sangseu/kicad/project/charger v2/pics/48V1A.png

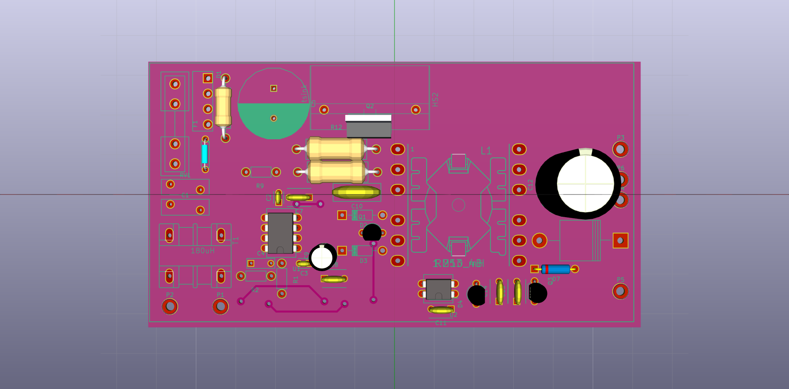
project/charger v2/pics/48V1A.png
