sangseu/kicad/project/charger v2/v1.jpg

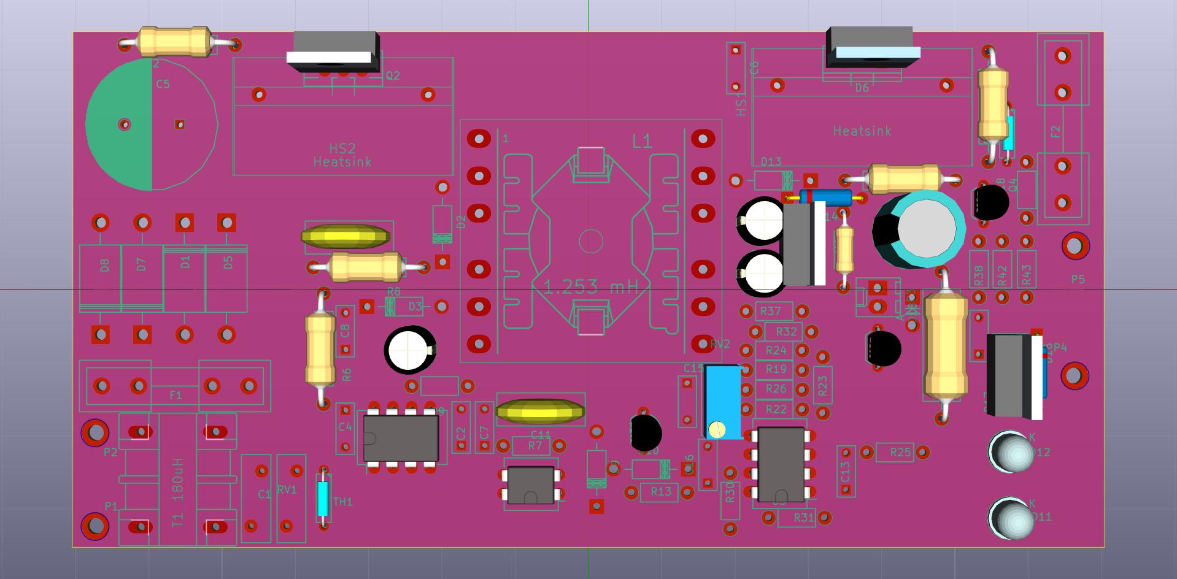
project/charger v2/v1.jpg
