sangseu/kicad/project/README.txt

log
===
1. chager v1: so cap, phan hoi dien ap dung thong so. Mach dieu khien dong sac, dieu khien ngat sac SAI
2. 48V-1A: chay OK nhow su giup so cua anh Toan
3. 48V-2A. 48V-3A SAI
