sangseu/kicad/project/charger v2/linh_kien.pdf

››Giỏ hàng của bạn có: 144(SP),Tổng số tiền: 179100 VNĐ (flow.php) | Mua Hàng Online: 1900.03.44
(https://www.youtube.com/channel/UCSeca92q0ZaRIcLOcsNsQyg/) | (article-506-tra-cuu-ma-van-don.html)
(article_cat-36-tin-tuc.html) | (https://www.youtube.com/channel/UCSeca92q0ZaRIcLOcsNsQyg/) | (article_cat-40-download.html)
(article-450-gio-lam-viec-va-thong-tin-lien-he.html) | (http://banlinhkien.vn/article-471-phuong-thuc-thanh-toan-mua-hang-online.html)
(http://mcu.banlinhkien.vn) | (article-625-trung-tam-bao-hanh.html)

(user.php)

## Đăng

nhập (user.php) | Đăng ký (user.php?act=register)
Tất cả danh mục | Tìm kiếm... | Tìm kiếm

(http://banlinhkien.vn)

Vị trí » Trang chủ (.) > Sản phẩm trong giỏ hàng của bạn:

Từ khóa HOT ： Vi Điều Khiển (search.php?keywords=Vi+%C4%90i%E1%BB%81u+Khi%E1%BB%83n) Mạch Nạp (search.php?keywords=+M%E1%BA%A1ch+N

%E1%BA%A1p) LED (search.php?keywords=+LED) KIT (search.php?keywords=+KIT) Cảm Biến (search.php?keywords=+C%E1%BA%A3m+Bi%E1%BA%BFn)

Module (search.php?keywords=+Module) Thiết Bị Kỹ Thuật (search.php?keywords=+Thi%E1%BA%BFt+B%E1%BB%8B+K%E1%BB%B9+Thu%E1%BA%ADt)

## Danh sách SP

Tên SP | Thuộc tính | Giá | SL | Tổng | Thao Tác
(goods.php?id=936) Tụ Gốm 103 10nF 50V ( 10C) (goods.php?id=936) | | 1000 VNĐ | | | | 1000 VNĐ | [X]Xóa
(goods.php?id=1369) TIP122 TO220 TRANS DarLingTon NPN 5A 100V (goods.php?id=1369) | | 3000 VNĐ | | | | 6000 VNĐ | [X]Xóa
(goods.php?id=1372) BT151-500R TO220 THYRISTOR 12A 500V (goods.php?id=1372) | | 4500 VNĐ | | | | 9000 VNĐ | × [X]Xóa

1

2

2

(https://www.youtube.com

/channel

/UCSeca92q0ZaRIcLOcsNsQ (https://www.facebook.com

/banlinhkienMH

(https://plus.google.com

/+LinhKi

%E1%BB

%87n%C4

%90i%E1

%BB%87nT

%E1%BB

%ADMinhH

%C3%A0

## Hỗ Trợ Khách Hàng Và Kỹ Thuật

Sản phẩm trong giỏ hàng của bạn:_Linh Kiện Điệ... | http://banlinhkien.vn/flow.php
1 of 10 | 03/16/2017 05:53 PM

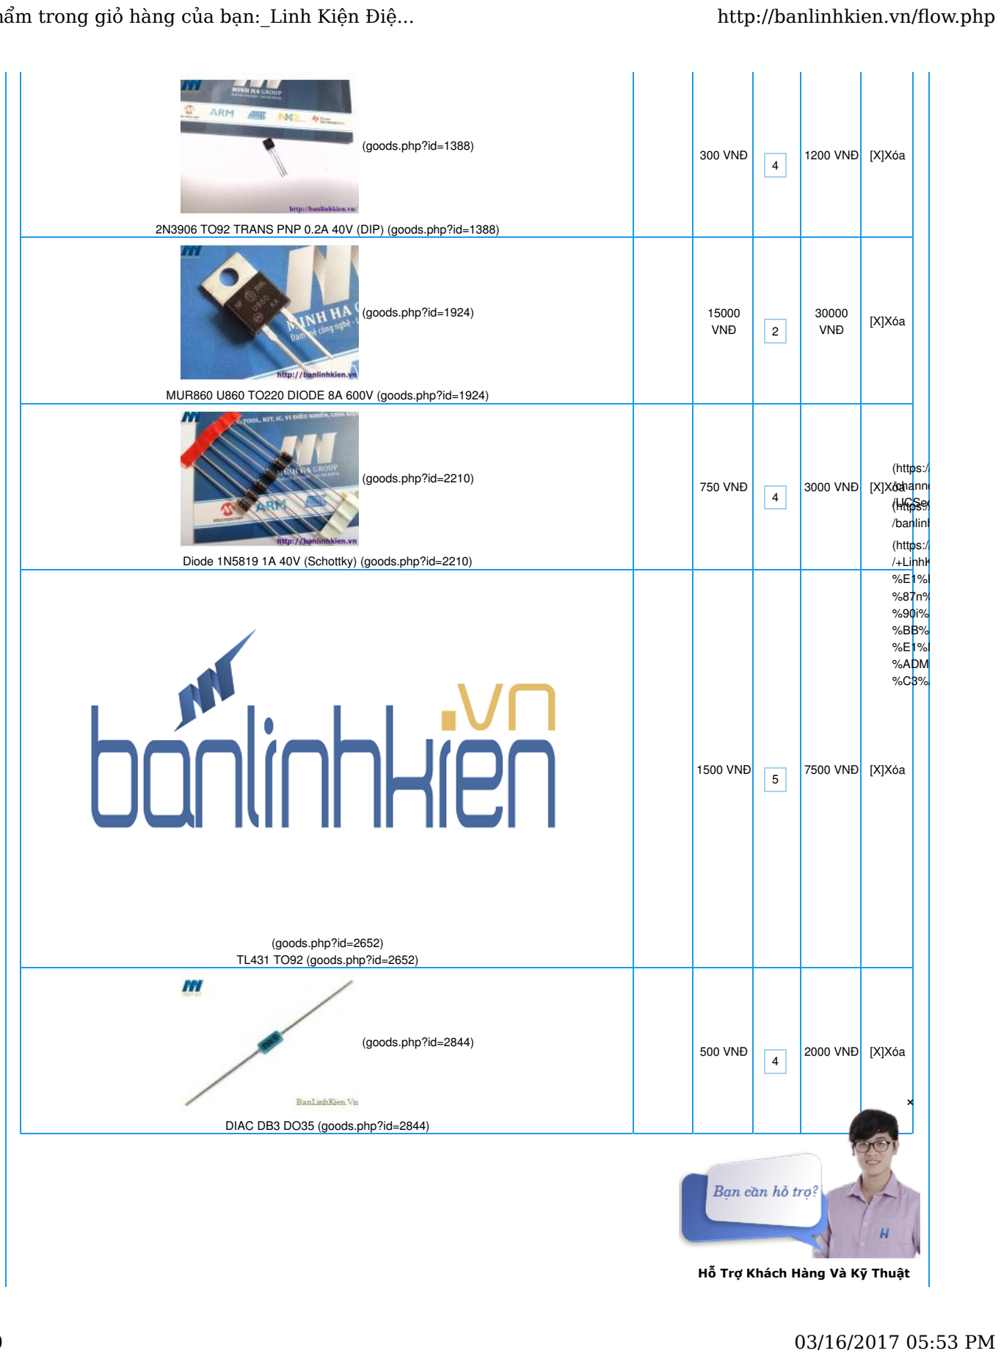
[picture p172: figure]
(goods.php?id=1388); 300 VNĐ; 1200 VNĐ; [X]Xóa; (goods.php?id=1924); VNĐ; (goods.php?id=2652) TL431 TO92 (goods.php?id=2652); 1500 VNĐ; 7500 VNĐ; (goods.php?id=2844) DIAC DB3 DO35 (goods.php?id=2844); 500 VNĐ; 2000 VNĐ; [X]Xóa ×; (https://www.youtube.com; /channel; /UCSeca92q0ZaRIcLOcsNsQ (https://www.facebook.com; /banlinhkienMH; (https://plus.google.com; /+LinhKi; %ADMinhH; Hỗ Trợ Khách Hàng Và Kỹ Thuật

2N3906 TO92 TRANS PNP 0.2A 40V (DIP) (goods.php?id=1388)

MUR860 U860 TO220 DIODE 8A 600V (goods.php?id=1924)

(goods.php?id=2210) Diode 1N5819 1A 40V (Schottky) (goods.php?id=2210) | 750 VNĐ | 3000 VNĐ | [X]Xóa

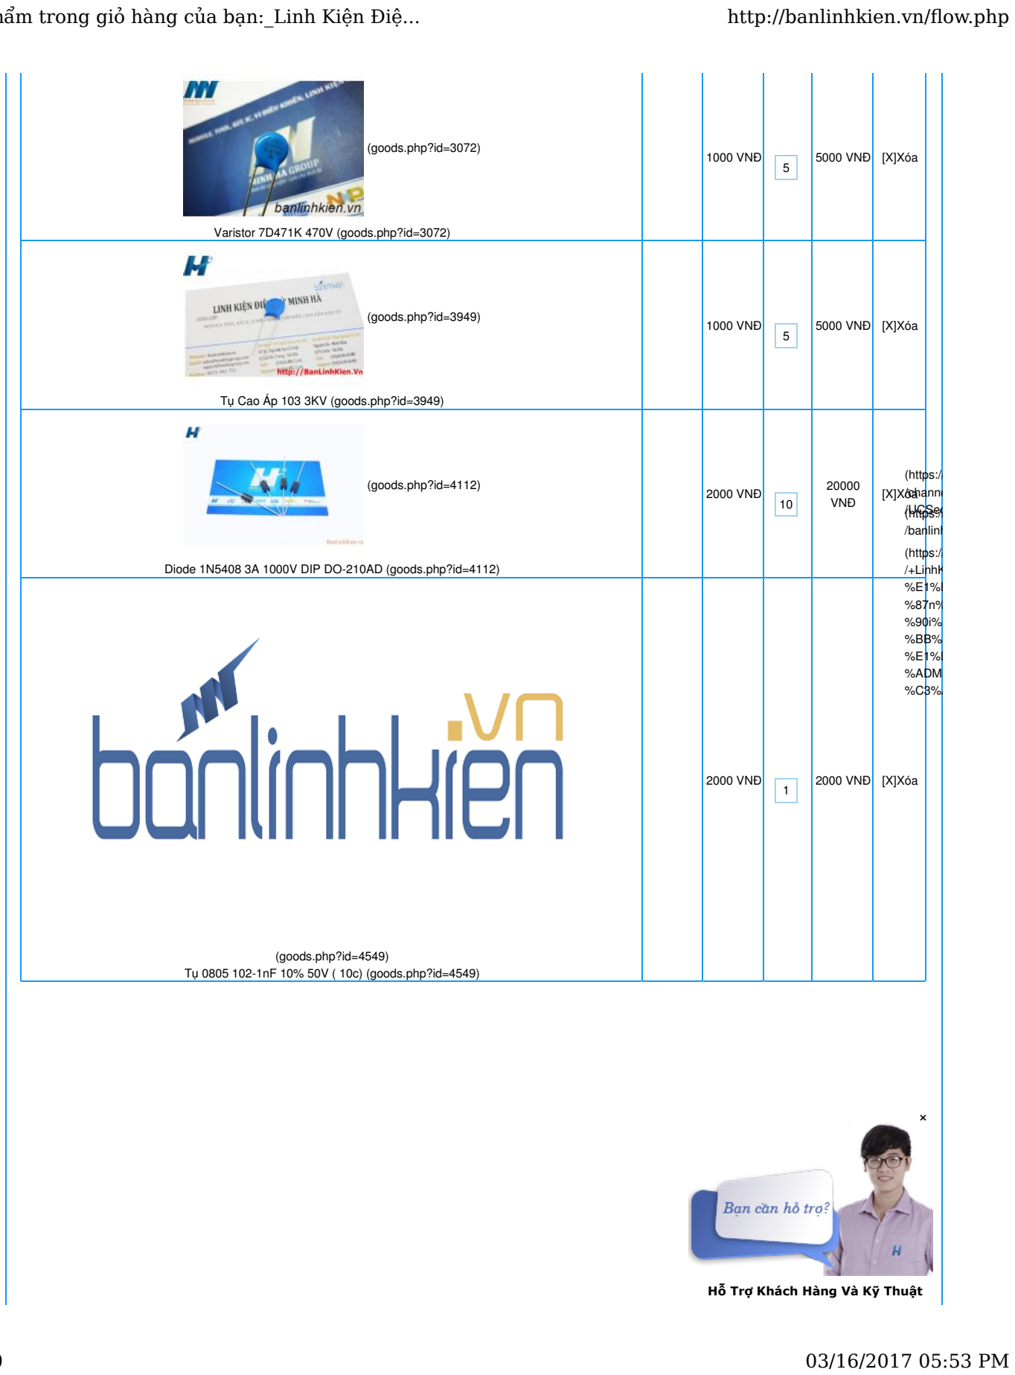
[picture p173: figure]
(goods.php?id=3072); 1000 VNĐ; 5000 VNĐ; [X]Xóa; /channel; /banlinhkienMH; (https://plus.google.com; /+LinhKi; %ADMinhH; Hỗ Trợ Khách Hàng Và Kỹ Thuật

Varistor 7D471K 470V (goods.php?id=3072)

(goods.php?id=3949) Tụ Cao Áp 103 3KV (goods.php?id=3949) | 1000 VNĐ | 5000 VNĐ | [X]Xóa
(goods.php?id=4112) Diode 1N5408 3A 1000V DIP DO-210AD (goods.php?id=4112) | 2000 VNĐ | | 20000 VNĐ | [X]Xóa
(goods.php?id=4549) Tụ 0805 102-1nF 10% 50V ( 10c) (goods.php?id=4549) | 2000 VNĐ | | 2000 VNĐ | [X]Xóa

(https://www.youtube.com

/UCSeca92q0ZaRIcLOcsNsQ (https://www.facebook.com

(goods.php?id=4551)
Tụ 0805 104-100nF 10% 50V (10c) (goods.php?id=4551)

2000 VNĐ
1
2000 VNĐ | [X]Xóa
(goods.php?id=4708) S8050 SOT23 Trans NPN 0.5A 40V (SMD-J3Y) (goods.php?id=4708) | 300 VNĐ | 1500 VNĐ | [X]Xóa
(goods.php?id=4761) Tụ Gốm 104 100nF 50V ( 10c) (goods.php?id=4761) | 1000 VNĐ | 1000 VNĐ | [X]Xóa
(goods.php?id=4776) Tụ gốm 470p 471 50V( 10C) (goods.php?id=4776) | 1000 VNĐ | 1000 VNĐ | [X]Xóa
(goods.php?id=4777) Tụ gốm 472-4.7nF 50V (10c) (goods.php?id=4777) | 1000 VNĐ | 1000 VNĐ | [X]Xóa ×

5

1

1

1

(https://www.youtube.com

/channel

/UCSeca92q0ZaRIcLOcsNsQ (https://www.facebook.com

/banlinhkienMH

(https://plus.google.com

/+LinhKi

%E1%BB

%87n%C4

%90i%E1

%BB%87nT

%E1%BB

%ADMinhH

%C3%A0

## Hỗ Trợ Khách Hàng Và Kỹ Thuật

(goods.php?id=4948)

Trở Vạch 1/4W 5% 15K (50c) (goods.php?id=4948)

2000 VNĐ
1
2000 VNĐ | [X]Xóa
(goods.php?id=4957) Trở Vạch 1/4W 5% 20K (50c) (goods.php?id=4957) | 2000 VNĐ | 2000 VNĐ | [X]Xóa
(goods.php?id=4964) Trở Vạch 1/4W 5% 27K (50c) (goods.php?id=4964) | 2000 VNĐ | | 2000 VNĐ | [X]Xóa
(goods.php?id=4967) Trở Vạch 1/4W 5% 3.9K (50c) (goods.php?id=4967) | 2000 VNĐ | | 2000 VNĐ | [X]Xóa
(goods.php?id=4991) Trở Vạch 1/4W 5% 56K (50c) (goods.php?id=4991) | 2000 VNĐ | | 2000 VNĐ | [X]Xóa
(goods.php?id=4996) Trở Vạch 1/4W 5% 7.5K (50c) (goods.php?id=4996) | 2000 VNĐ | | 2000 VNĐ | [X]Xóa
(goods.php?id=5164) Gen Co Nhiệt Phi 10 Đen (1 Mét) (goods.php?id=5164) | 9000 VNĐ | | 9000 VNĐ | × [X]Xóa

1

1

1

1

1

1

(https://www.youtube.com

/channel

/UCSeca92q0ZaRIcLOcsNsQ (https://www.facebook.com

/banlinhkienMH

(https://plus.google.com

/+LinhKi

%E1%BB

%87n%C4

%90i%E1

%BB%87nT

%E1%BB

%ADMinhH

%C3%A0

## Hỗ Trợ Khách Hàng Và Kỹ Thuật

(goods.php?id=5251)

Trở 0805 5% 100R (50c) (goods.php?id=5251)

2000 VNĐ
1
2000 VNĐ | [X]Xóa
(goods.php?id=5305) Trở 0805 5% 3.3K (50c) (goods.php?id=5305) | 2000 VNĐ | 2000 VNĐ | [X]Xóa
(goods.php?id=5312) Trở 0805 5% 8.2K (50c) (goods.php?id=5312) | 2000 VNĐ | | 2000 VNĐ | [X]Xóa
(goods.php?id=5479) Trở 0805 1% 49.9K (50c) (goods.php?id=5479) | 4000 VNĐ | | 4000 VNĐ | [X]Xóa
(goods.php?id=5704) Diode FR207 2A 1000V ( DIP) (goods.php?id=5704) | 500 VNĐ | | 2500 VNĐ | [X]Xóa

1

1

1

5

(https://www.youtube.com

/channel

/UCSeca92q0ZaRIcLOcsNsQ (https://www.facebook.com

/banlinhkienMH

(https://plus.google.com

/+LinhKi

%E1%BB

%87n%C4

%90i%E1

%BB%87nT

%E1%BB

%ADMinhH

%C3%A0

## Hỗ Trợ Khách Hàng Và Kỹ Thuật

×

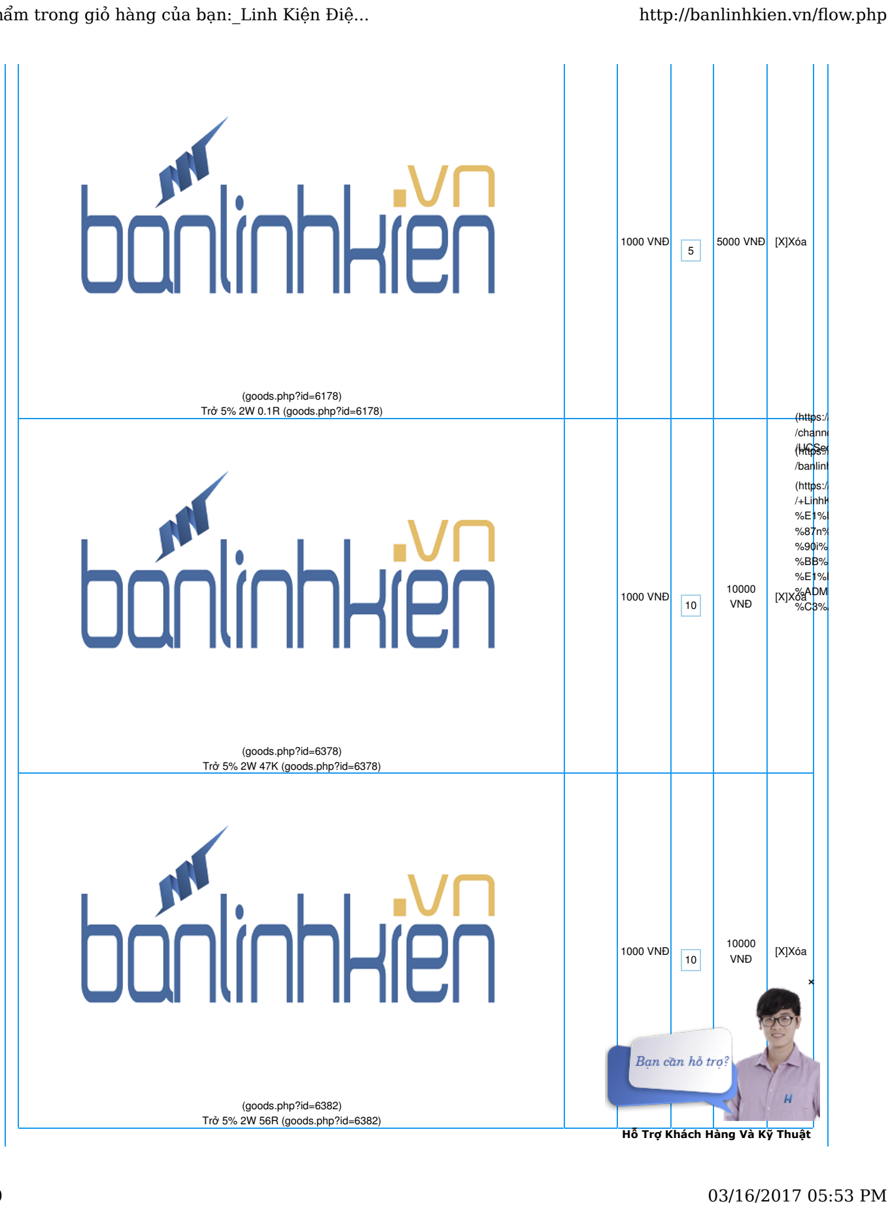
[picture p174: figure]
(goods.php?id=6178); Trở 5% 2W 0.1R (goods.php?id=6178); 1000 VNĐ; 5000 VNĐ; [X]Xóa; /channel; /banlinhkienMH; (https://plus.google.com; /+LinhKi; %ADMinhH; Hỗ Trợ Khách Hàng Và Kỹ Thuật

(goods.php?id=6378) Trở 5% 2W 47K (goods.php?id=6378) | 1000 VNĐ | 10000 VNĐ | [X]Xóa
(goods.php?id=6382) Trở 5% 2W 56R (goods.php?id=6382) | 1000 VNĐ | 10000 VNĐ | [X]Xóa ×

(https://www.youtube.com

/UCSeca92q0ZaRIcLOcsNsQ (https://www.facebook.com

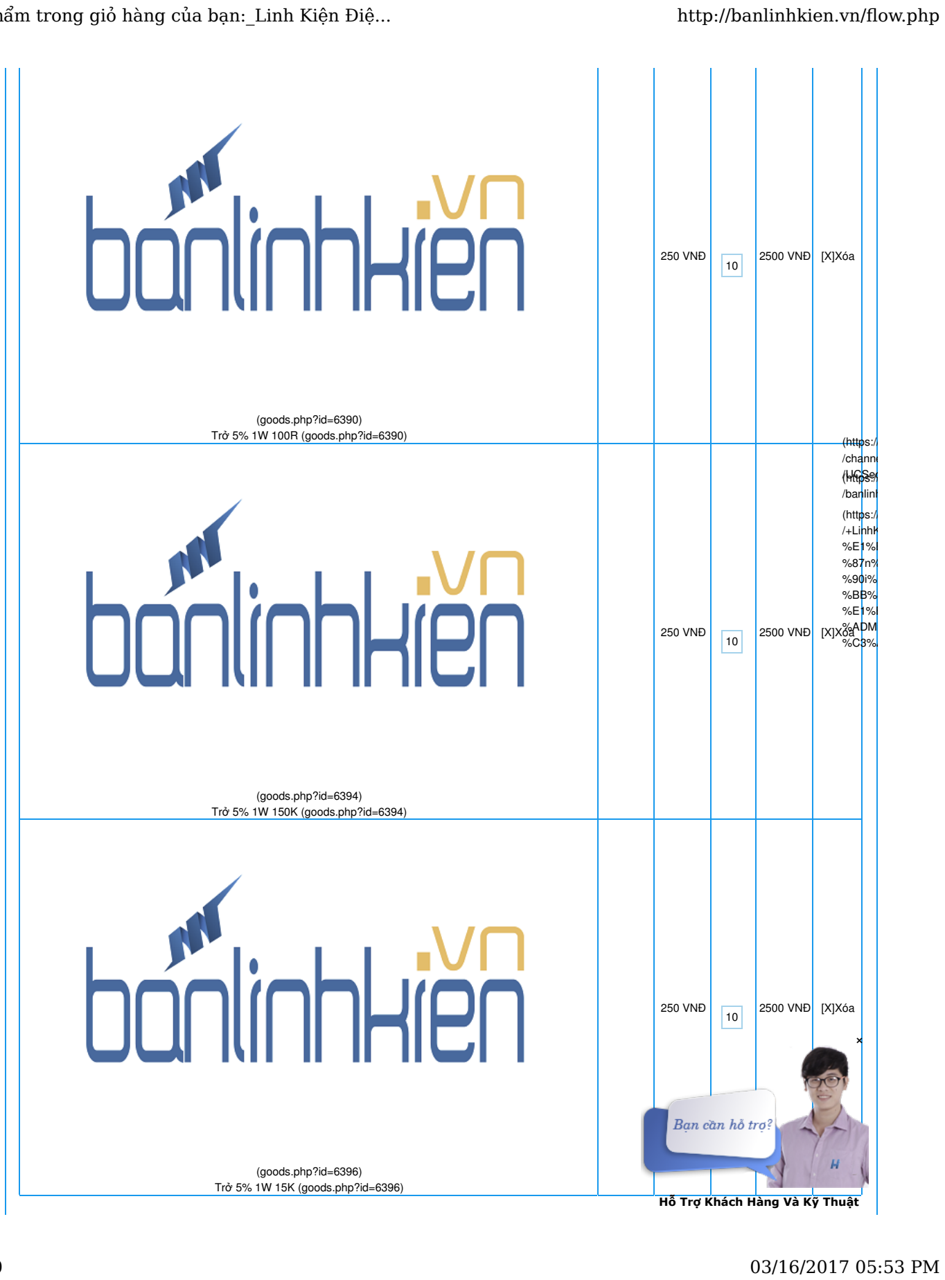
[picture p175: figure]
(goods.php?id=6390); Trở 5% 1W 100R (goods.php?id=6390); 250 VNĐ; 2500 VNĐ; [X]Xóa; /channel; /banlinhkienMH; (https://plus.google.com; /+LinhKi; %ADMinhH; Hỗ Trợ Khách Hàng Và Kỹ Thuật

(goods.php?id=6394) Trở 5% 1W 150K (goods.php?id=6394) | 250 VNĐ | 2500 VNĐ | [X]Xóa
(goods.php?id=6396) Trở 5% 1W 15K (goods.php?id=6396) | 250 VNĐ | 2500 VNĐ | [X]Xóa ×

(https://www.youtube.com

/UCSeca92q0ZaRIcLOcsNsQ (https://www.facebook.com

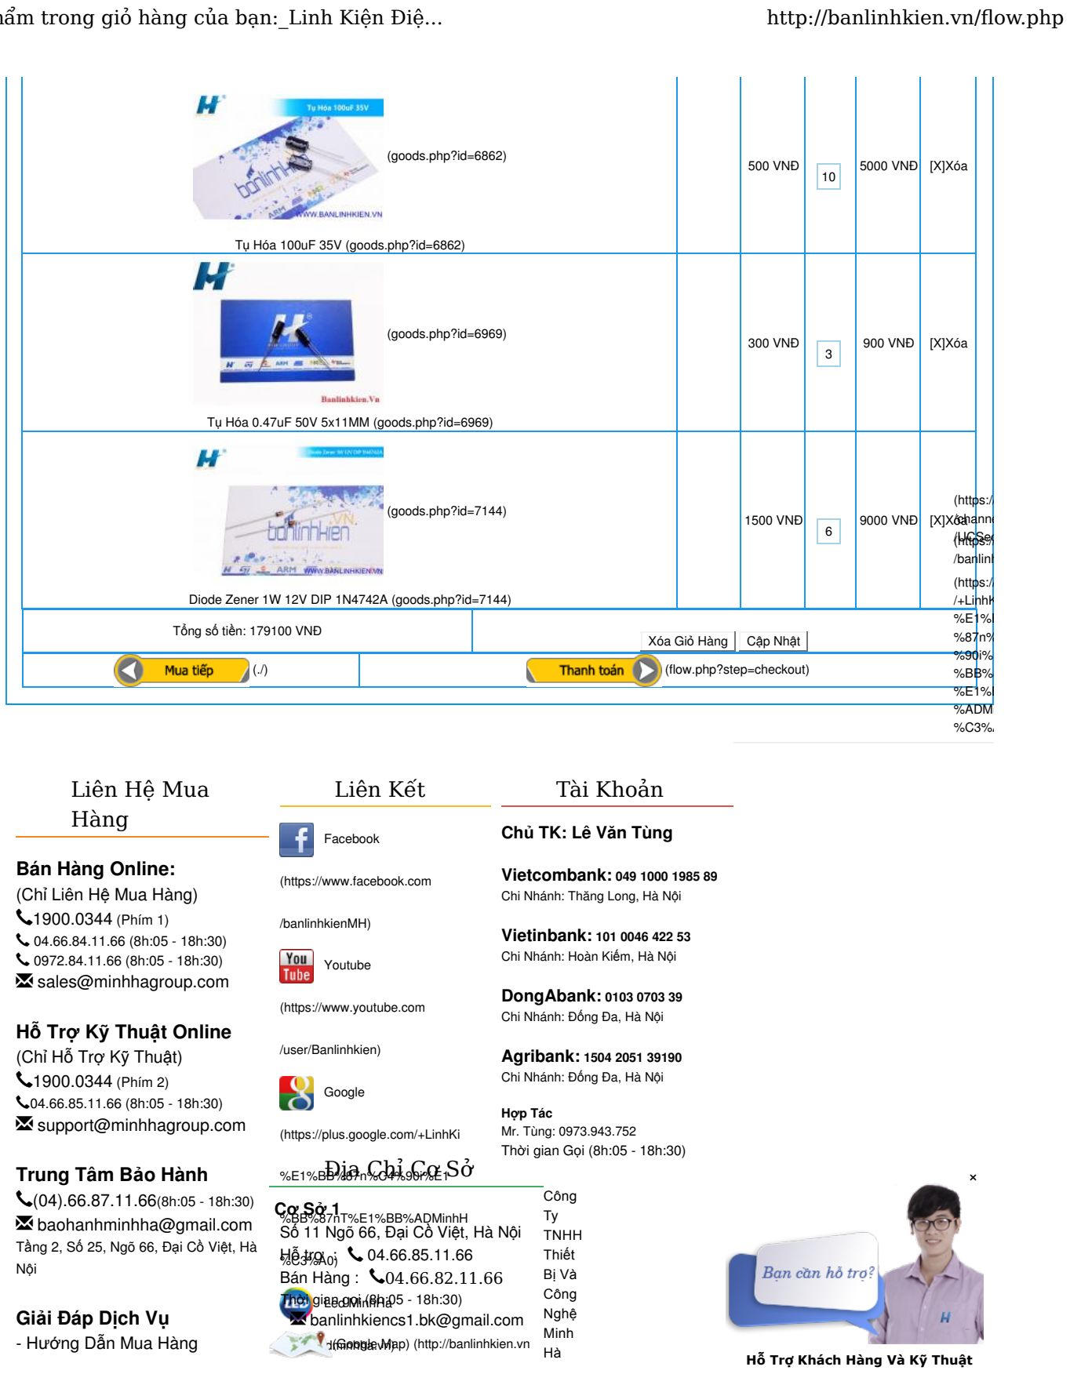
[picture p176: figure]
Liên Hệ Mua Hàng; Bán Hàng Online:; (Chỉ Liên Hệ Mua Hàng); 1900.0344 (Phím 1); sales@minhhagroup.com; Hỗ Trợ Kỹ Thuật Online; (Chỉ Hỗ Trợ Kỹ Thuật); 1900.0344 (Phím 2); support@minhhagroup.com; Trung Tâm Bảo Hành; baohanhminhha@gmail.com; Tầng 2, Số 25, Ngõ 66, Đại Cồ Việt, Hà; Nội; Giải Đáp Dịch Vụ; - Hướng Dẫn Mua Hàng; Liên Kết; Facebook; (https://www.facebook.com; /banlinhkienMH); Youtube; (https://www.youtube.com; /user/Banlinhkien); Google; (https://plus.google.com/+LinhKi; %BB%87nT%E1%BB%ADMinhH; Led MinhHa; (http://ledminhha.vn); Tài Khoản; Chủ TK: Lê Văn Tùng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

(goods.php?id=6969) Tụ Hóa 0.47uF 50V 5x11MM (goods.php?id=6969) | 300 VNĐ | 900 VNĐ | [X]Xóa
(goods.php?id=7144) Diode Zener 1W 12V DIP 1N4742A (goods.php?id=7144) | 1500 VNĐ | | 9000 VNĐ | [X]Xóa

(http://www.online.gov.vn/HomePage/CustomWebsiteDisplay.aspx?DocId=10200)

## - Hành Trình Bưu

## - Giải Đáp Thắc Mắc

## - Than Phiền Dịch Vụ

0965.89.11.66 (8h:05 - 18h:30)

## 1900.0344 (Phím 0)

### Giới Thiệu

### Đặt mua linh kiện

### (http://banlinhkien.vn/article-

### 473-dat-mua-linh-kien.html)

### Mua hàng & Thanh Toán

### (http://banlinhkien.vn/article-

### 471-phuong-thuc-thanh-toan-mua-

### hang-online.html)

### Đổi, trả hàng và hoàn tiền

### (http://banlinhkien.vn/article-

### 513-chinh-sach-doi-tra-hang-

### va-hoan-tien.html)

### Bảo mật thông tin

### (http://banlinhkien.vn/article-

### 515-chinh-sach-bao-mat-thong-

### tin-khach-hang.html)

Diễn Đàn Vi Điều Khiển

(http://mcu.banlinhkien.vn)

/article-516-cua-hang-ban-linh-kien-co-so-

1.html#.VKDB-PaAEI)

## Cơ Sở 2

Số 2 ngách 132/86 Nguyên Xá,

### Đường 32, Từ Liêm

Hỗ trợ: | 04.66.86.66.41
Bán hàng : | 04.66.86.66.40

Thời gian gọi (8h:05 - 18h:30)

### banlinhkien.dhcn@gmail.com

(Google Map) (http://banlinhkien.vn

/article-520-linh-kien-dien-tu-minh-ha-co-

so-2.html)

## Cơ Sở 3

### 25 Đặng Thùy Trâm, Cầu Giấy

Hỗ trợ | : | 04.66.54.25.25
Bán hàng : | 04.66.52.25.25

Thời gian gọi (8h:05 - 18h:30)

### banlinhkiencs3.hvqs@gmail.com

(Google Map) (http://banlinhkien.vn

/article.php?id=606)

## Cơ Sở 4 (COMING SOON)

### 106/5 Nguyễn Kim - P.6 - Q.10 -

### HCM

## Trụ sở: Đại Vĩ - Liên Hà - Đông Anh - Hà Nội GPĐKKD Số: 01.05.165.062 Do Sở KH VÀ ĐT TP.HN cấp ngày: 28.02.2011

(http://www.dmca.com/Protection/Status.aspx?ID=7d46bd30-a53e-43a5-

a925-9baaa62549b7&refurl=http://banlinhkien.vn/)

✉

✉

(https://www.youtube.com

/channel

/UCSeca92q0ZaRIcLOcsNsQ (https://www.facebook.com

/banlinhkienMH

(https://plus.google.com

/+LinhKi

%E1%BB

%87n%C4

%90i%E1

%BB%87nT

%E1%BB

%ADMinhH

%C3%A0

## Hỗ Trợ Khách Hàng Và Kỹ Thuật

×
