sangseu/kicad/project/charger v2/linhkien.pdf

v1

Id Designator | Package | Quantity
70 C13,C16 | C_Rect_L7_W2.5_P5 | 2
42 R35 | Resistor_Horizontal_RM20mm | 1
57 R12 | Resistor_Horizontal_RM15mm | 1
20L1 | trafo-siemens-RM8-12A | 1
2 C1 | RV_Disc_D12_W4_P7.5 | 1
3 C4,C8,C19 | C_Rect_L7_W2.5_P5 | 3
45 R39 | R_0805_HandSoldering | 1
41 R34 | Resistor_Horizontal_RM10mm | 1
66 C17 | C_Radial_D6.3_L11.2_P2.5 | 1
6 C10,C11 | C_Disc_D12_P7.75 | 2
28 R2,R4,R28,R29 | R_0805_HandSoldering | 4
32 R10,R33 | R_0805_HandSoldering | 2
49 RV1 | RV_Disc_D12_W3.9_P7.5 | 1
30 R6 | Resistor_Horizontal_RM15mm | 1
29 R5 | R_0805_HandSoldering | 1
48 R43,R38 | Resistor_Horizontal_RM7mm | 2
35 R15 | Resistor_Horizontal_RM15mm | 1
51 T1 | inductors-MFE | 1
33 R11,R14 | R_0805_HandSoldering | 2
34 R13,R30,R31,R32,R26,R7,R25 Resistor_Horizontal_RM7mm | 7
76 R22 | Resistor_Horizontal_RM7mm | 1
12 D9,D10 | Diode_DO-41_SOD81_Horizontal_RM10 | 2
75 D18 | Diode_DO-41_SOD81_Vertical_AnodeUp | 1
8 D1,D5,D7,D8 | Diode_DO-201AD_Horizontal_RM15 | 4
10 D3 | Diode_DO-41_SOD81_Horizontal_RM10 | 1
61 C3 | C_0805_HandSoldering | 1
71 C15 | C_Rect_L7_W2.5_P5 | 1
43 R36,R41 | R_0805_HandSoldering | 2
47 R42 | Resistor_Horizontal_RM7mm | 1
25 Q2 | TO-220_Neutral123_Vertical_LargePads | 1
67 C18 | C_Radial_D6.3_L11.2_P2.5 | 1
7 C14 | C_0805_HandSoldering | 1
38 R18,R19 | Resistor_Horizontal_RM7mm | 2
27 Q4 | TO-92_Inline_Wide | 1
65 C12 | C_Radial_D10_L21_P5 | 1
37 R17 | R_0805_HandSoldering | 1
31 R9 | Resistor_Horizontal_RM7mm | 1
44 R37 | Resistor_Horizontal_RM7mm | 1
46 R40 | R_0805_HandSoldering | 1
40 R21 | R_0805_HandSoldering | 1
36 R16 | R_0805_HandSoldering | 1
60 C2 | C_Rect_L7_W2.5_P5 | 1
68 C7 | C_Rect_L7_W2.5_P5 | 1
64 C6 | C_Rect_L7_W2.5_P5 | 1
58 R8 | Resistor_Horizontal_RM15mm | 1
5 C9 | C_Radial_D6.3_L11.2_P2.5 | 1
73 R24 | Resistor_Horizontal_RM7mm | 1
72 R23 | Resistor_Horizontal_RM7mm | 1

63 R3 | Resistor_Horizontal_RM15mm | 1
52 TH1 | R3 | 1
53 TH2 | R3 | 1
4 C5 | C_Radial_D18_L36_P7.5 | 1
39 R20 | R_0805_HandSoldering | 1
59 R1 | R_0805_HandSoldering | 1
17 D17 | Diode_TO-220_Dual_CommonCathode_Vertical | 1
13 D11 | LED-5MM | 1
15 D14 | Diode_DO-35_SOD27_Horizontal_RM10 | 1
16 D16 | Diode_DO-35_SOD27_Horizontal_RM10 | 1
23 P3 | Molex_KK-6410-02_02x2.54mm_Straight | 1
9 D2,D13 | Diode_DO-41_SOD81_Horizontal_RM10 | 2
18 F1 | Fuseholder5x20_horiz_open_inline_Type-I | 1
69 F2 | Fuseholder5x20_horiz_open_inline_Type-I | 1
19 HS1,HS2 | heatsink-D03PA | 2
21 P1 | MountingHole_2.2mm_M2_DIN965_Pad | 1
22 P2 | MountingHole_2.2mm_M2_DIN965_Pad | 1
56 U3 | DIP-8_W7.62mm_LongPads | 1
62 D6 | Diode_TO-220_Vertical | 1
1 P4 | MountingHole_2.2mm_M2_DIN965_Pad | 1
24 P5 | MountingHole_2.2mm_M2_DIN965_Pad | 1
55 U2 | DIP-4_W7.62mm | 1
14 D12 | LED-5MM | 1
50 RV2 | Potentiometer_Bourns_3296W_3-8Zoll_Inline_ScrewUp | 1
26 Q3 | TO-220_Neutral123_Vertical | 1
11 D4,D15 | TO-92_Inline_Wide | 2
74 Q1 | SOT-23 | 1
54 U1 | DIP-8_W7.62mm_LongPads | 1

Page

3

Designation
103
0.1R-2W
0.33R-1W
1.253 mH
100 nF
100nF-50V
100R
100R-1W
100uF35V
103 2kv
10k
10R
14D471K
150K1W
15k
15k
15k-1W
180uH
1k
1k
1k-1%
1N4148
1N4148
1N5408
1N5819
1nF
1nF-50V
20k
20k
20N60
220uF16V
22pF25V
27k
2N3906
330uF100V
33k
33R2
3k
3k
3k
4.7k-1%
4.7nF
470pF50V
471 2kv ???
47k-2W
47uF50V
56k-1%
56k-1%

Page

4

56R-2W
5D-11
5D-13
68uF400V
10k
8.2k
BT151
charging
D_Z 12V
DIAC-DB3
FAN
FR207
Fuse-2A
Fuse-5A
Heatsink
IN1
IN2
LM358
MUR860
OUT-OUT+
PC817
power
RV-2k
TIP122
TL431LP
tran-S8050
UC3842

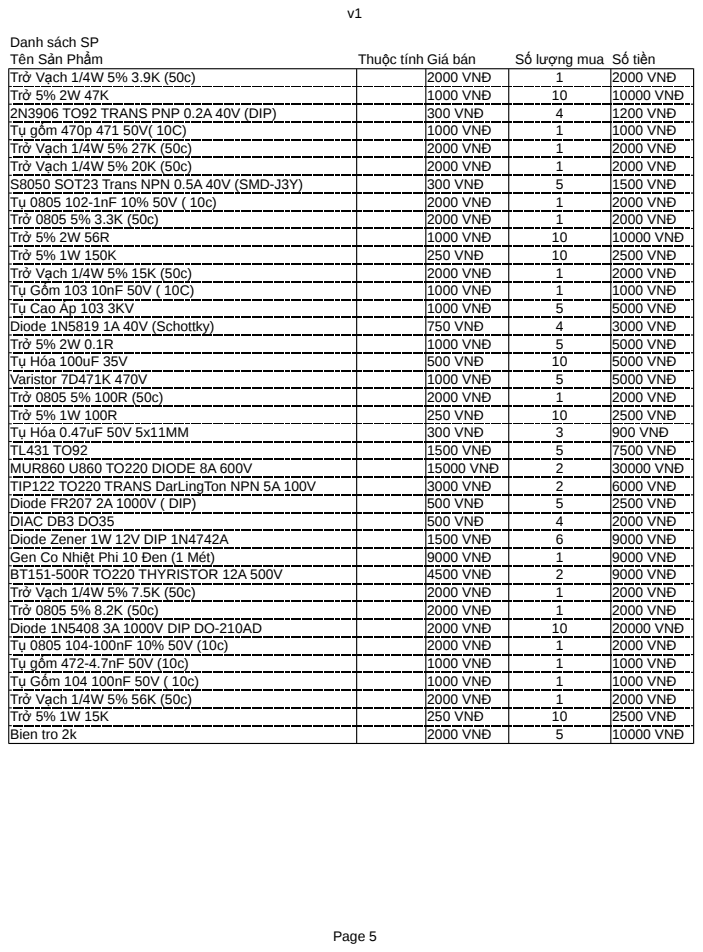
[picture p177: page 5]
Tên S n Ph m ả; Thu c tính ộ; Giá bán; S l ng mua ố ượ; 2000 VNĐ; 1000 VNĐ; 10000 VNĐ; 2N3906 TO92 TRANS PNP 0.2A 40V (DIP); 300 VNĐ; 1200 VNĐ; S8050 SOT23 Trans NPN 0.5A 40V (SMD-J3Y); 1500 VNĐ; 250 VNĐ; 2500 VNĐ; T Cao Áp 103 3KV ụ; 5000 VNĐ; Diode 1N5819 1A 40V (Schottky); 750 VNĐ; 3000 VNĐ; T Hóa 100uF 35V ụ; 500 VNĐ; Varistor 7D471K 470V; T Hóa 0.47uF 50V 5x11MM ụ; 900 VNĐ; 7500 VNĐ; MUR860 U860 TO220 DIODE 8A 600V; 15000 VNĐ; 30000 VNĐ; TIP122 TO220 TRANS DarLingTon NPN 5A 100V; 6000 VNĐ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

Danh sách SP
