sangseu/kicad/project/charger v2/pics/48V1A_2.png

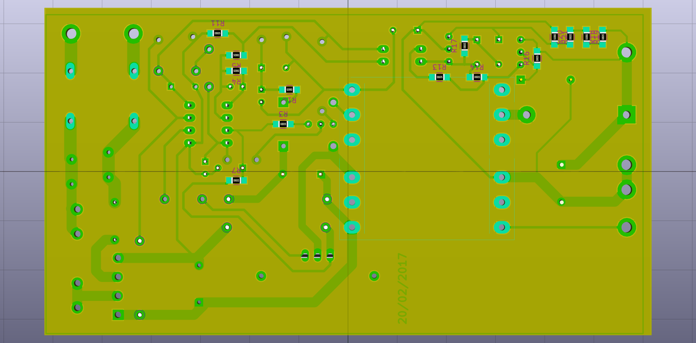
project/charger v2/pics/48V1A_2.png
