sangseu/kicad/project/charger v2/pics/dat.png

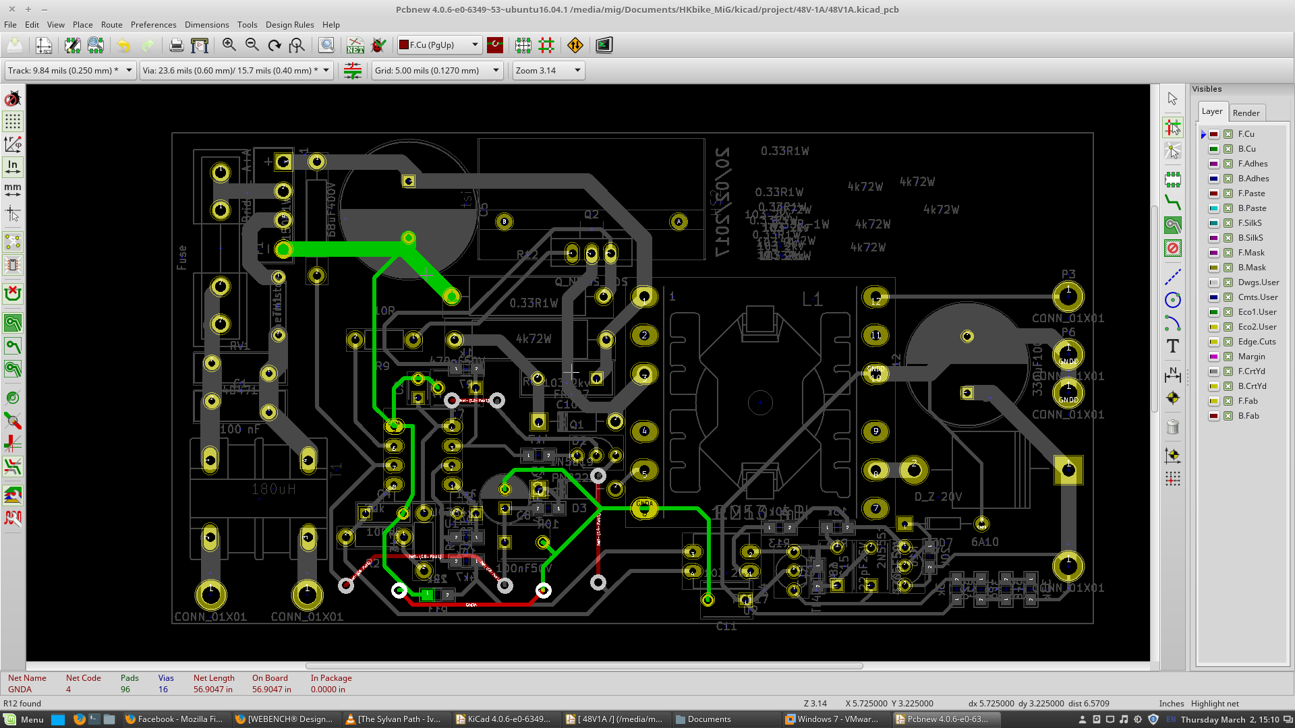
project/charger v2/pics/dat.png
