sangseu/kicad/project/charger v2/pics/do dong.png

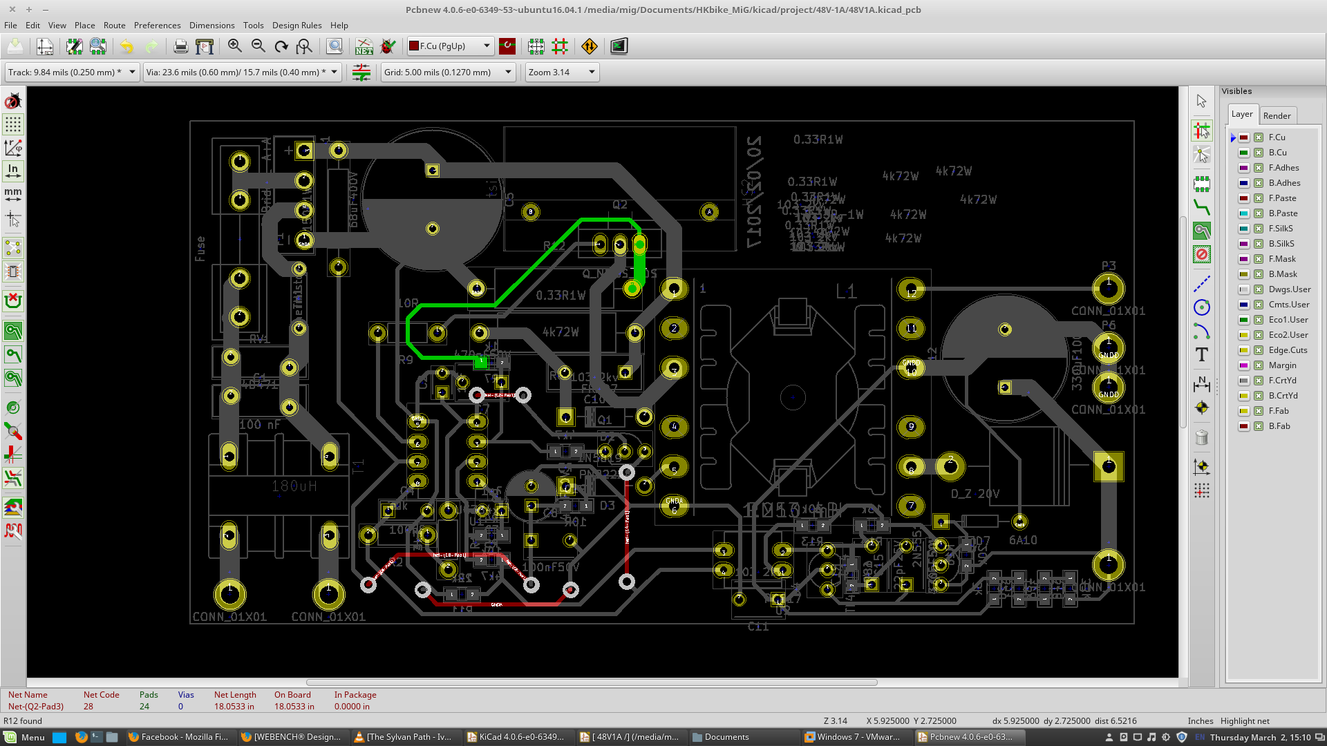
project/charger v2/pics/do dong.png
