sangseu/kicad/project/load_v3/v3.ods

Quantity | Designation | Package | Designator
2 | LM358 | DIP-8_W7.62mm_LongPads | U6,U8
1 | LM7805CT | TO-220 | U2
1 | 470uF-25V | C_Radial_D5_L6_P2.5 | C4
1 | 220uF-50V | C_Radial_D8_L11.5_P3.5 | C1
2 | LM7812CT | TO-220 | U1,U7
7 | Led_Small | LED-3MM | D3,D2,D4,D8,D14,D15,D16
2 | HEATSINK | Heatsink_Stonecold_HS-132_32x14mm_2xFixation1.5mm | HS1,HS2
1 | 1N5402 | Diode_DO-201AD_Horizontal_RM15 | D5
1 | onS | Relay_SANYOU_SRD_Series_Form_C | RL2
1 | SAC | PhoenixContact_MCV-G_02x5.08mm_Vertical | P3
1 | NGUON | PhoenixContact_MCV-G_02x5.08mm_Vertical | P2
2 | overheat | XH2.54-4P | P15,P10
2 | 0.5R | Resistor_Vertical_RM7.5mm | R64,R60
2 | 220F-25V | C_Radial_D5_L6_P2.5 | C2,C15
7 | 100nF | C_Disc_D3_P2.5 | C3,C5,C16,C17,C20,C22,C23
2 | 10uF-25V | C_Radial_D5_L6_P2.5 | C6,C7
2 | 22nF | C_Disc_D3_P2.5 | C8,C14
2 | 100nF | C_0805_HandSoldering | C9,C10
1 | 100nF | C_Rect_L7_W2.5_P5 | C11
2 | 22pF | C_0805_HandSoldering | C12,C13
1 | Diode_Bridge | Diode_Bridge_KBP206 | D1
1 | 1N4001 | Diode_DO-35_SOD27_Horizontal_RM10 | D7
3 | 5.1V | Diode_DO-35_SOD27_Horizontal_RM10 | D9,D10,D11
2 | 4001 | Diode_DO-35_SOD27_Horizontal_RM10 | D12,D13
1 | ATMEGA328-P | DIP-28_W7.62mm_LongPads | IC1
1 | 12VAC | PhoenixContact_MCV-G_02x5.08mm_Vertical | P1
1 | DS | PhoenixContact_MCV-G_02x5.08mm_Vertical | P4
1 | CONN_01X02 | Pin_Header_Straight_1x02 | P5
1 | button | XH2.54-8P | P6
1 | UART | Pin_Header_Straight_1x04 | P7
1 | FAN | XH2.54-2P | P8
1 | 7-seg | XH2.54-4P | P9
1 | G | XH2.54-3P | P11
1 | pwr | PhoenixContact_MCV-G_02x5.08mm_Vertical | P14
1 | g | XH2.54-3P | P16
3 | Q_NPN_BCE | TO-92_Molded_Wide_Oval_Reverse | Q1,Q2,Q3
2 | 2n222 | TO-92_Molded_Wide_Oval_Reverse | Q4,Q5
2 | Q_NMOS_GDS | TO-247_Vertical_Neutral123 | Q6,Q7
8 | 1k | Resistor_Horizontal_RM7mm | R1,R27,R39,R42,R43,R59,R62,R46
3 | 10k | R_0805_HandSoldering | R2,R3,R28
5 | 470R | Resistor_Horizontal_RM7mm | R6,R40,R44,R58,R61
1 | 10uH | Resistor_Horizontal_RM7mm | R7
10 | 10k | Resistor_Horizontal_RM7mm | R8,R20,R21,R26,R29,R30,R32,R34,R35,R38
10 | 0.5R | R_2512_HandSoldering | R9,R10,R11,R12,R13,R14,R15,R16,R17,R18
3 | 330R | Resistor_Horizontal_RM7mm | R24,R31,R36
2 | 8.2k | Resistor_Horizontal_RM7mm | R25,R37
1 | 180k | Resistor_Horizontal_RM7mm | R33
5 | 470R | R_0805_HandSoldering | R41,R45,R19,R47,R5
1 | 10k | Potentiometer_Bourns_3296W_3-8Zoll_Inline_ScrewUp | RV1
1 | reset | SW_PUSH_6mm | SW1
1 | Thermistor | R3 | TH2
1 | ICL7660 | PDIP-8 | U3
1 | TL431 | TO-92_Molded_Wide_Oval_Reverse | U4
1 | LM324N | DIP-14_W7.62mm_LongPads | U5
2 | 14D180V | RV_Disc_D15.5_W3.9_P7.5 | VR1,VR3
1 | 16MHz | Crystal_HC50-U_Vertical | Y1
2 | 20k | Potentiometer_Triwood_RM-065 | RV3,RV2
1 | onN | Relay_SANYOU_SRD_Series_Form_C | RL1
1 | opto | XH2.54-4P | P12
2 | PC817 | DIP-4_W7.62mm_LongPads | U9,U10
1 | tac_auto | XH2.54-2P | P13
1 | 1k | R_0805_HandSoldering | R4
