sangseu/kicad/project/load_v3/v3.xls

Quantity | Designation | Package
5 | LM358 | DIP-8
2 | HEATSINK | Heatsink_Stonecold_HS-132_32x14mm_2xFixation1.5mm
5 | Header trắng | XH2.54-4P
2 | ATMEGA8-P | DIP-28
1 | dđiện trở nhiệt | MF58 100k 3950 5%
2 | 14D180V | RV_Disc_D15.5_W3.9_P7.5
5 | biến trở tam giác | 20k
1 | công tắc gạt | MTS-103
2 | led 7 thanh-4 số | katot chung
