sangseu/kicad/project/charger v2/schematic2.pdf

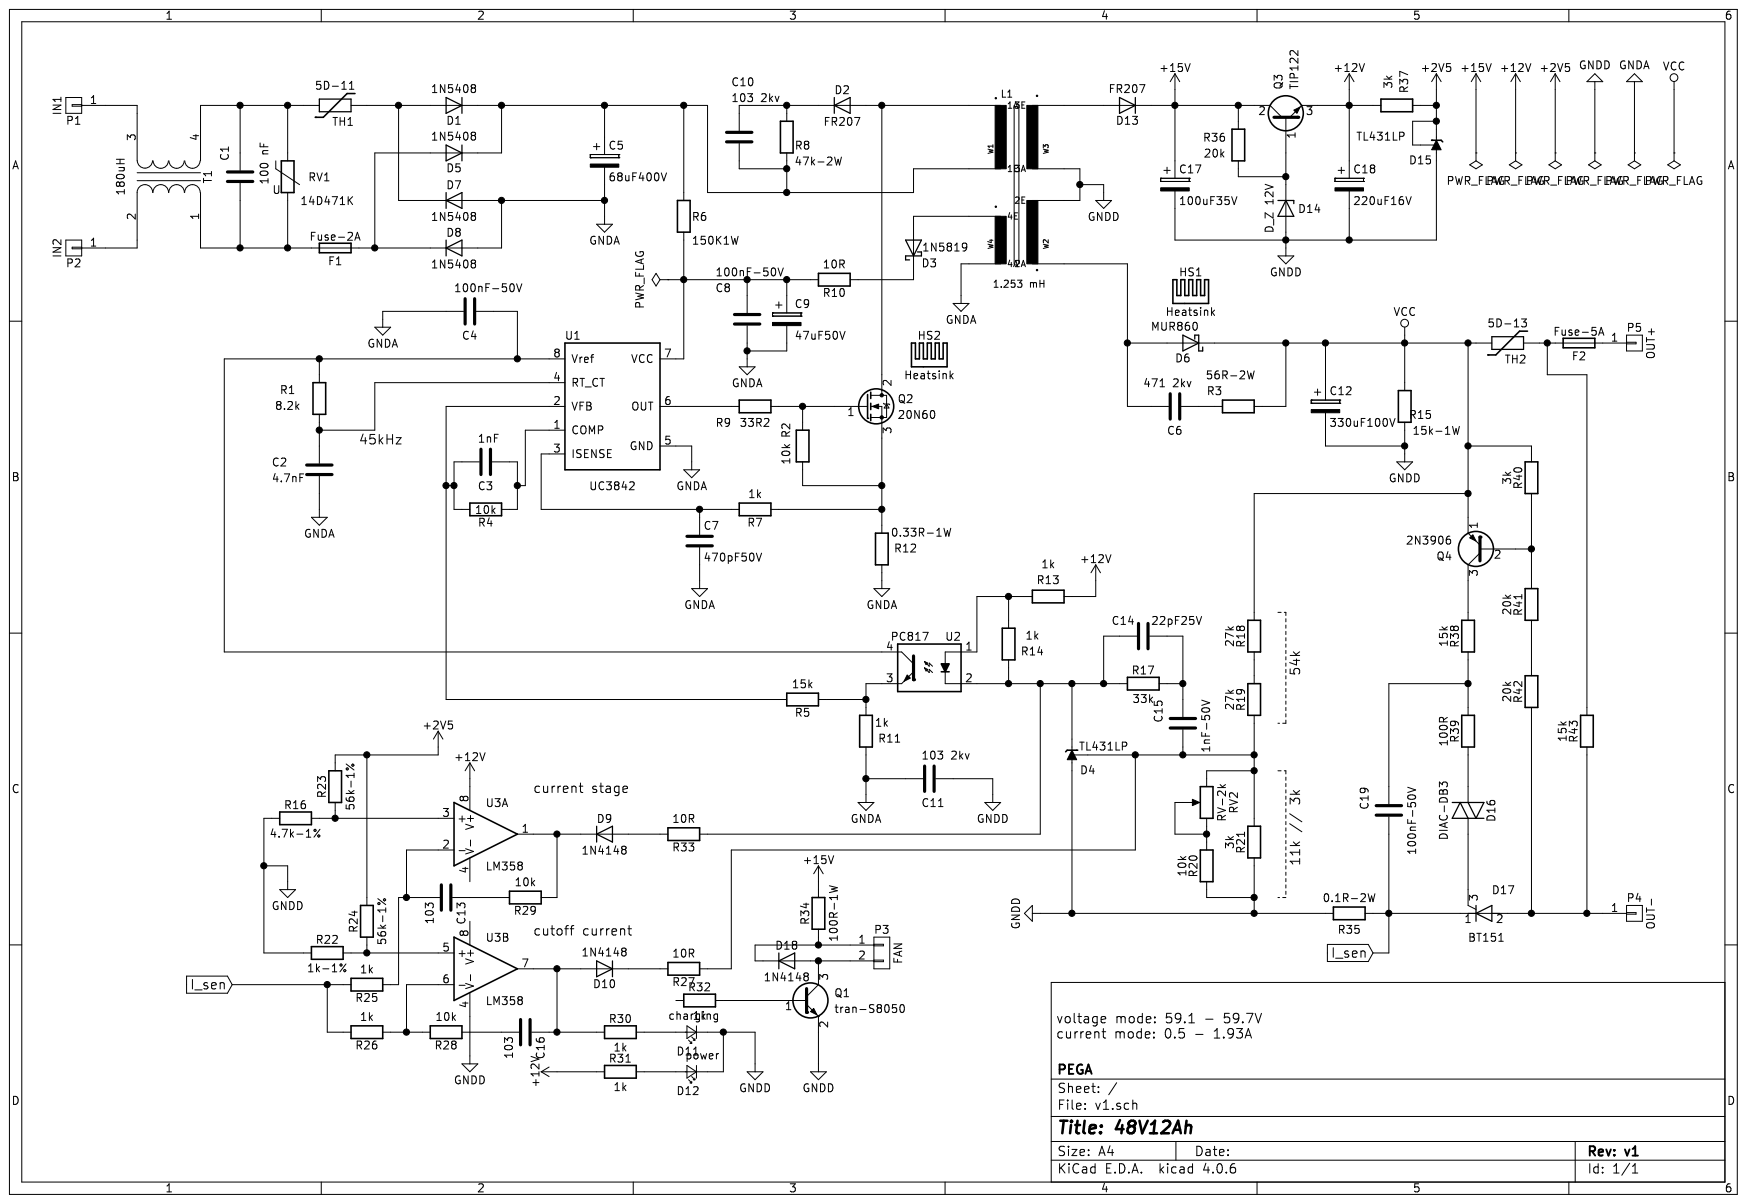
[picture p208: page 1]
