sangseu/kicad/project/charger v2/components.pdf

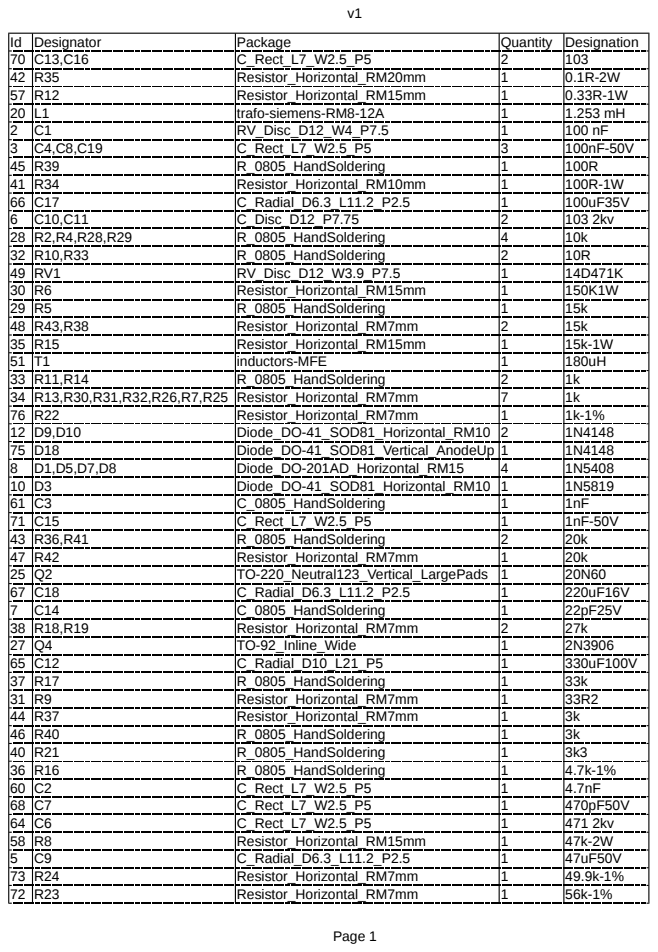
[picture p209: page 1]

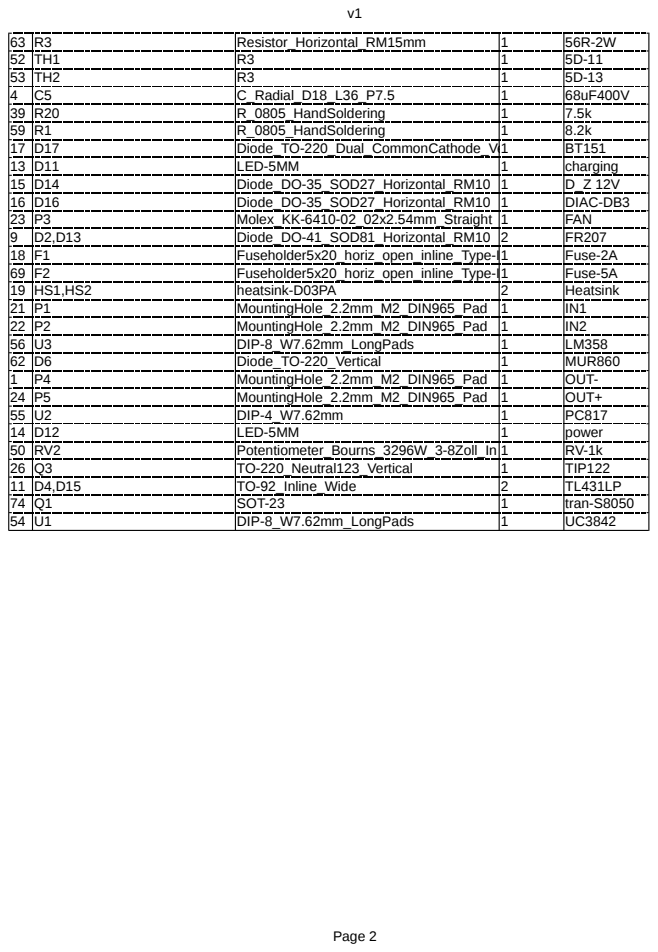
[picture p210: page 2]
