sangseu/kicad/project/charger v2/schematic.pdf

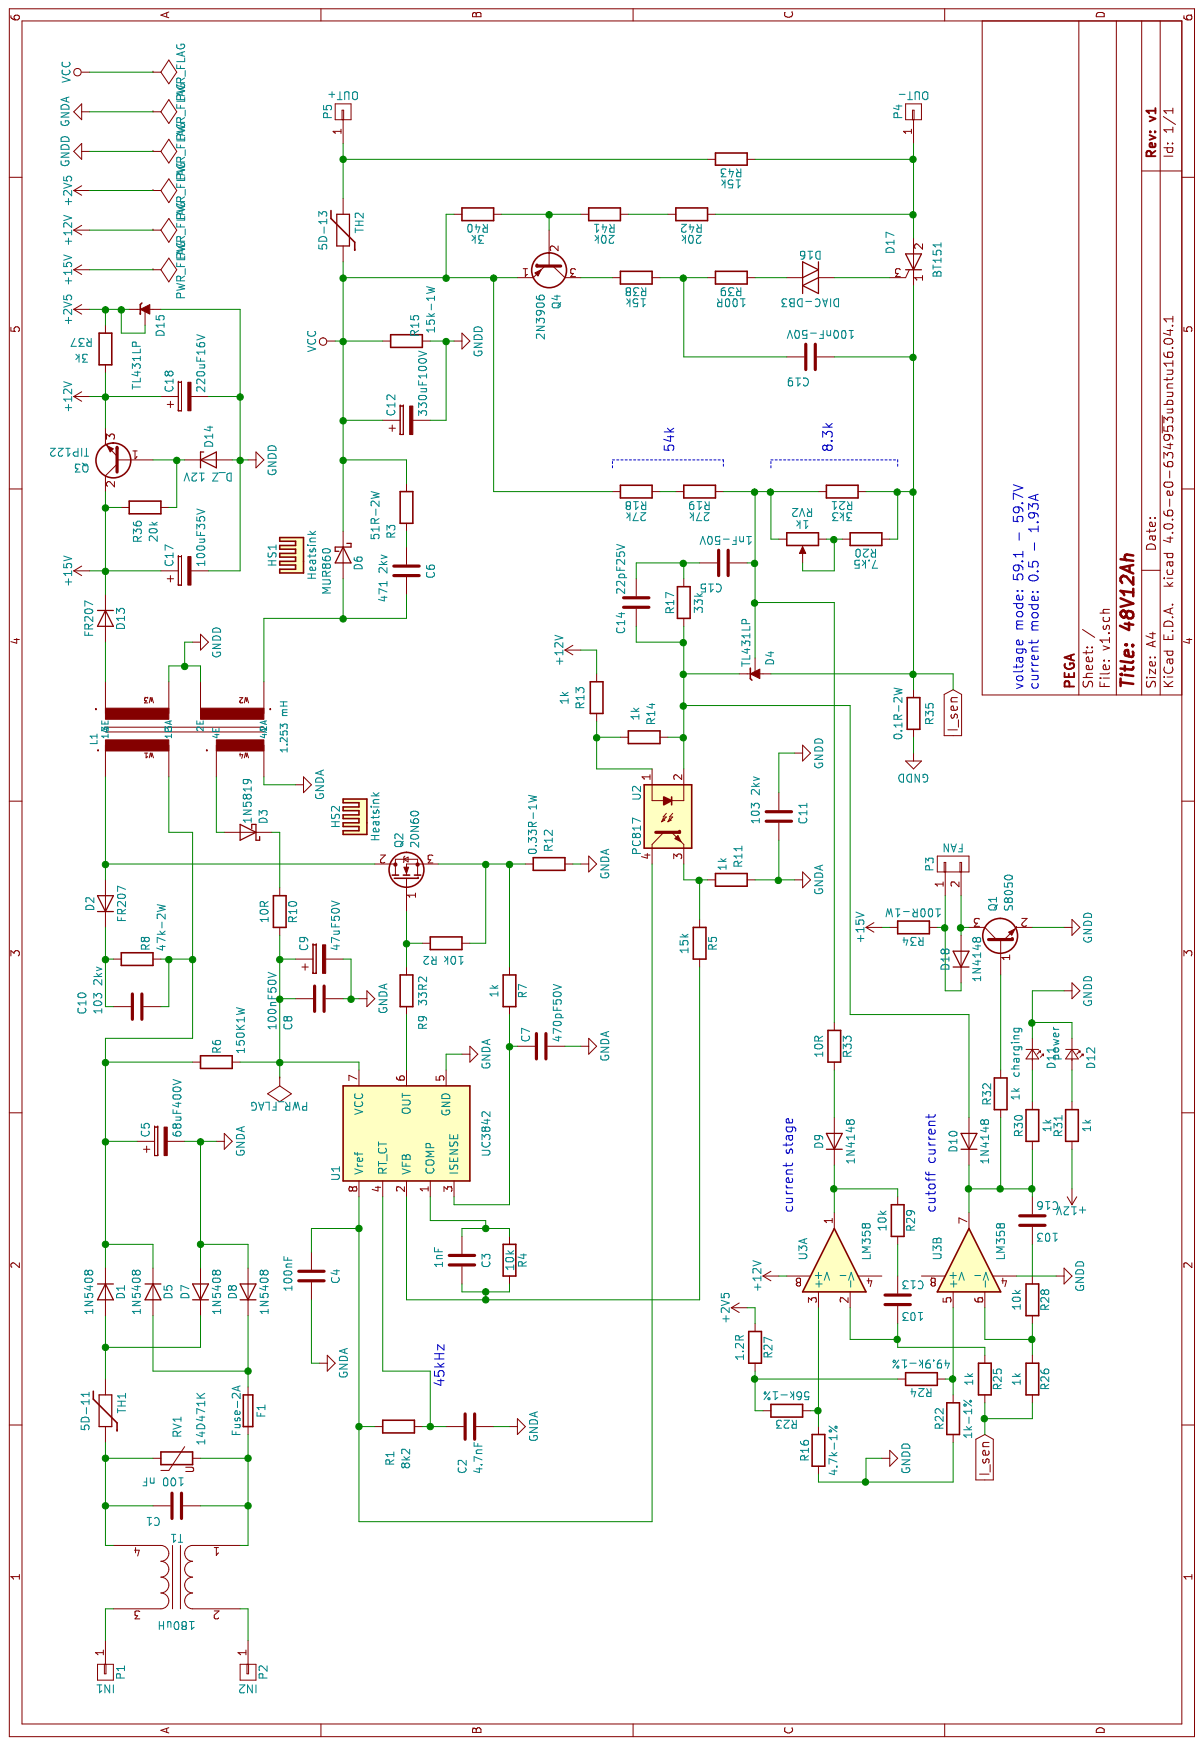
[picture p211: page 1]
