sangseu/kicad/project/load_v3/print.pdf

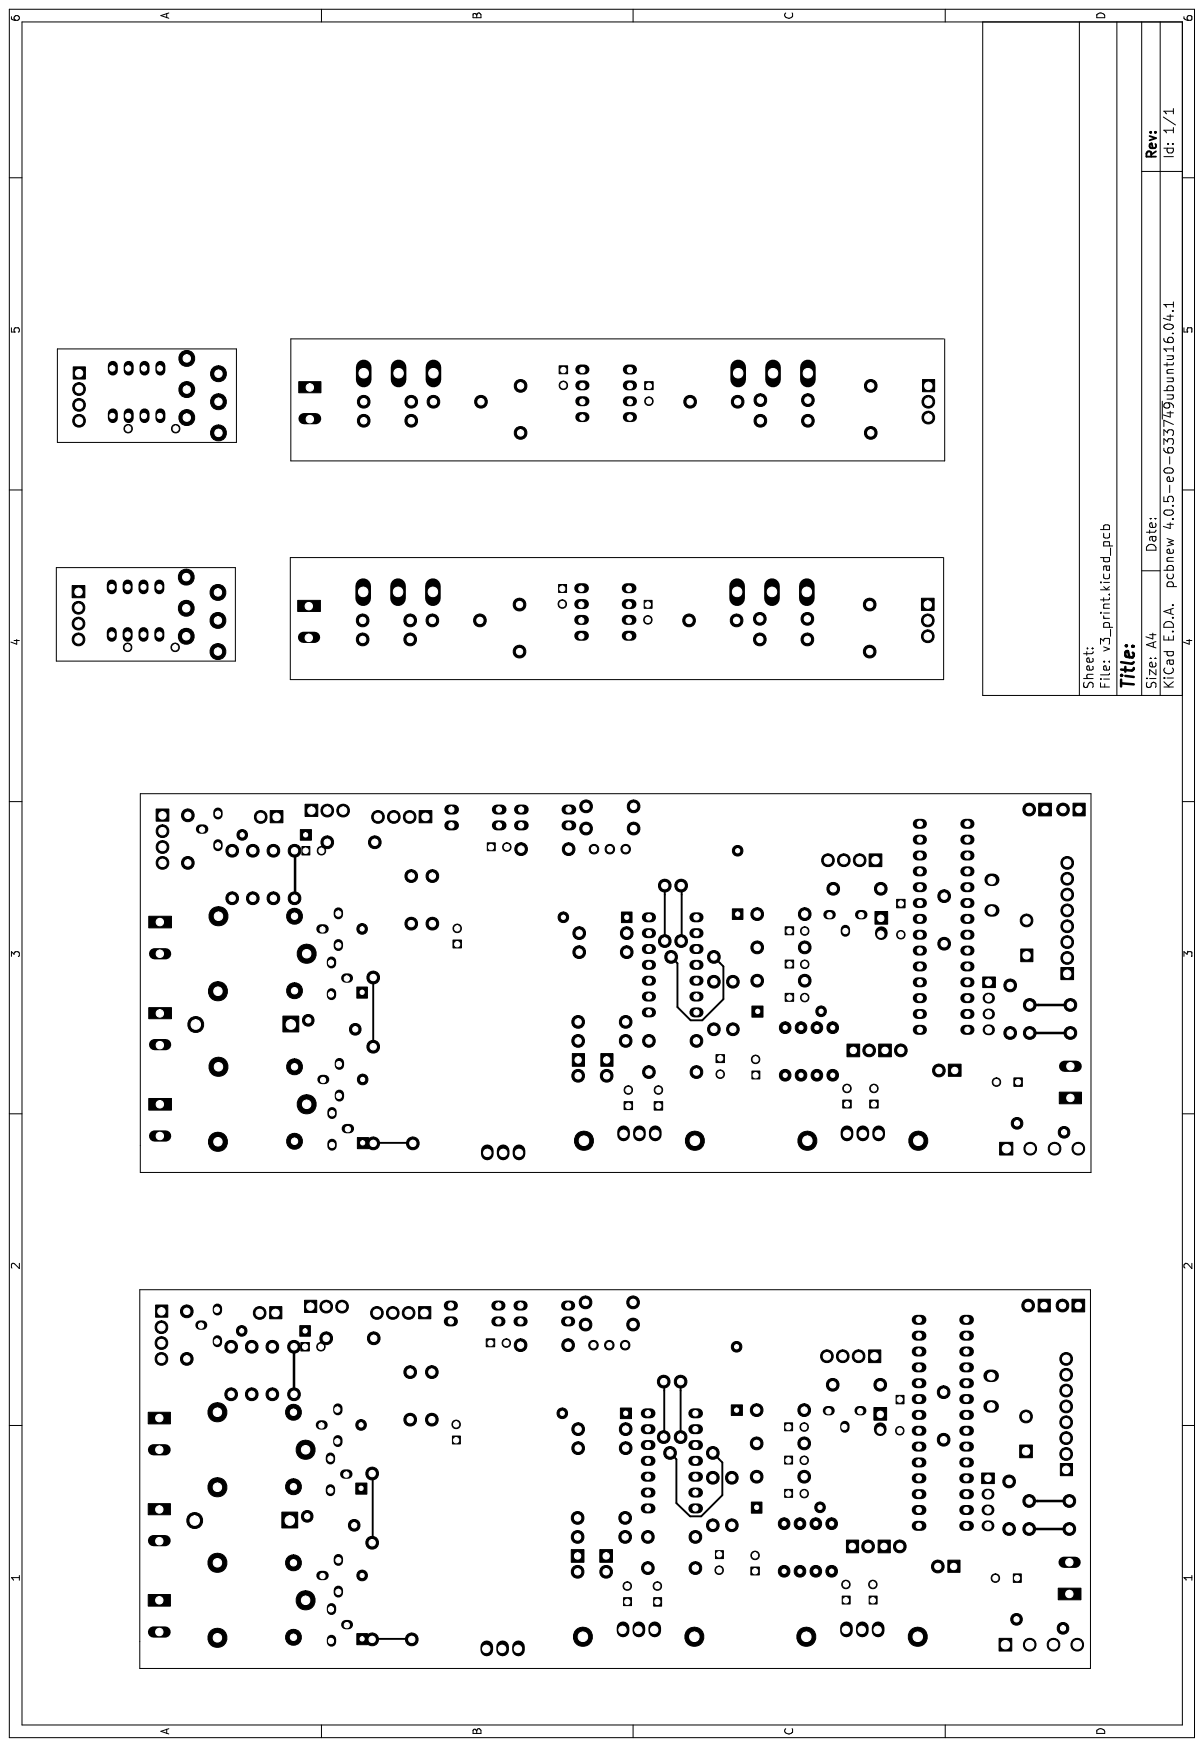
[picture p212: page 1]

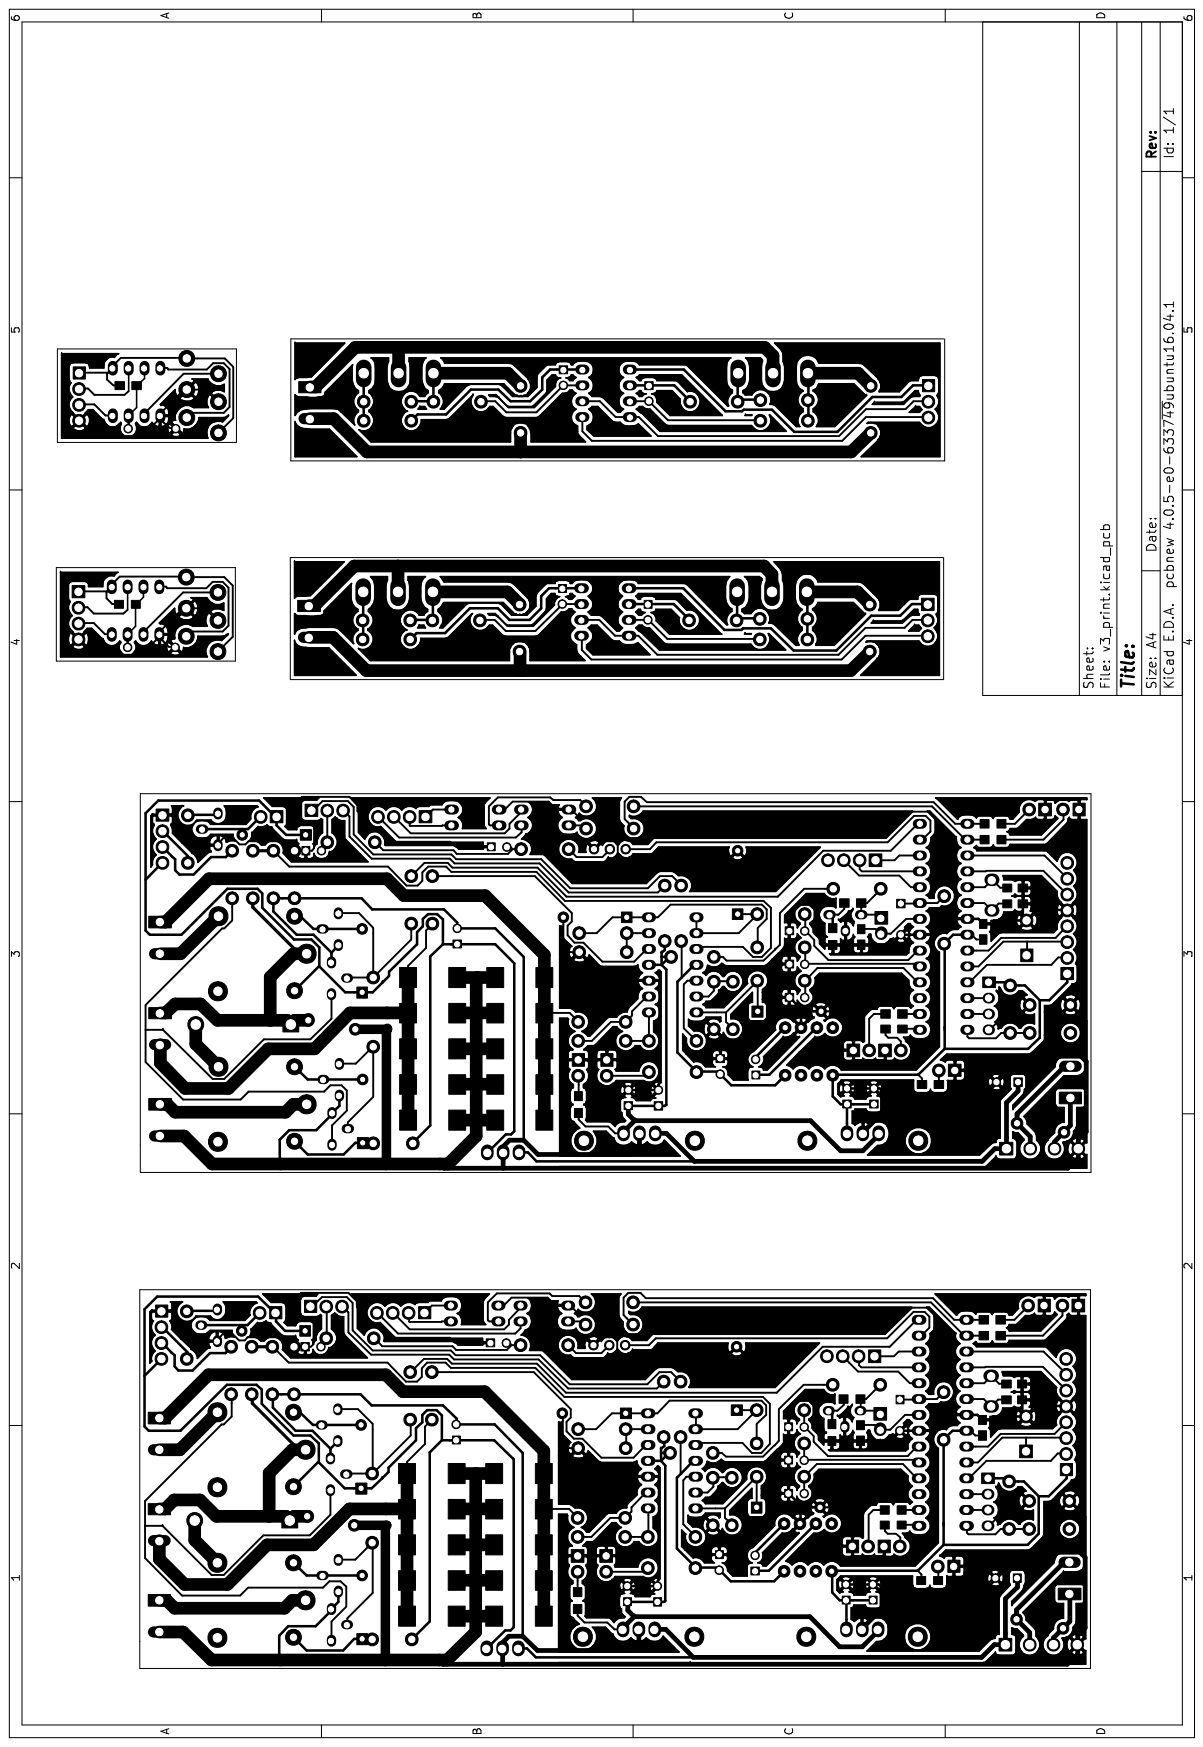
[picture p213: page 2]

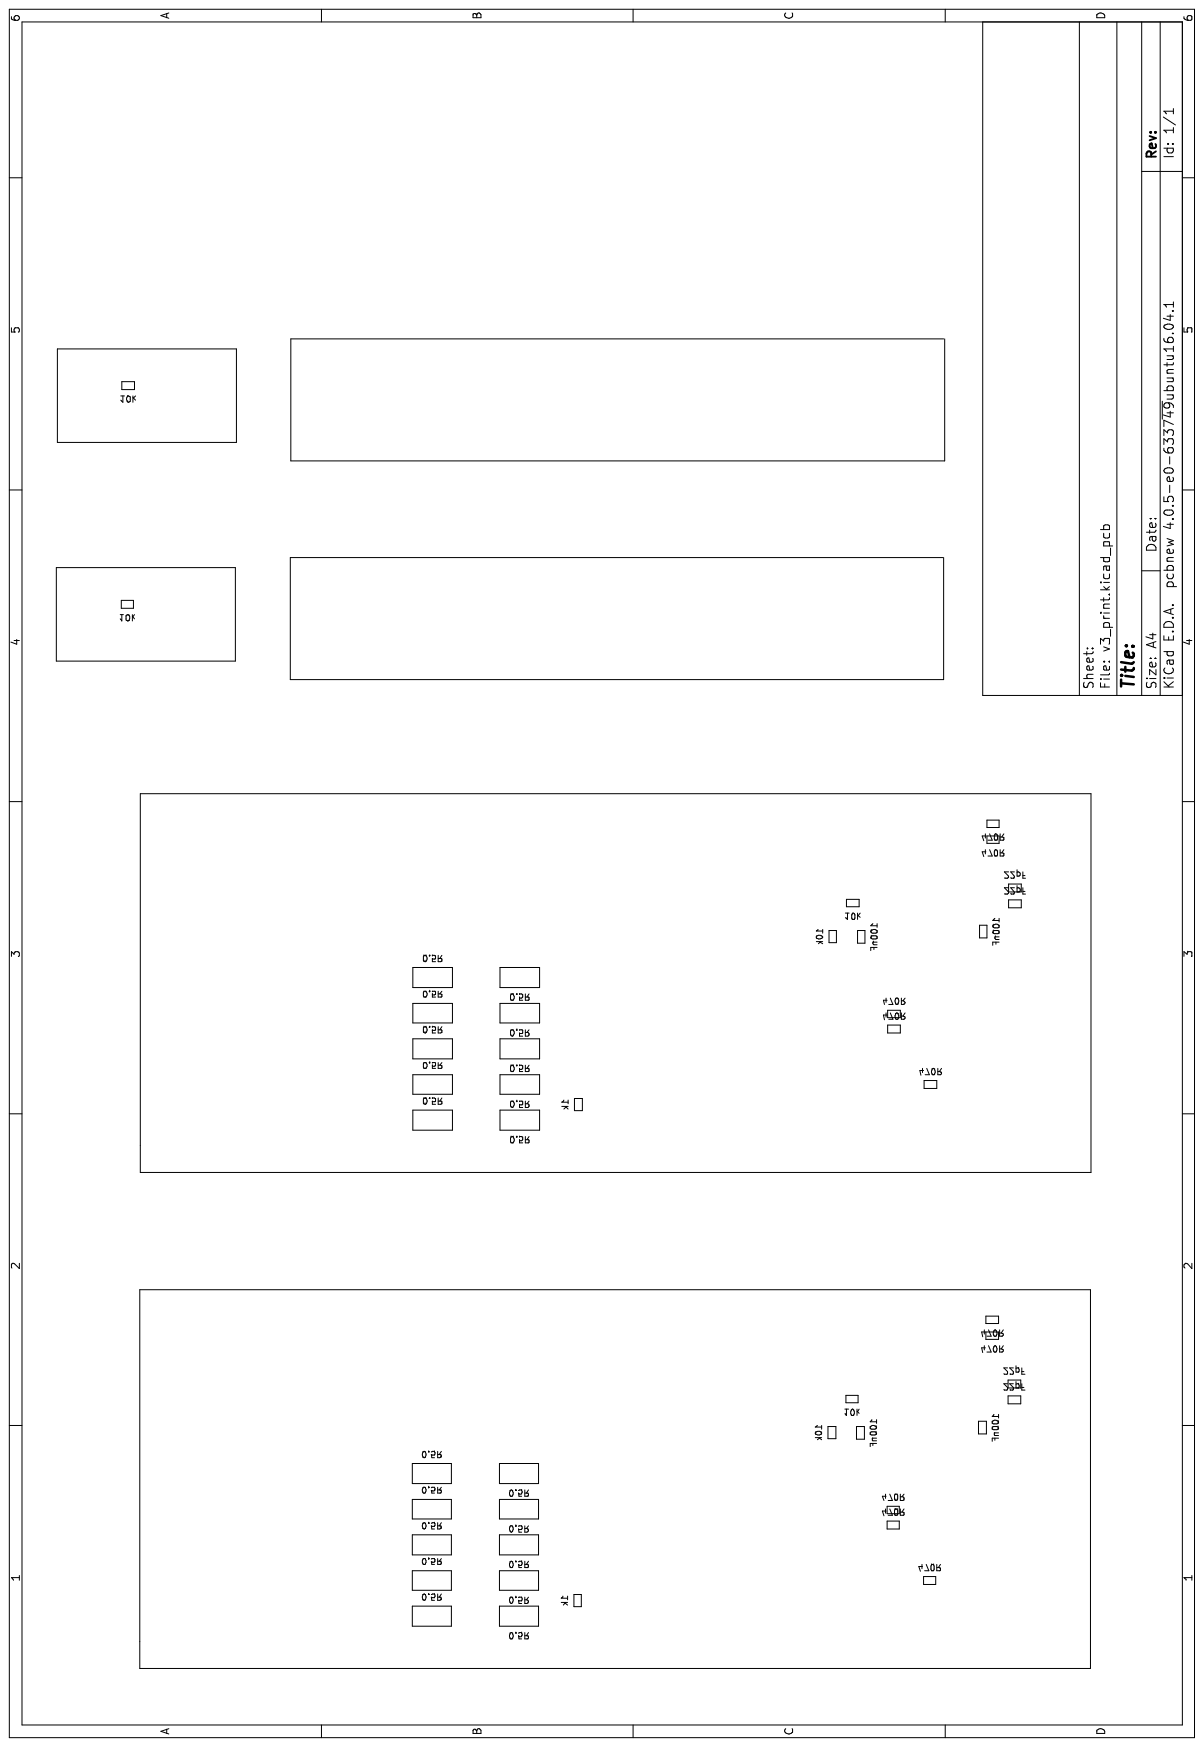
[picture p214: page 3]
