sangseu/kicad/project/chaser_led/print.pdf

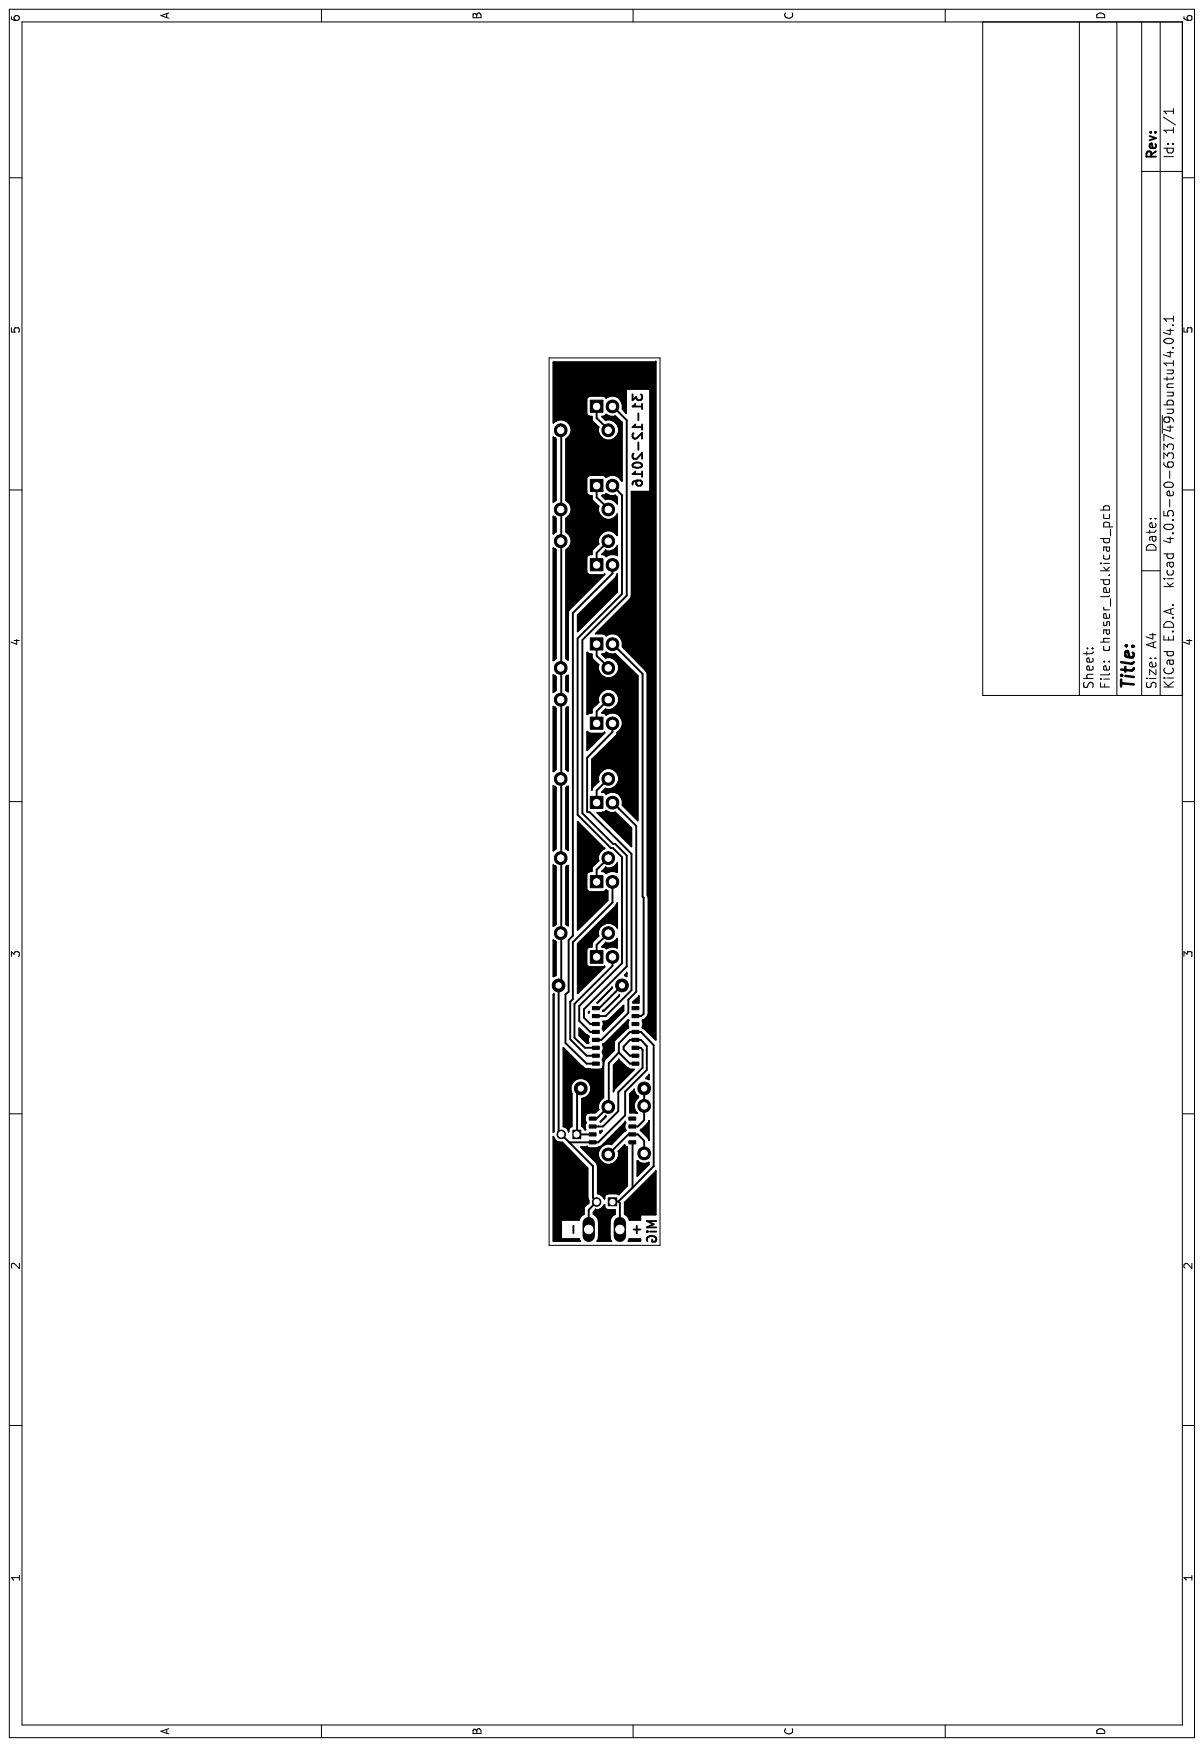
[picture p215: page 1]
