sangseu/kicad/project/48V-1A/48V1A.pdf

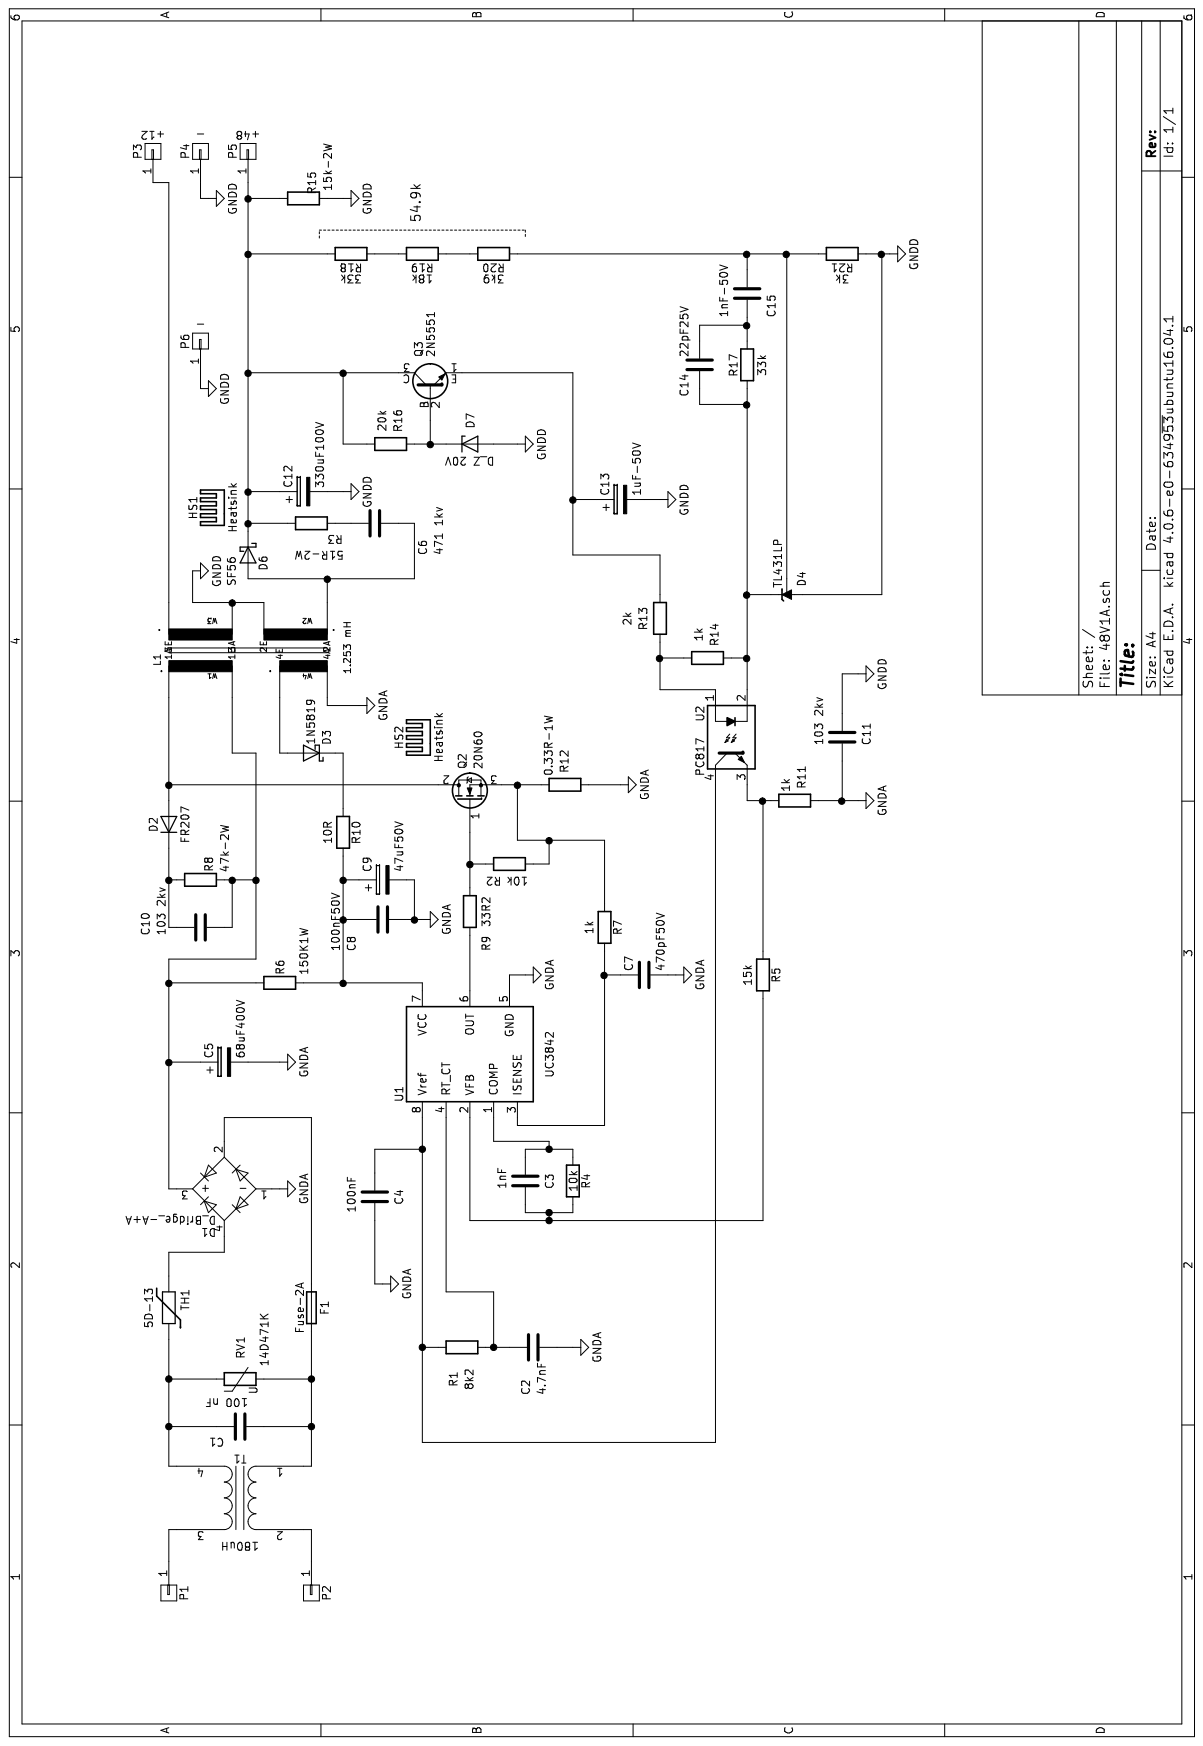
[picture p216: page 1]
