sangseu/kicad/project/48V-1A/output.pdf

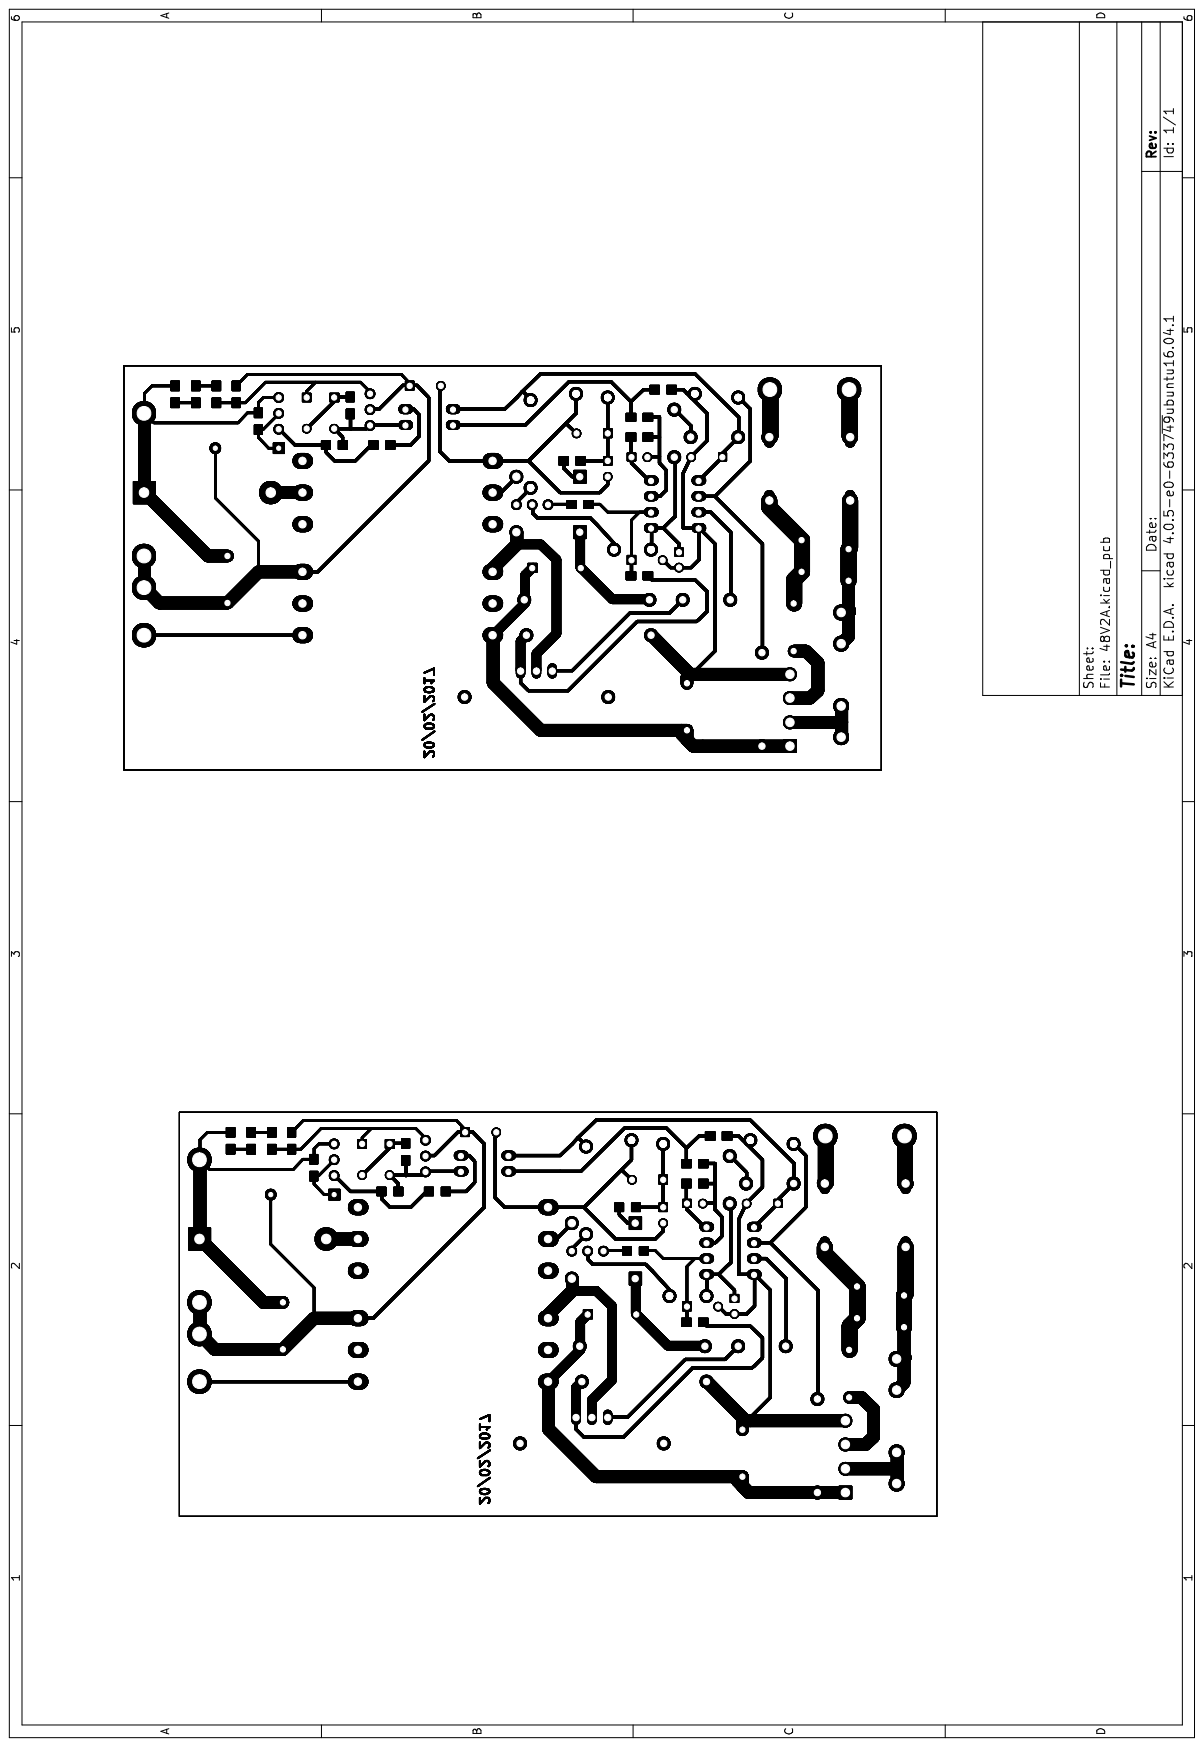
[picture p217: page 1]

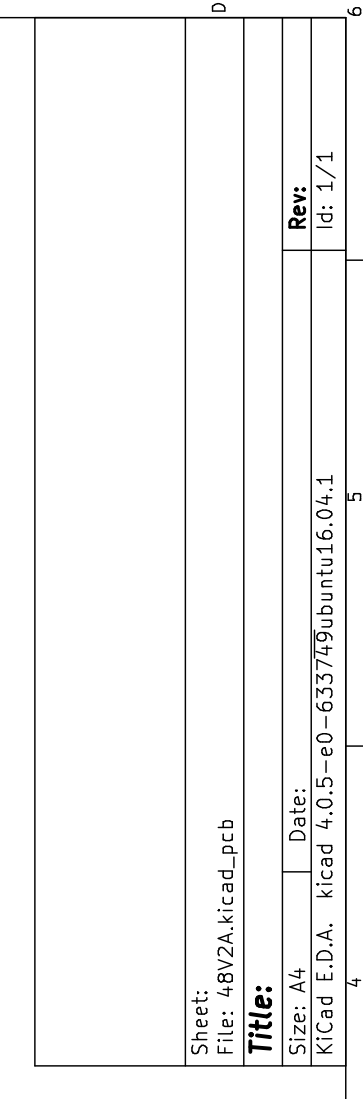
[picture p218: page 2]

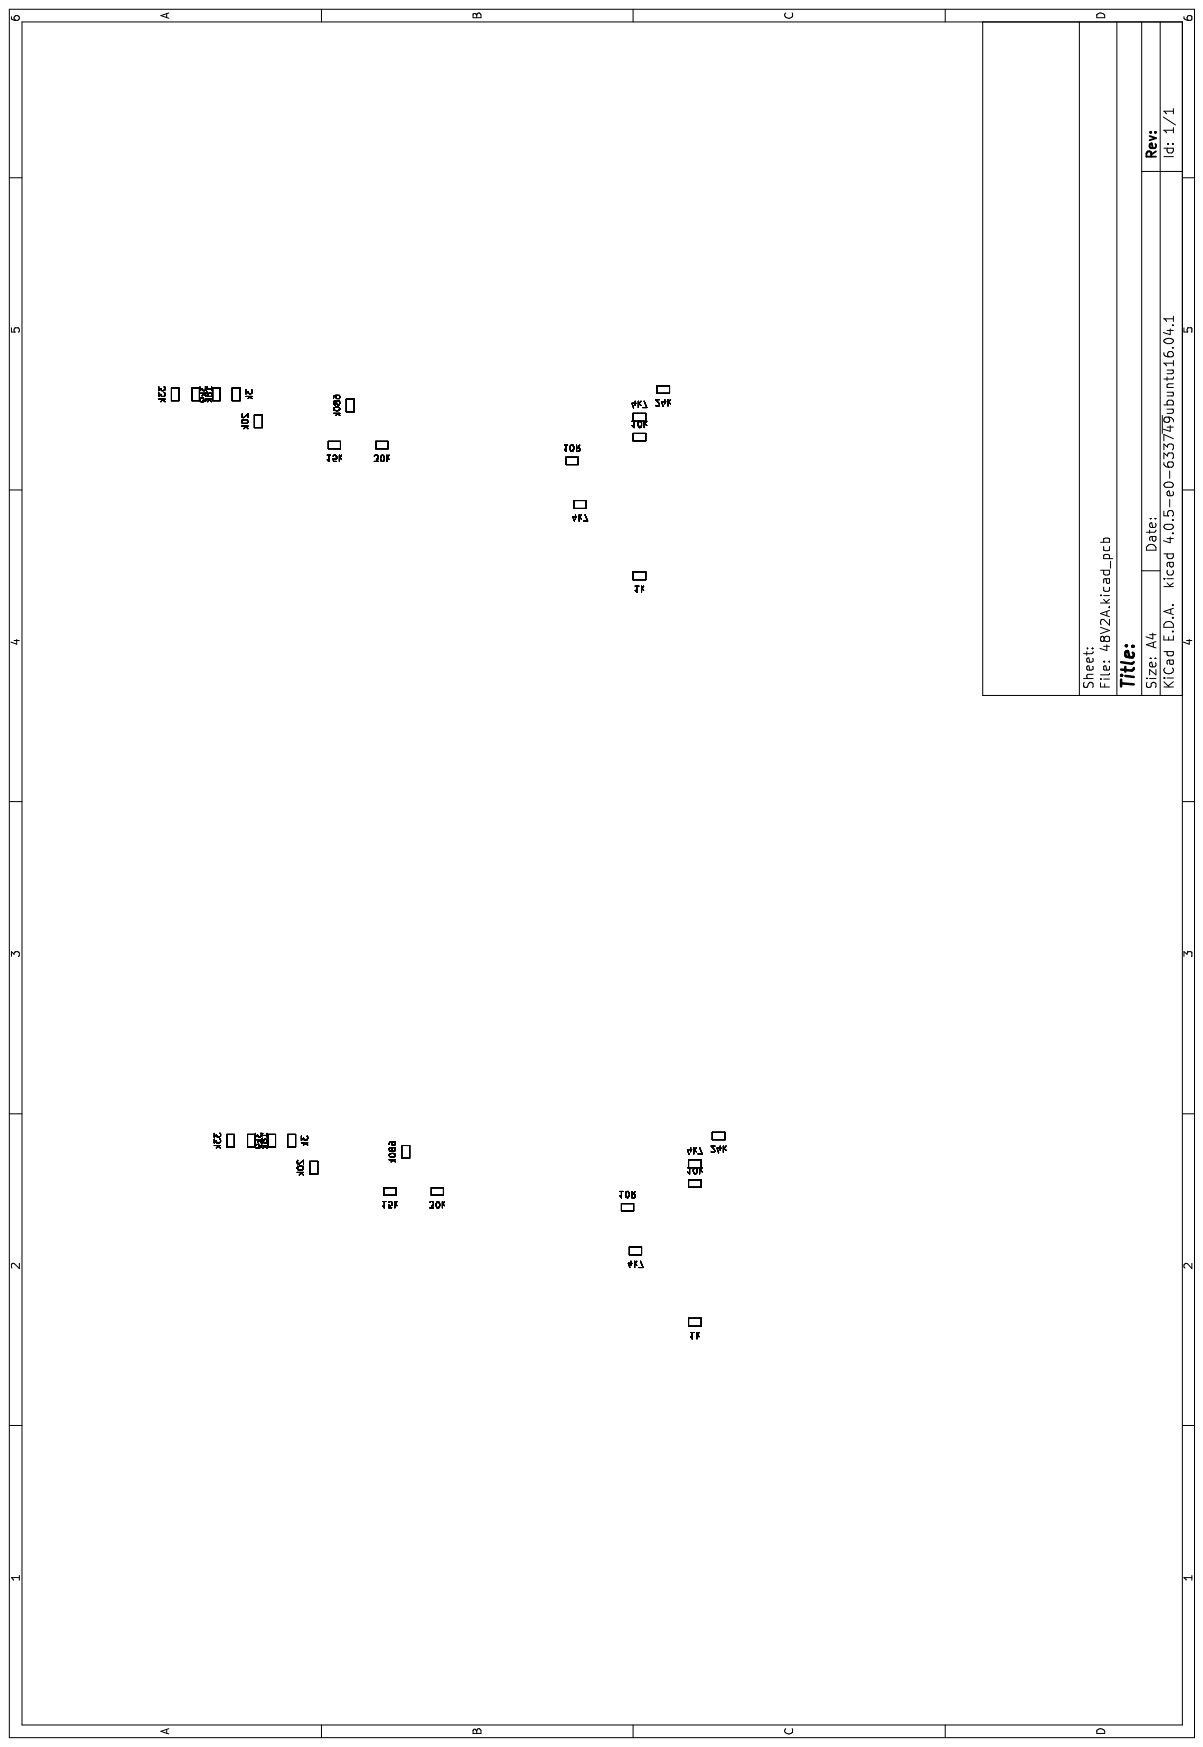
[picture p219: page 3]
