sangseu/kicad/project/charger v2/pcb.pdf

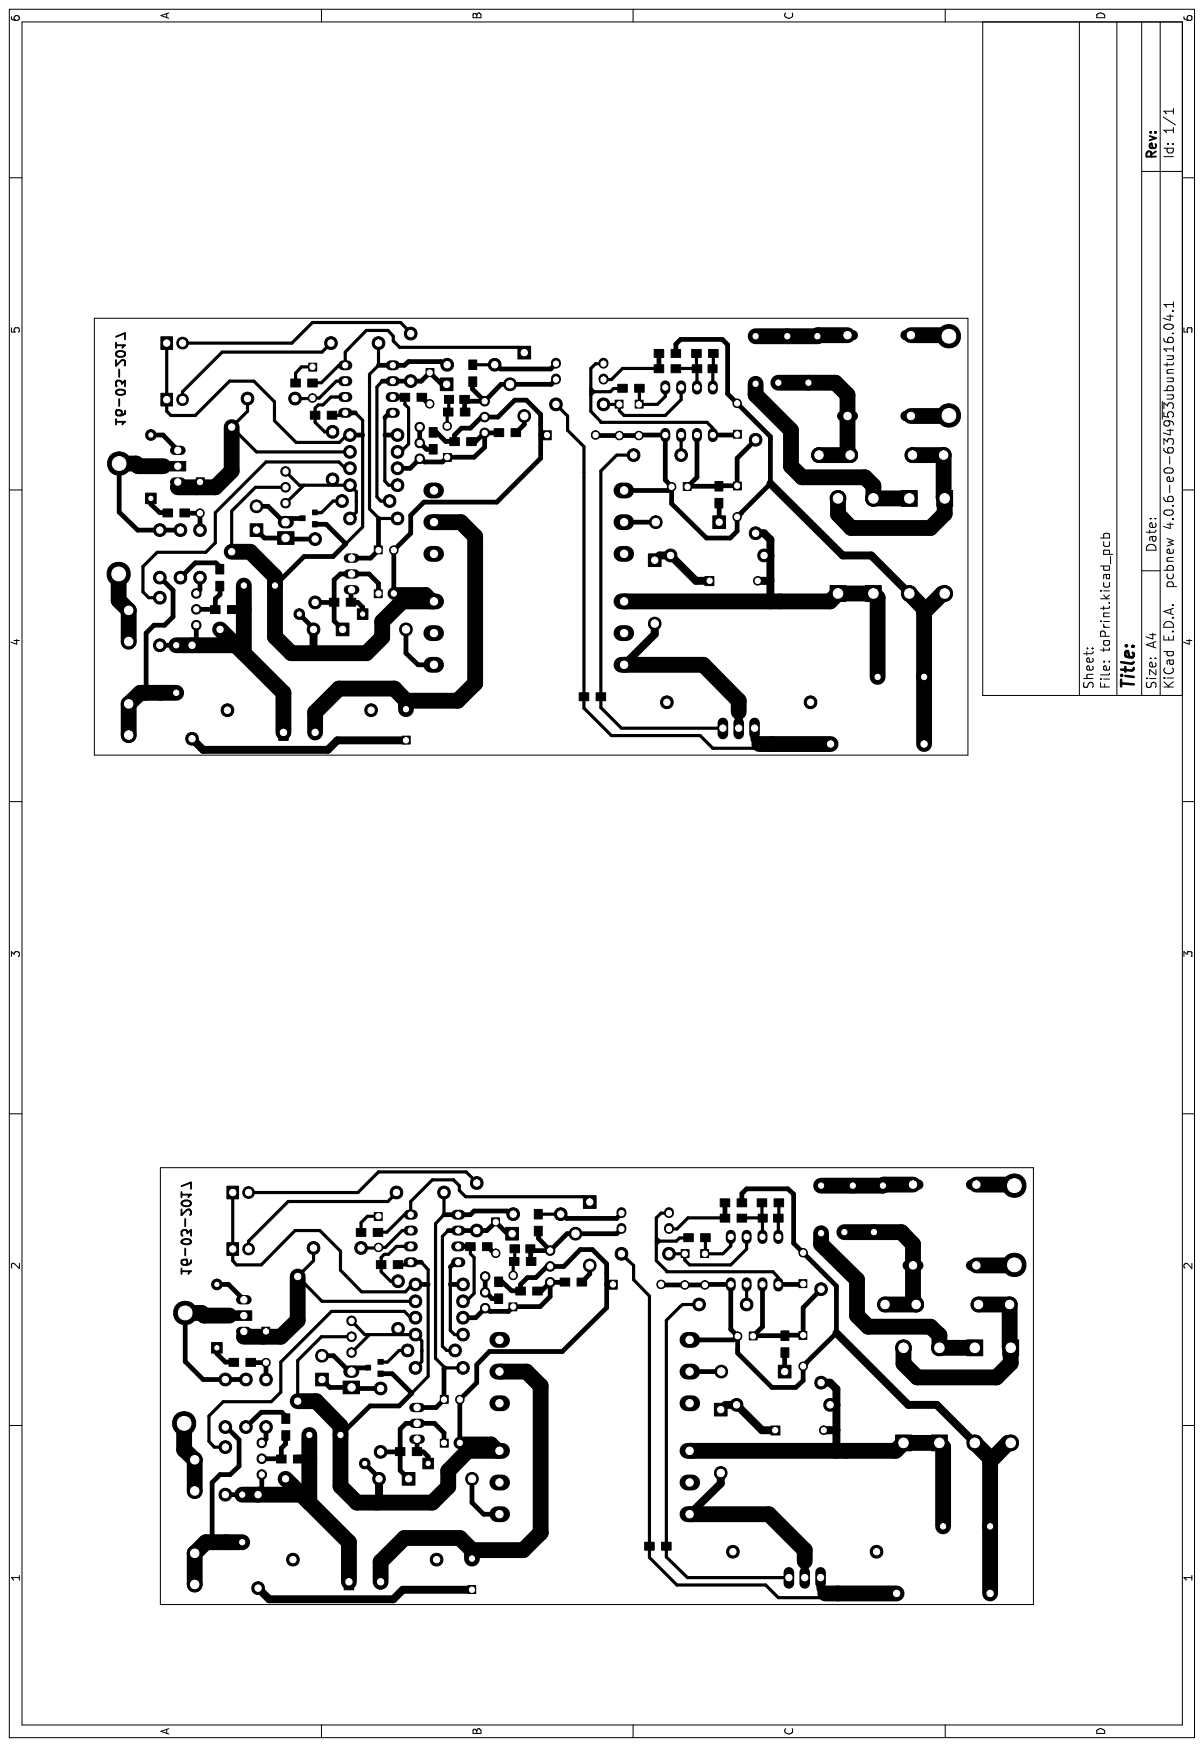
[picture p220: page 1]

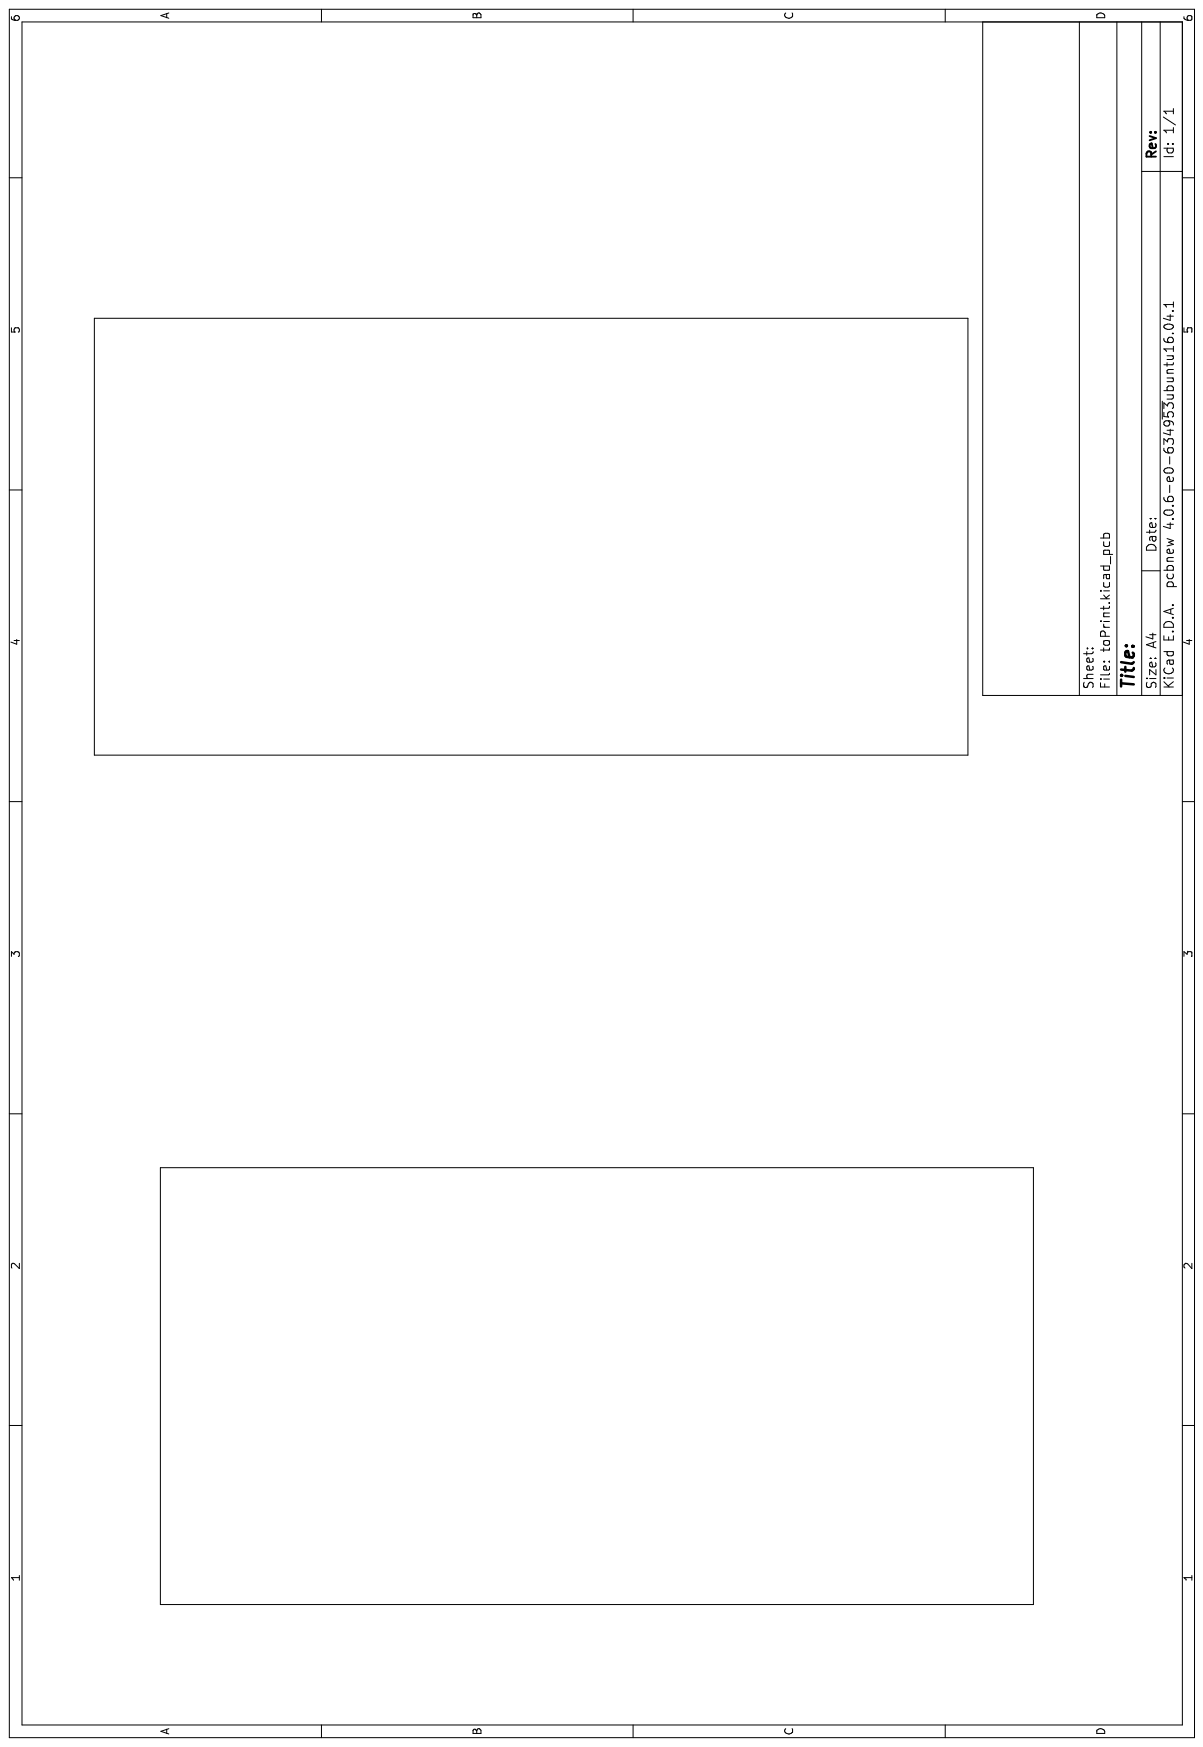
[picture p221: page 2]

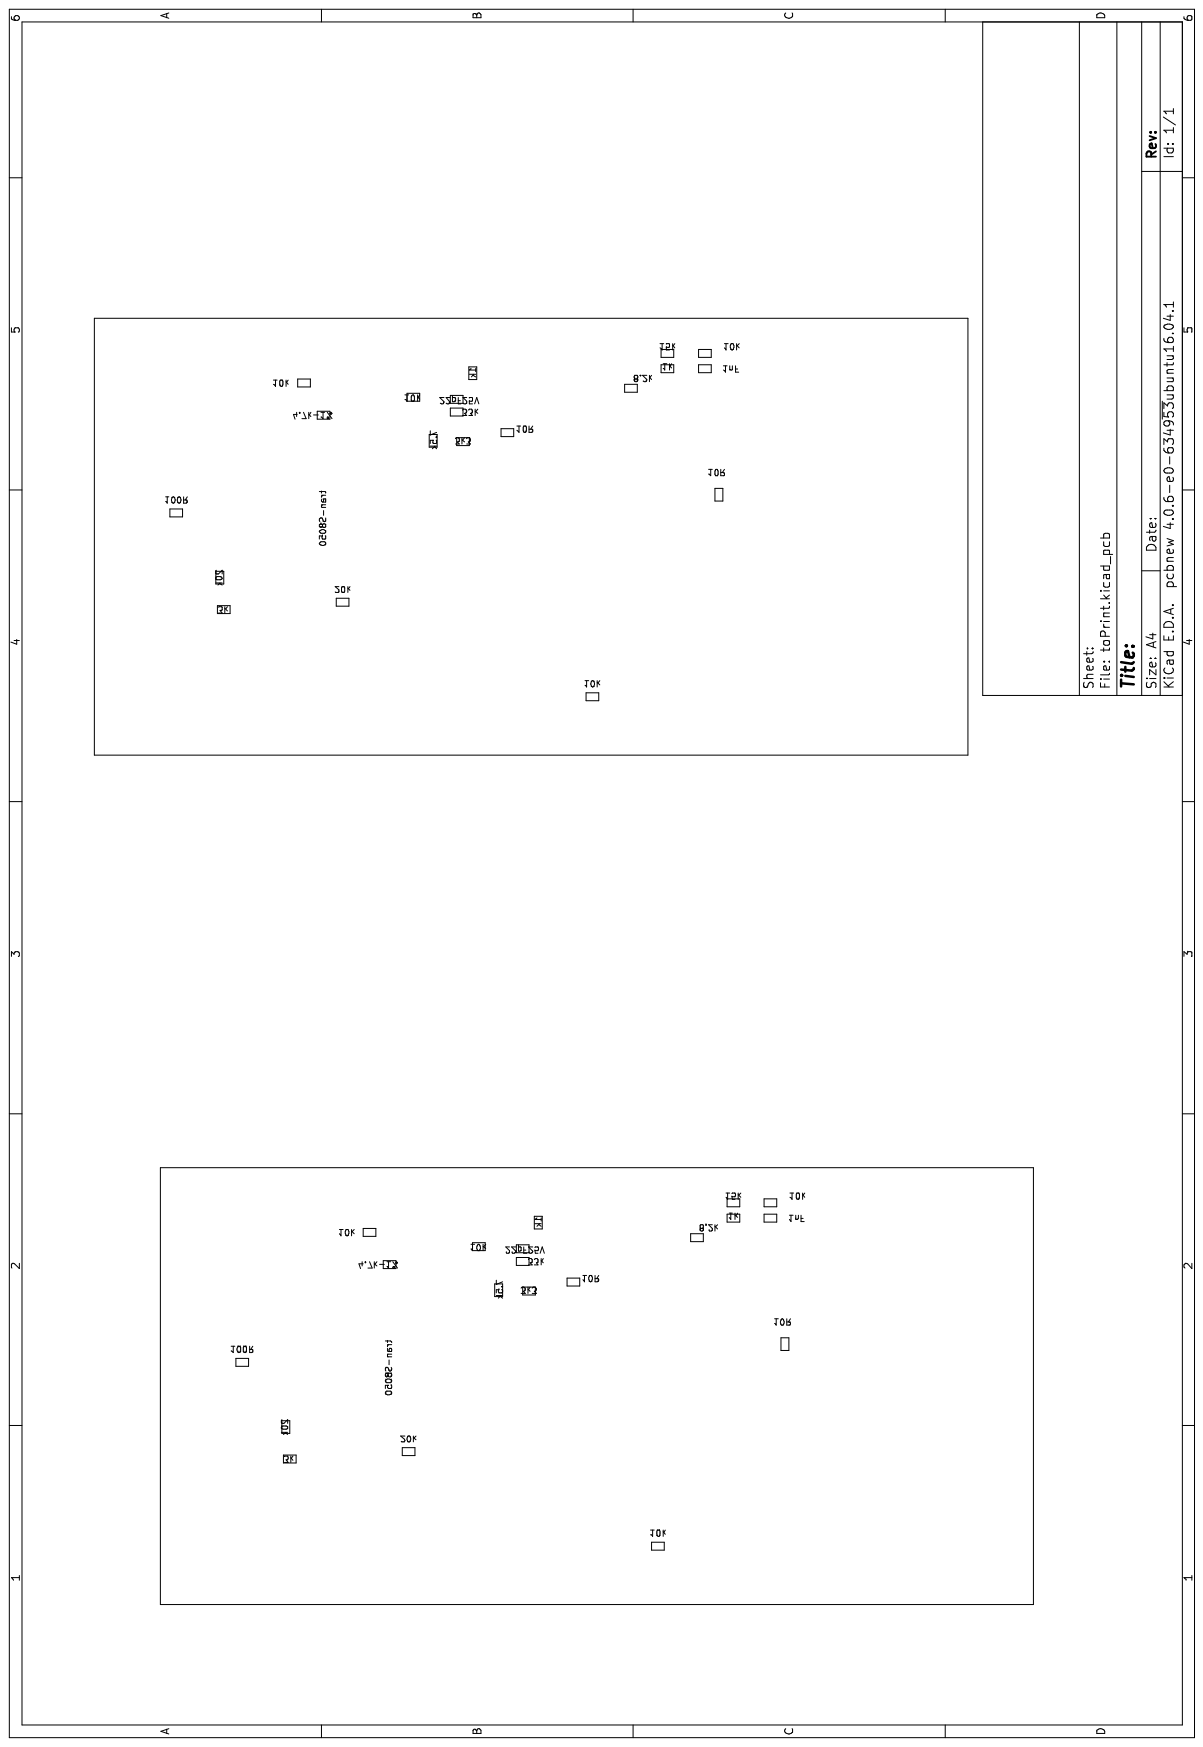
[picture p222: page 3]
