sangseu/kicad/project/load_v3/pcb.pdf

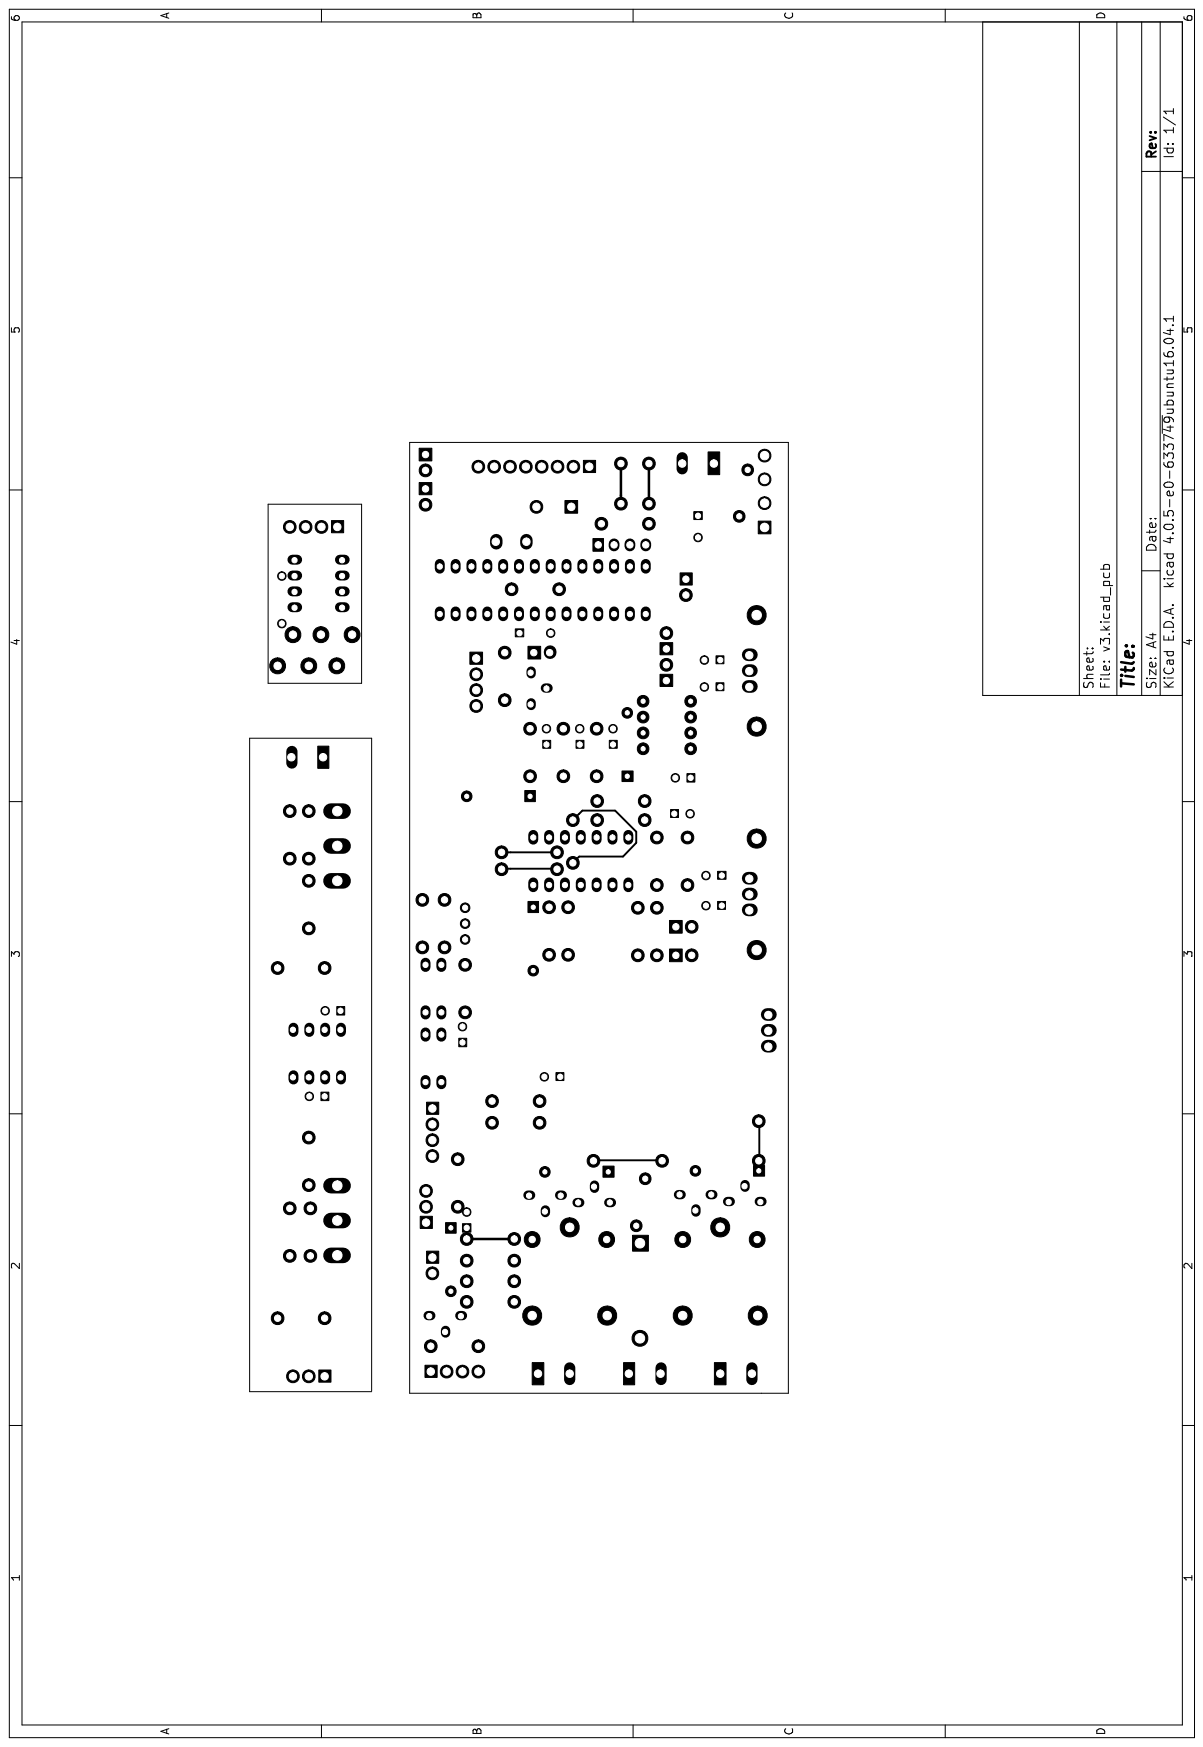
[picture p223: page 1]

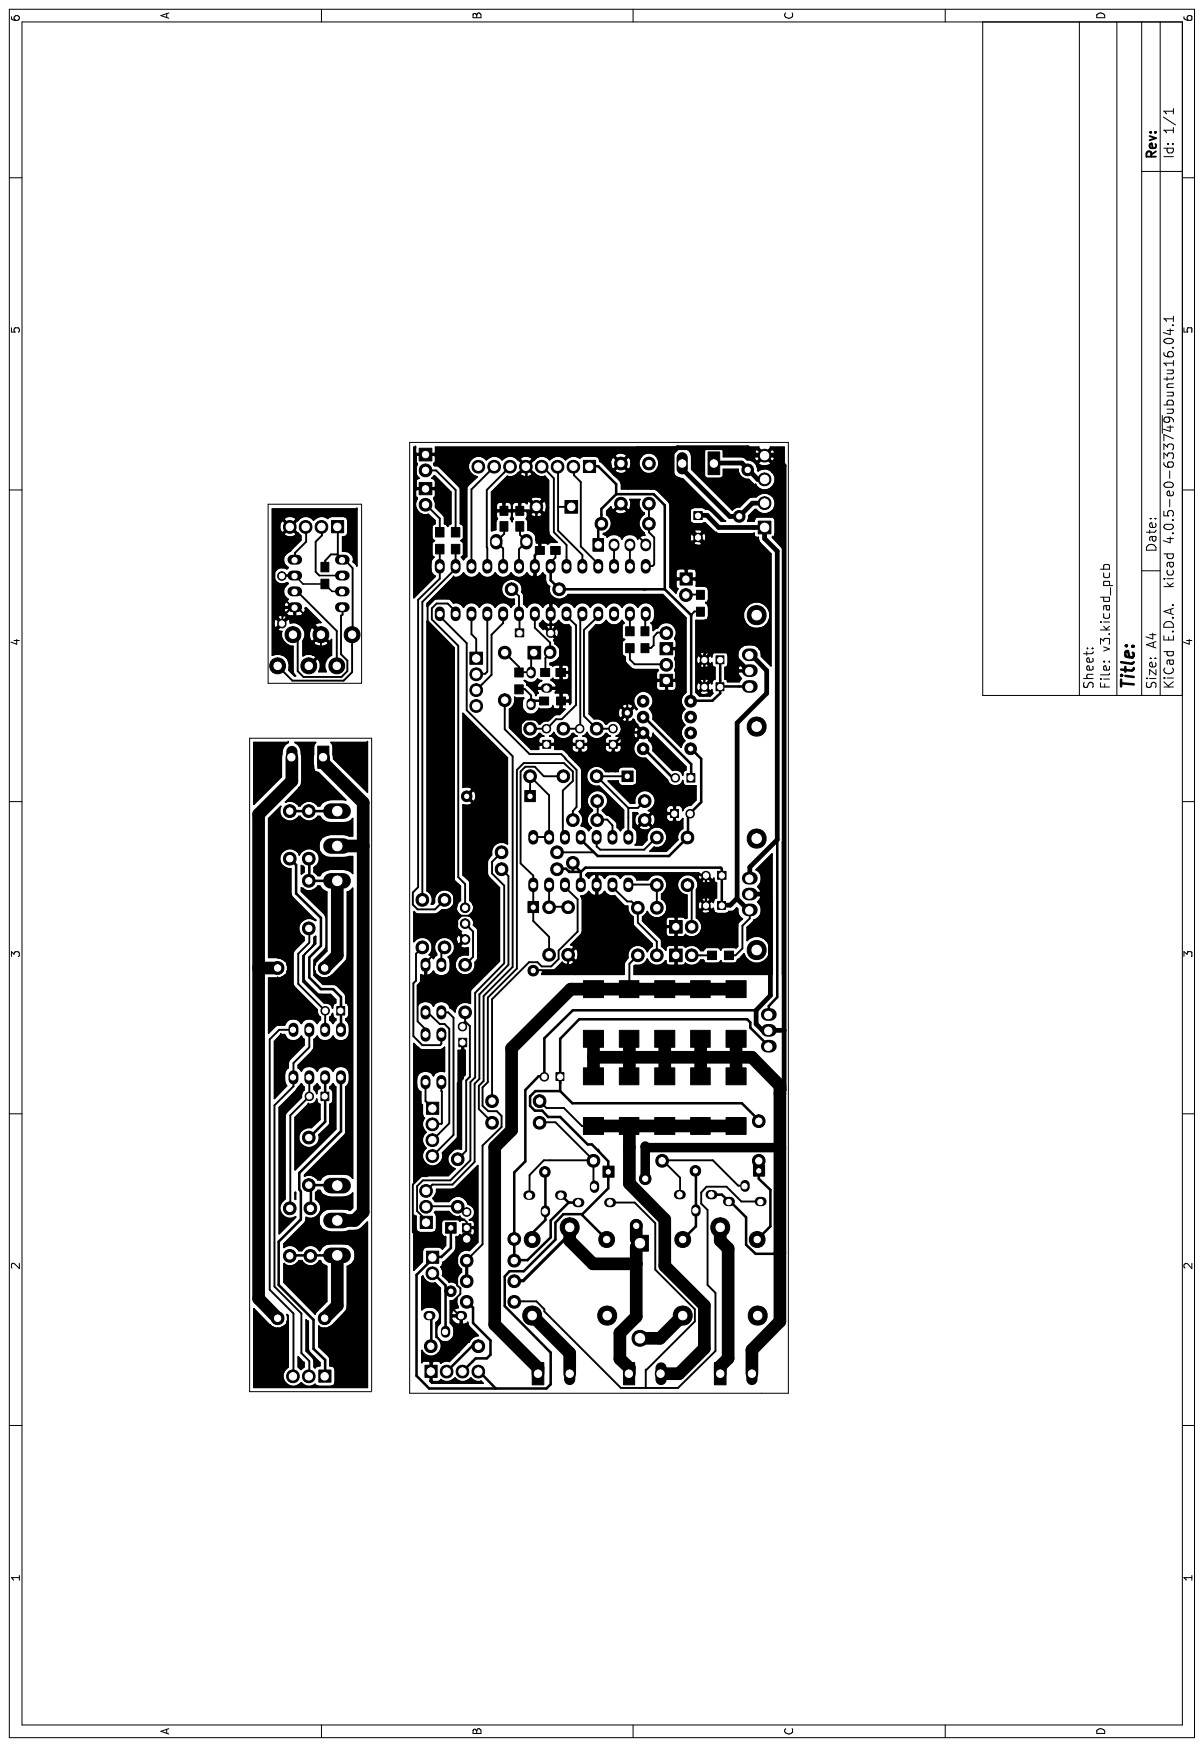
[picture p224: page 2]

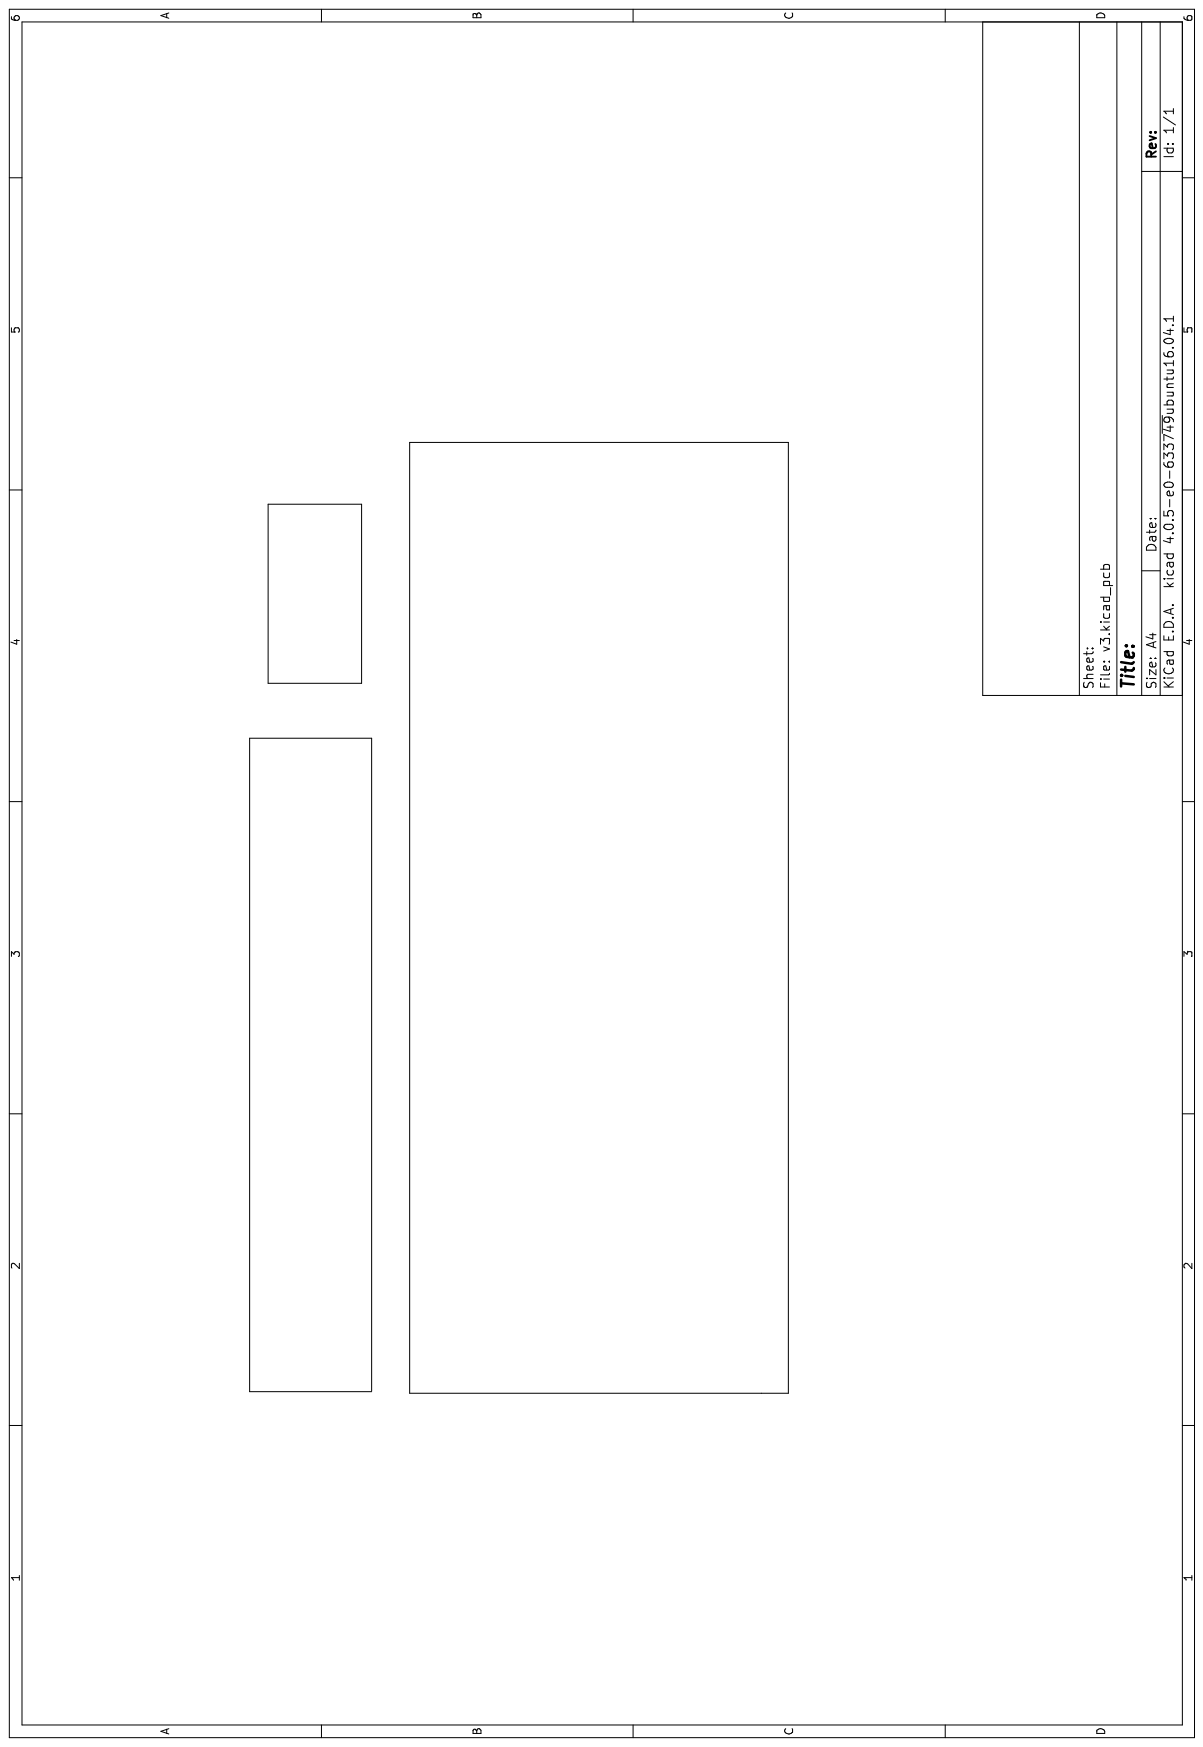
[picture p225: page 3]

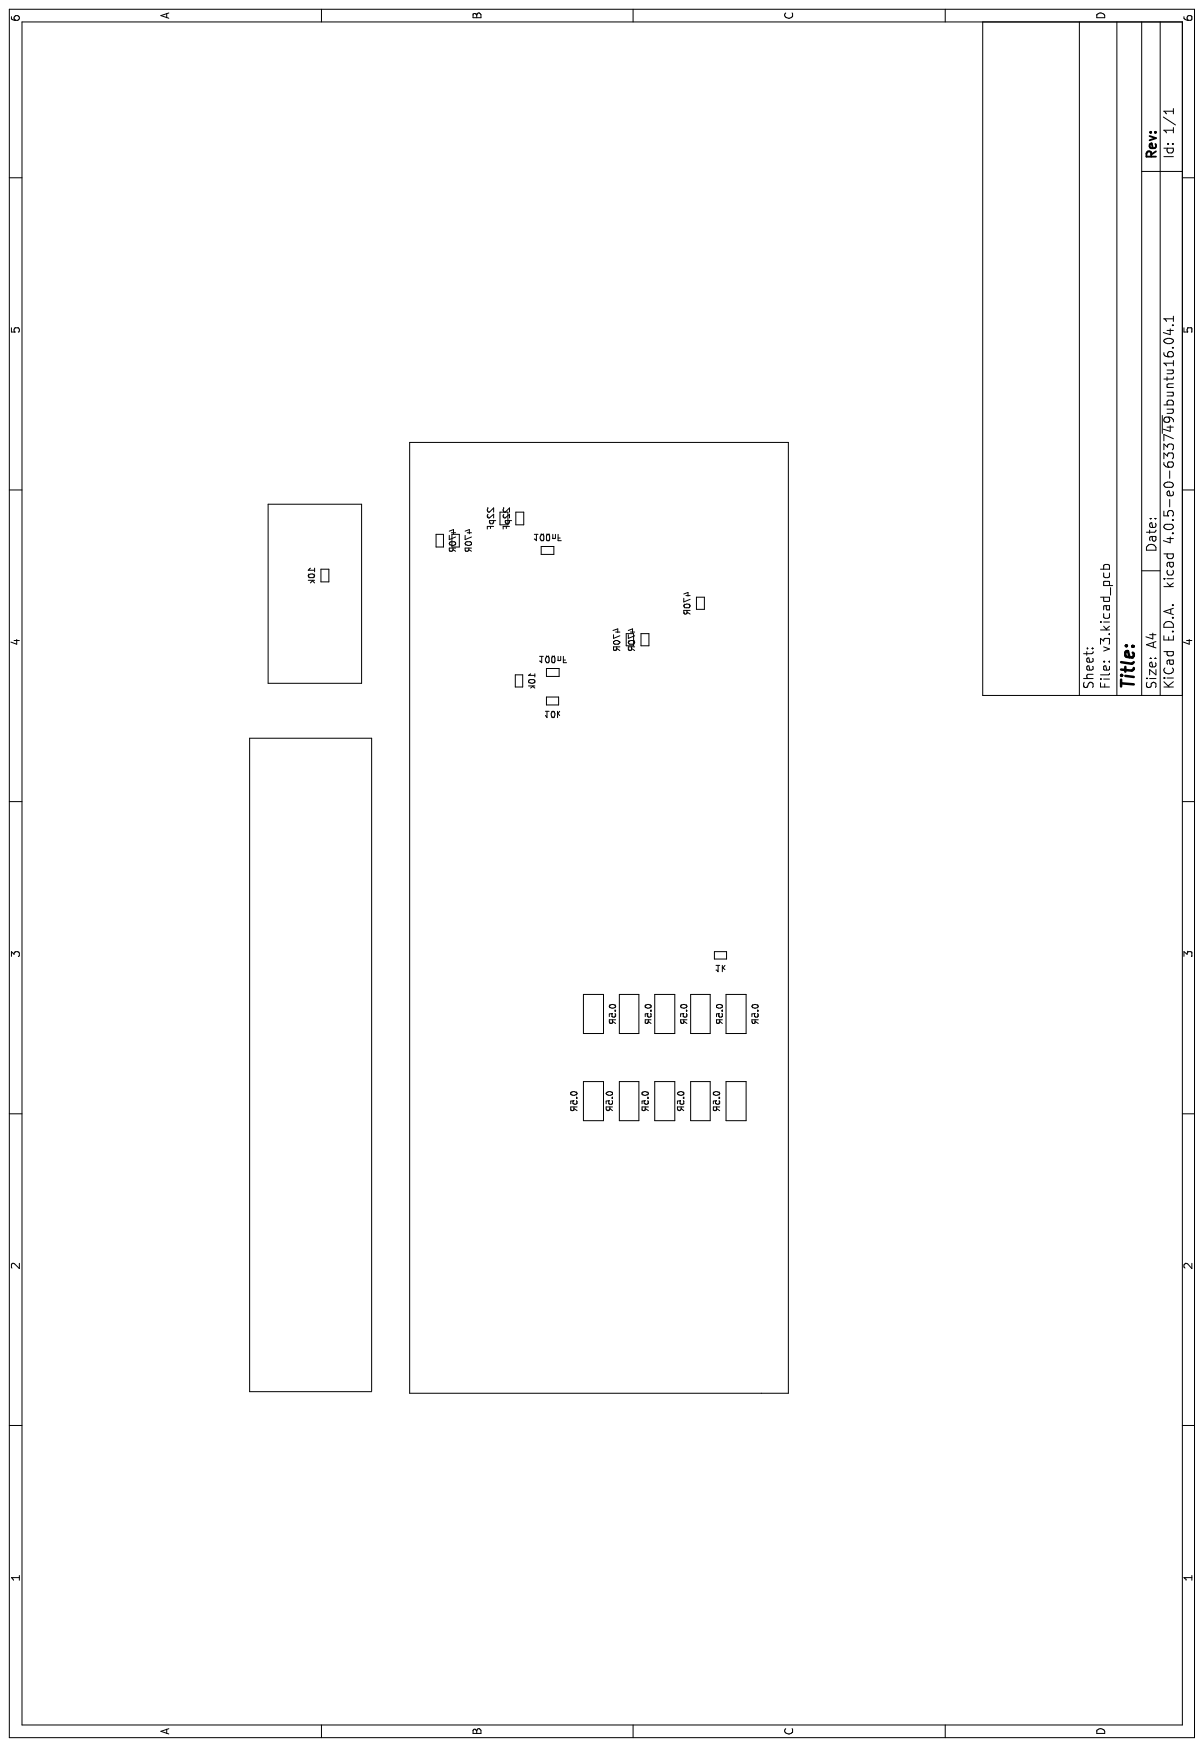
[picture p226: page 4]
