sangseu/kicad/project/load_v3/schema_color.pdf

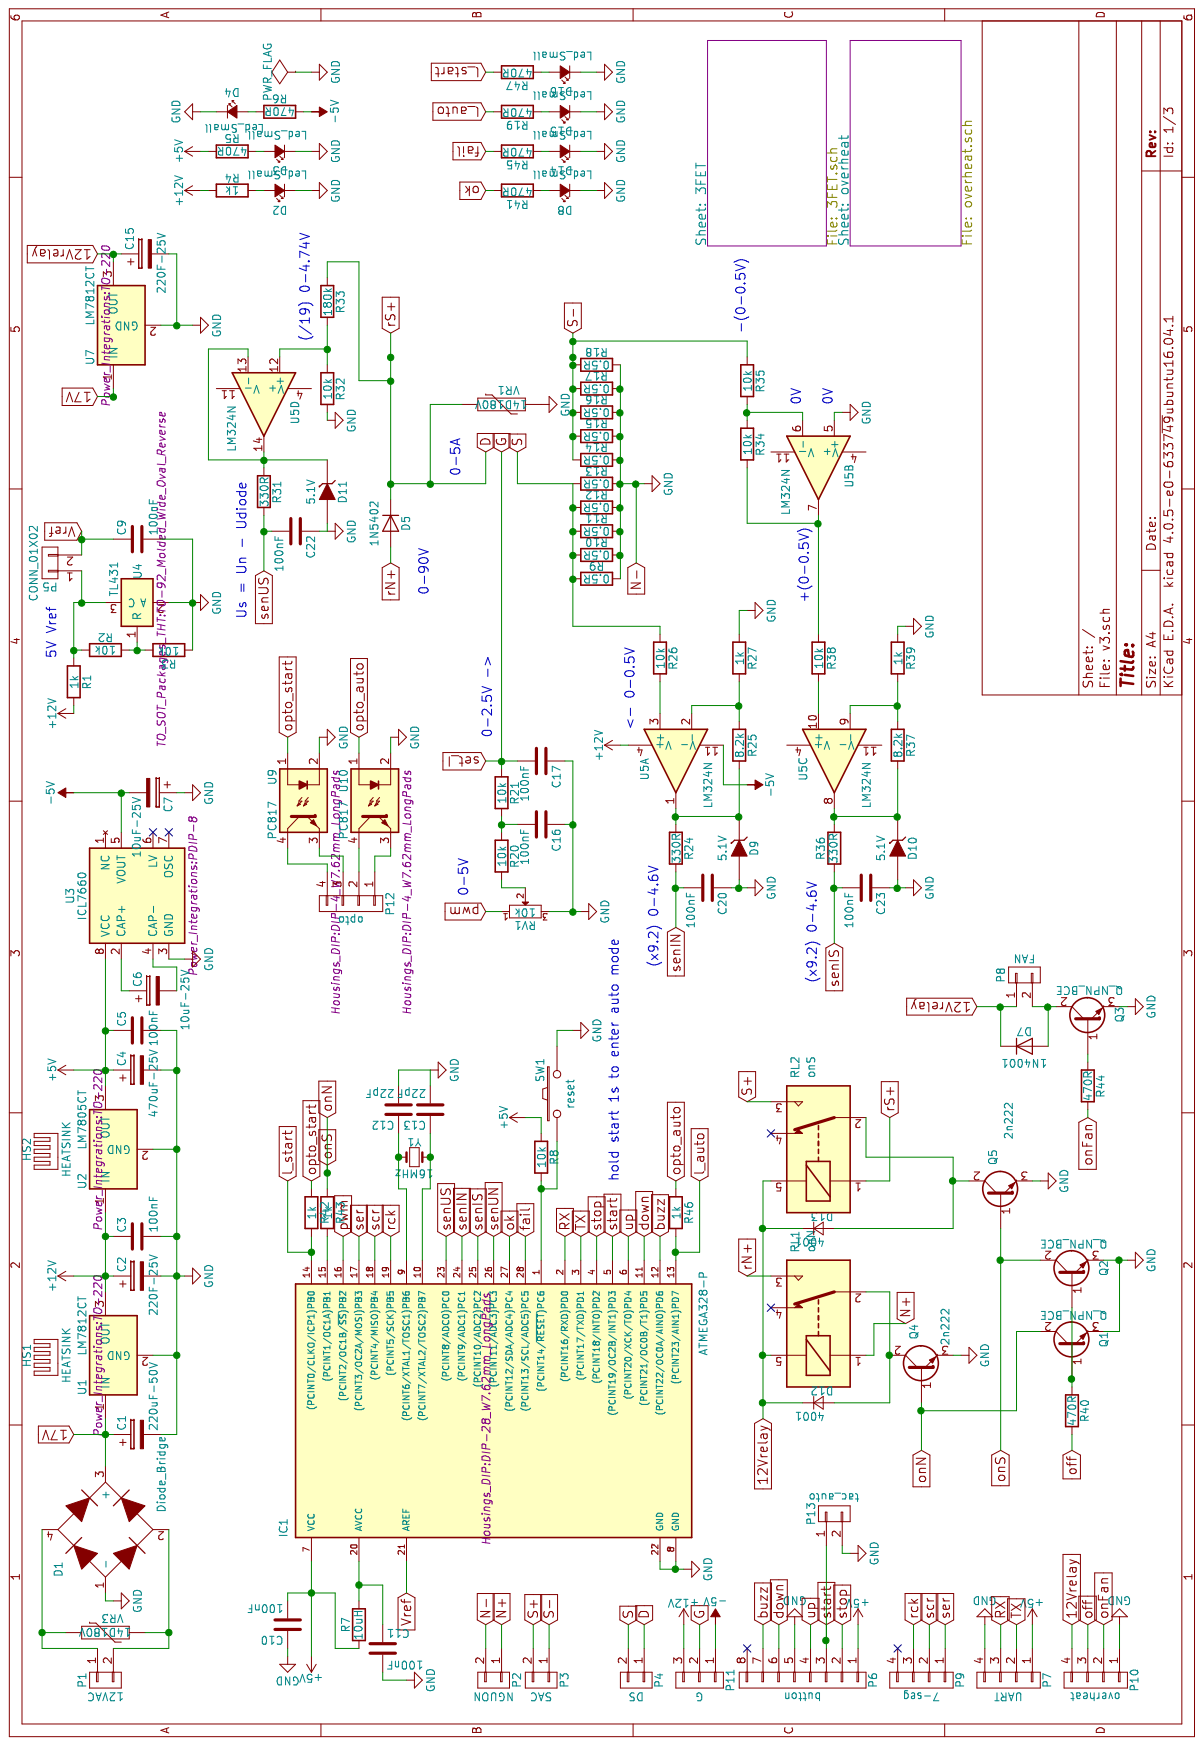
[picture p227: page 1]

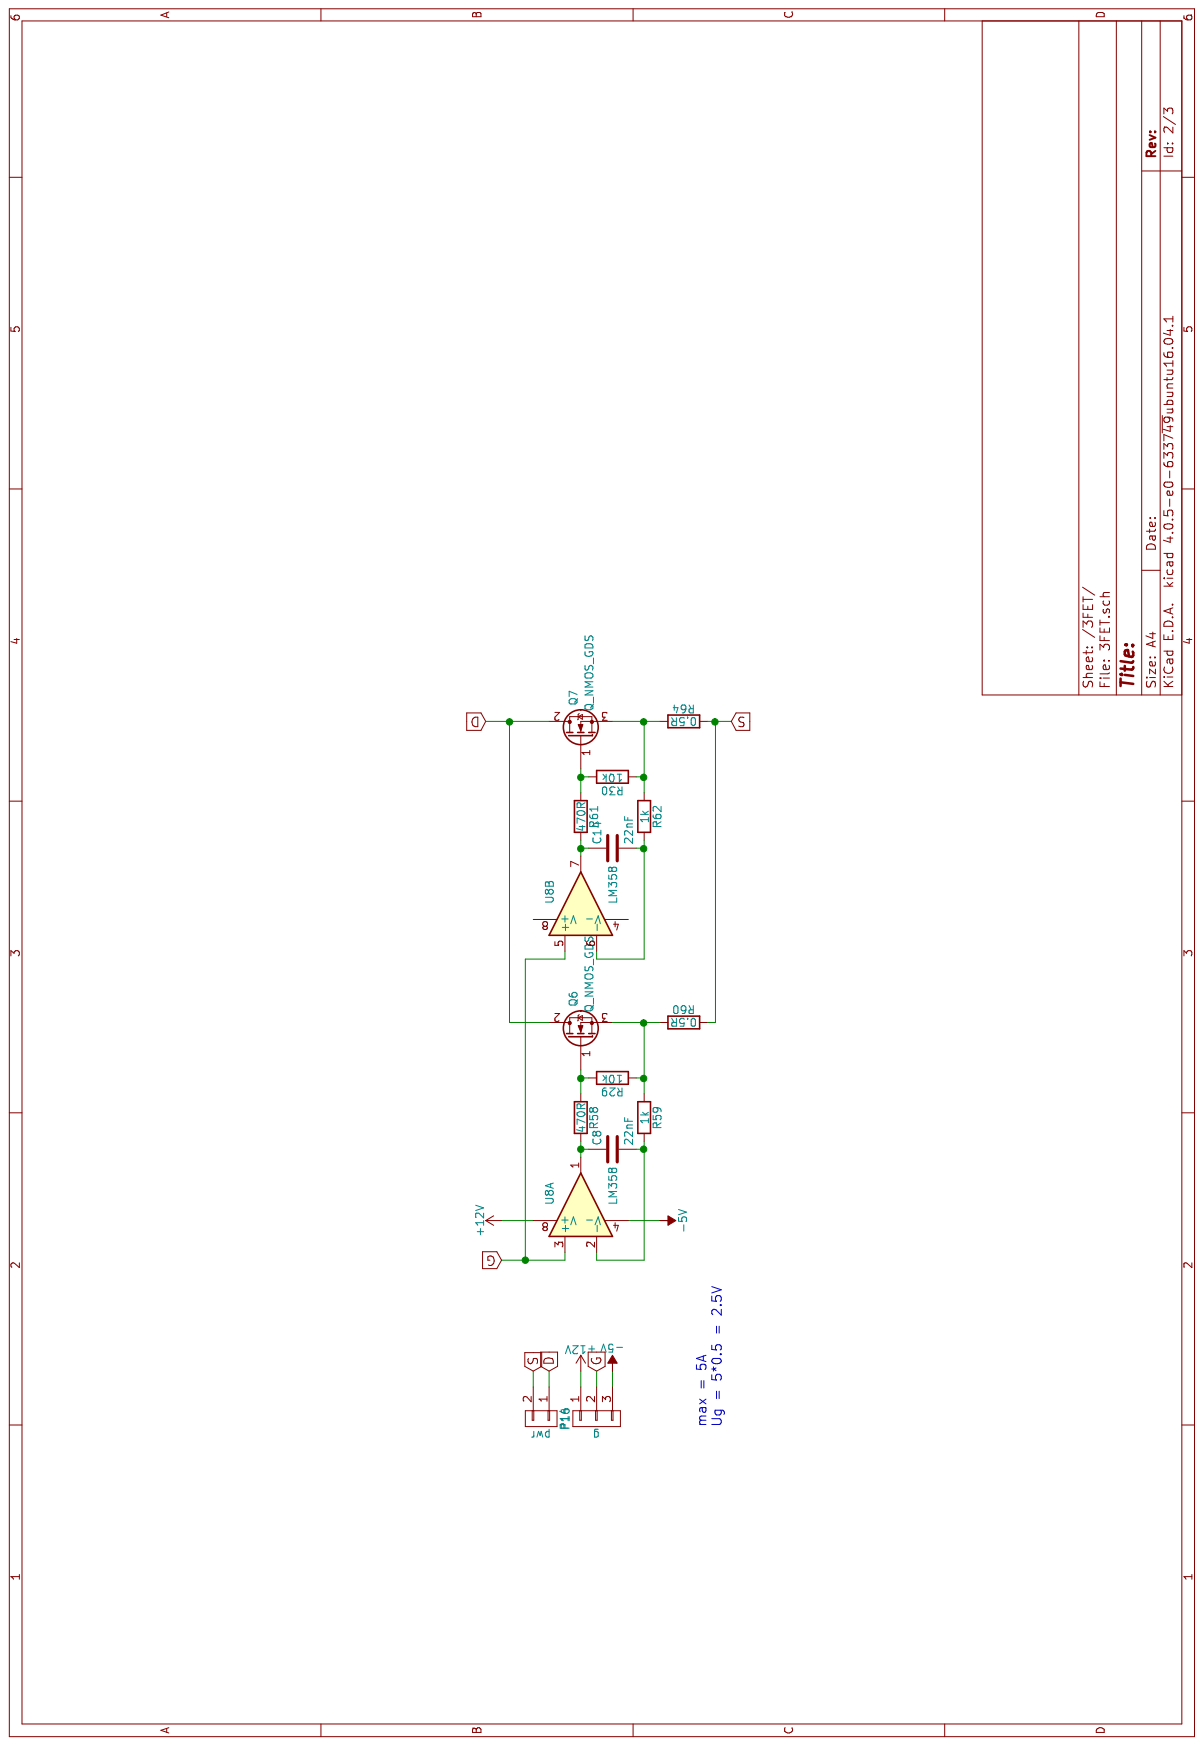
[picture p228: page 2]

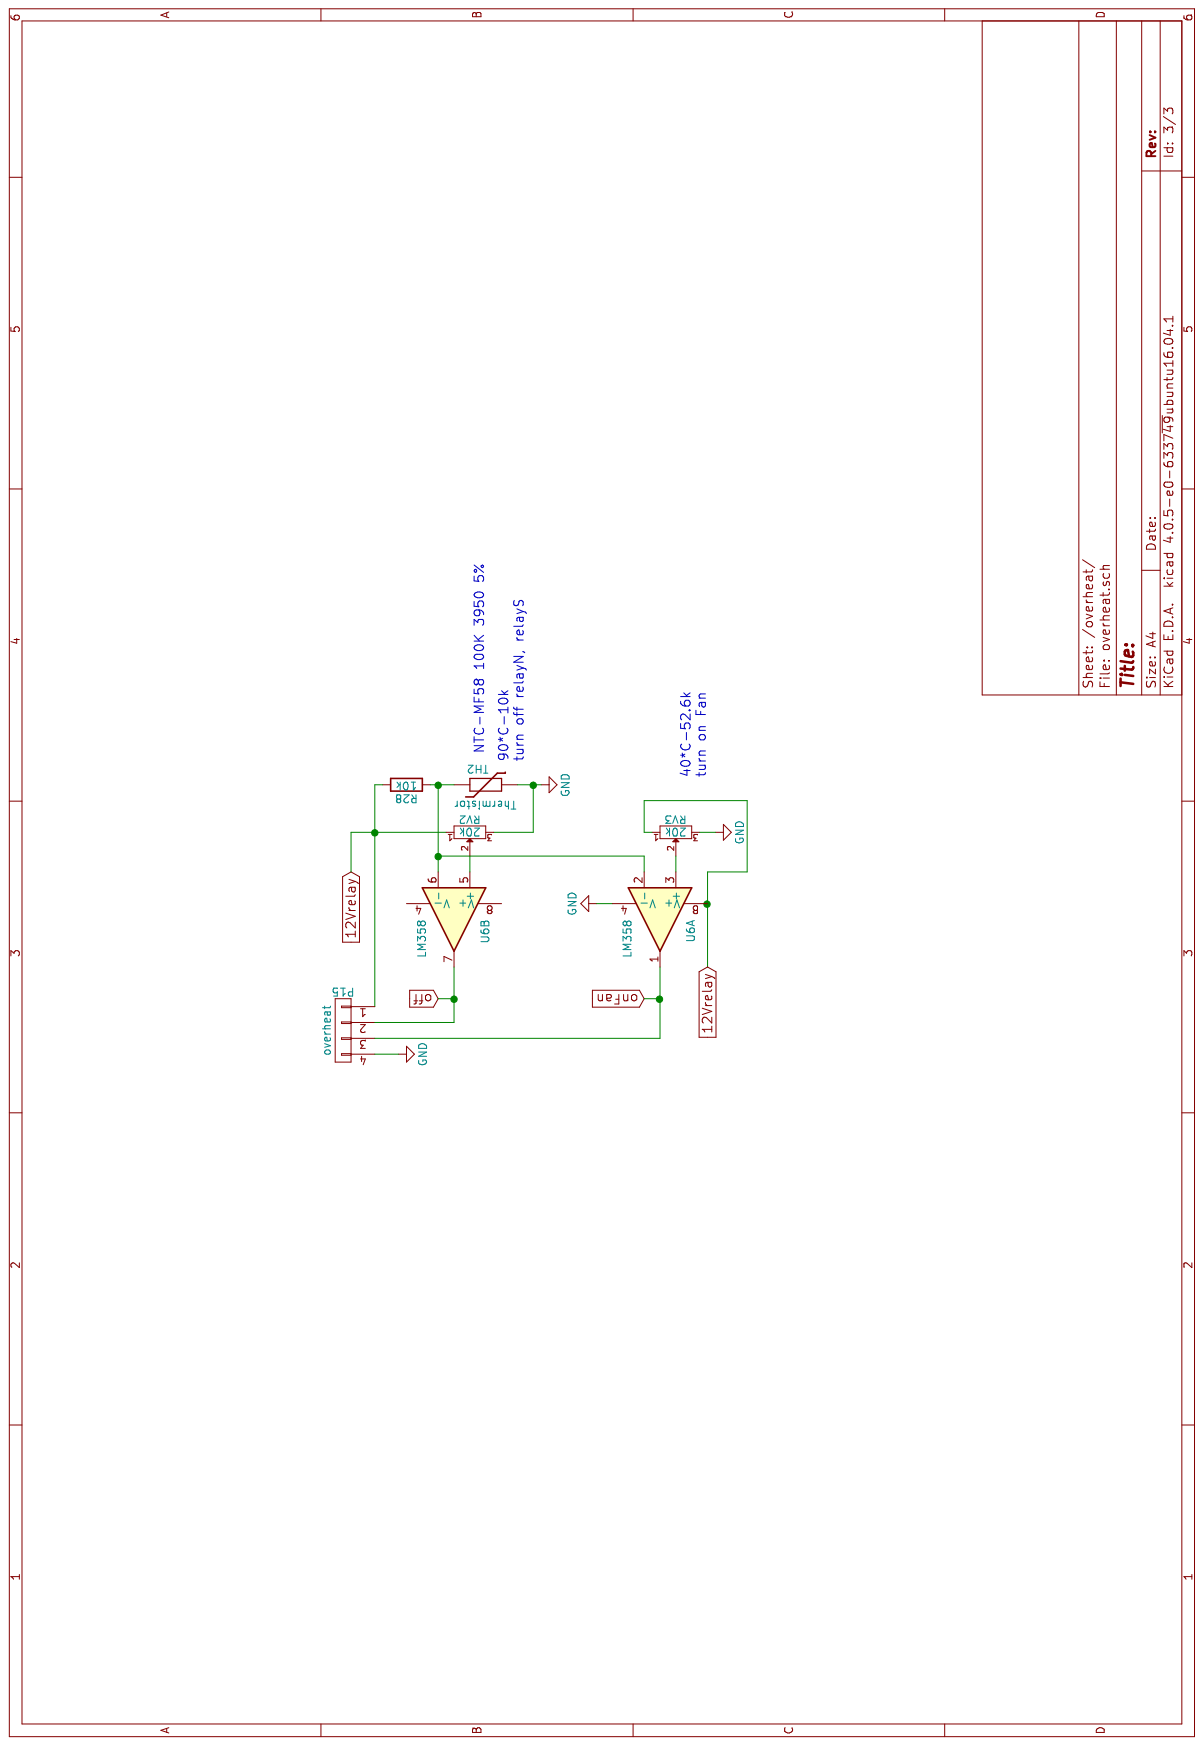
[picture p229: page 3]
