sangseu/kicad/project/3FET/output.pdf

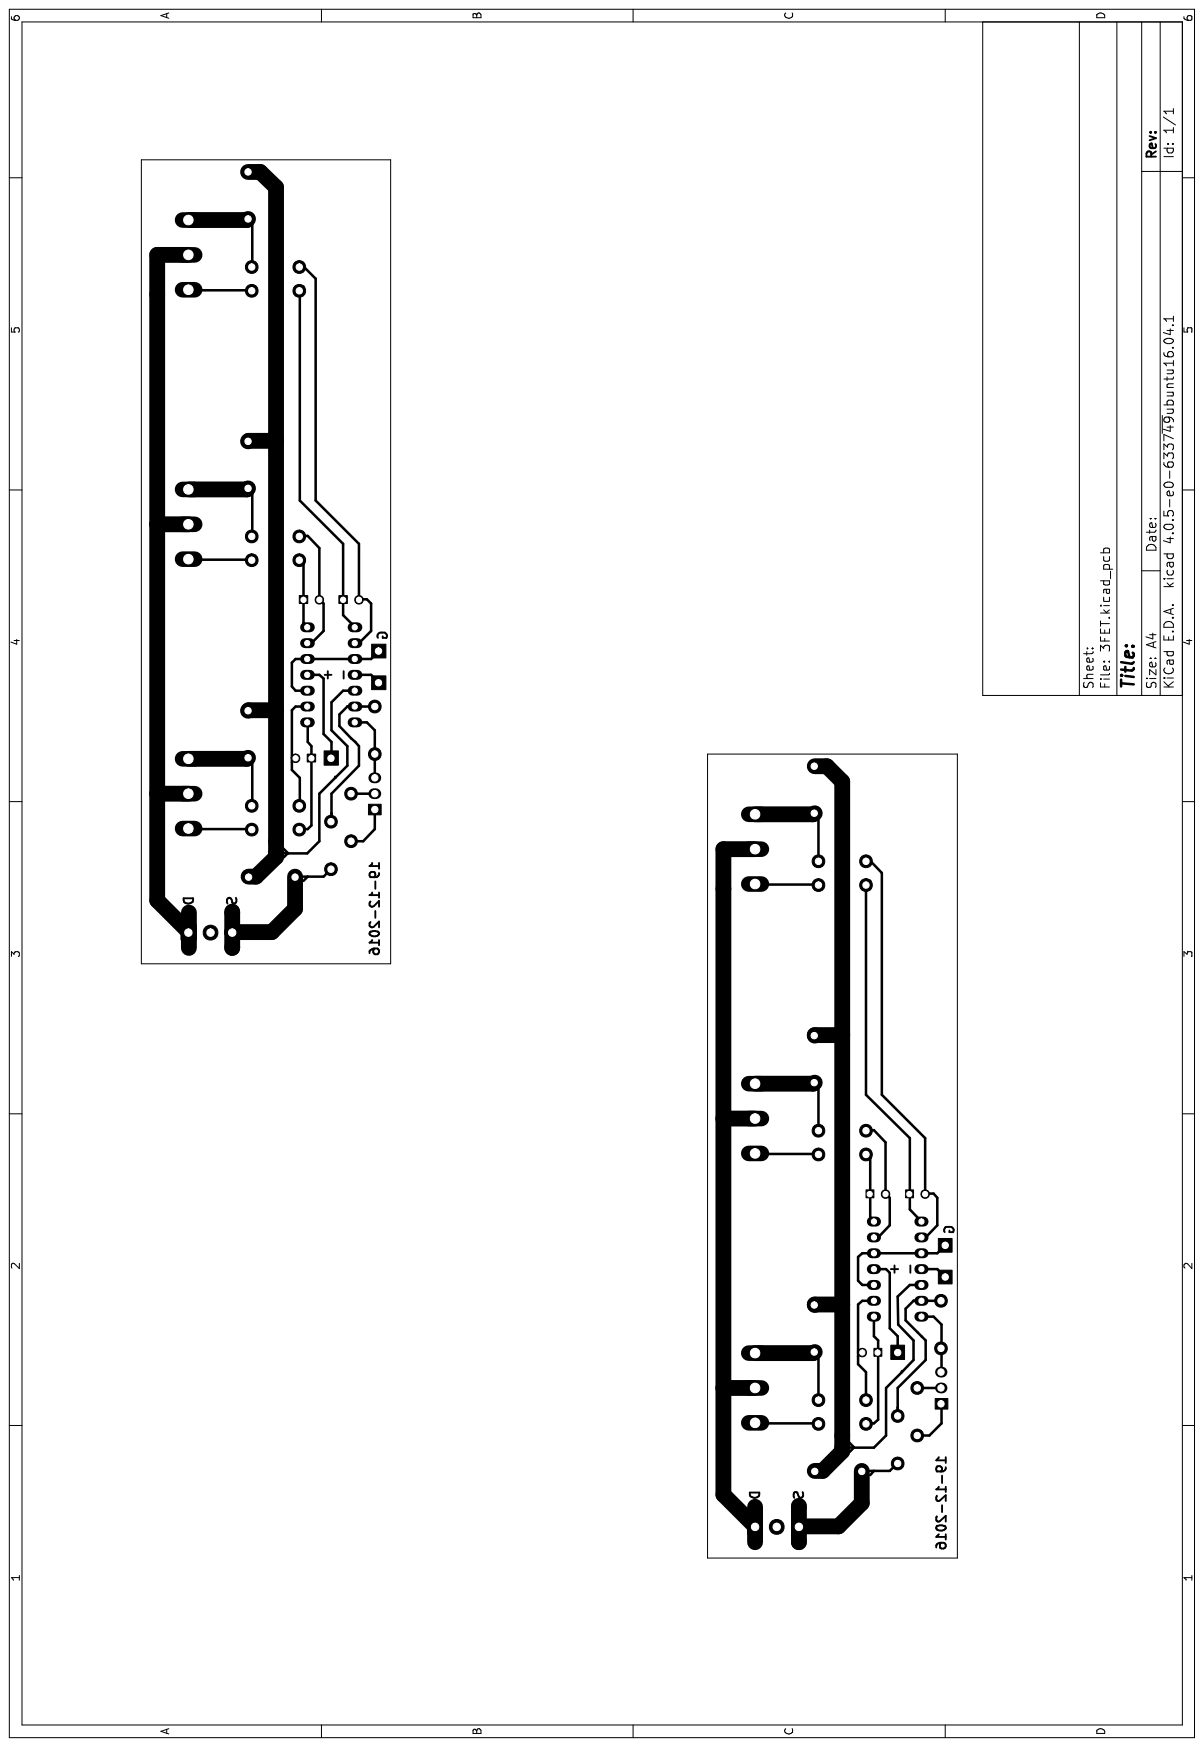
[picture p230: page 1]

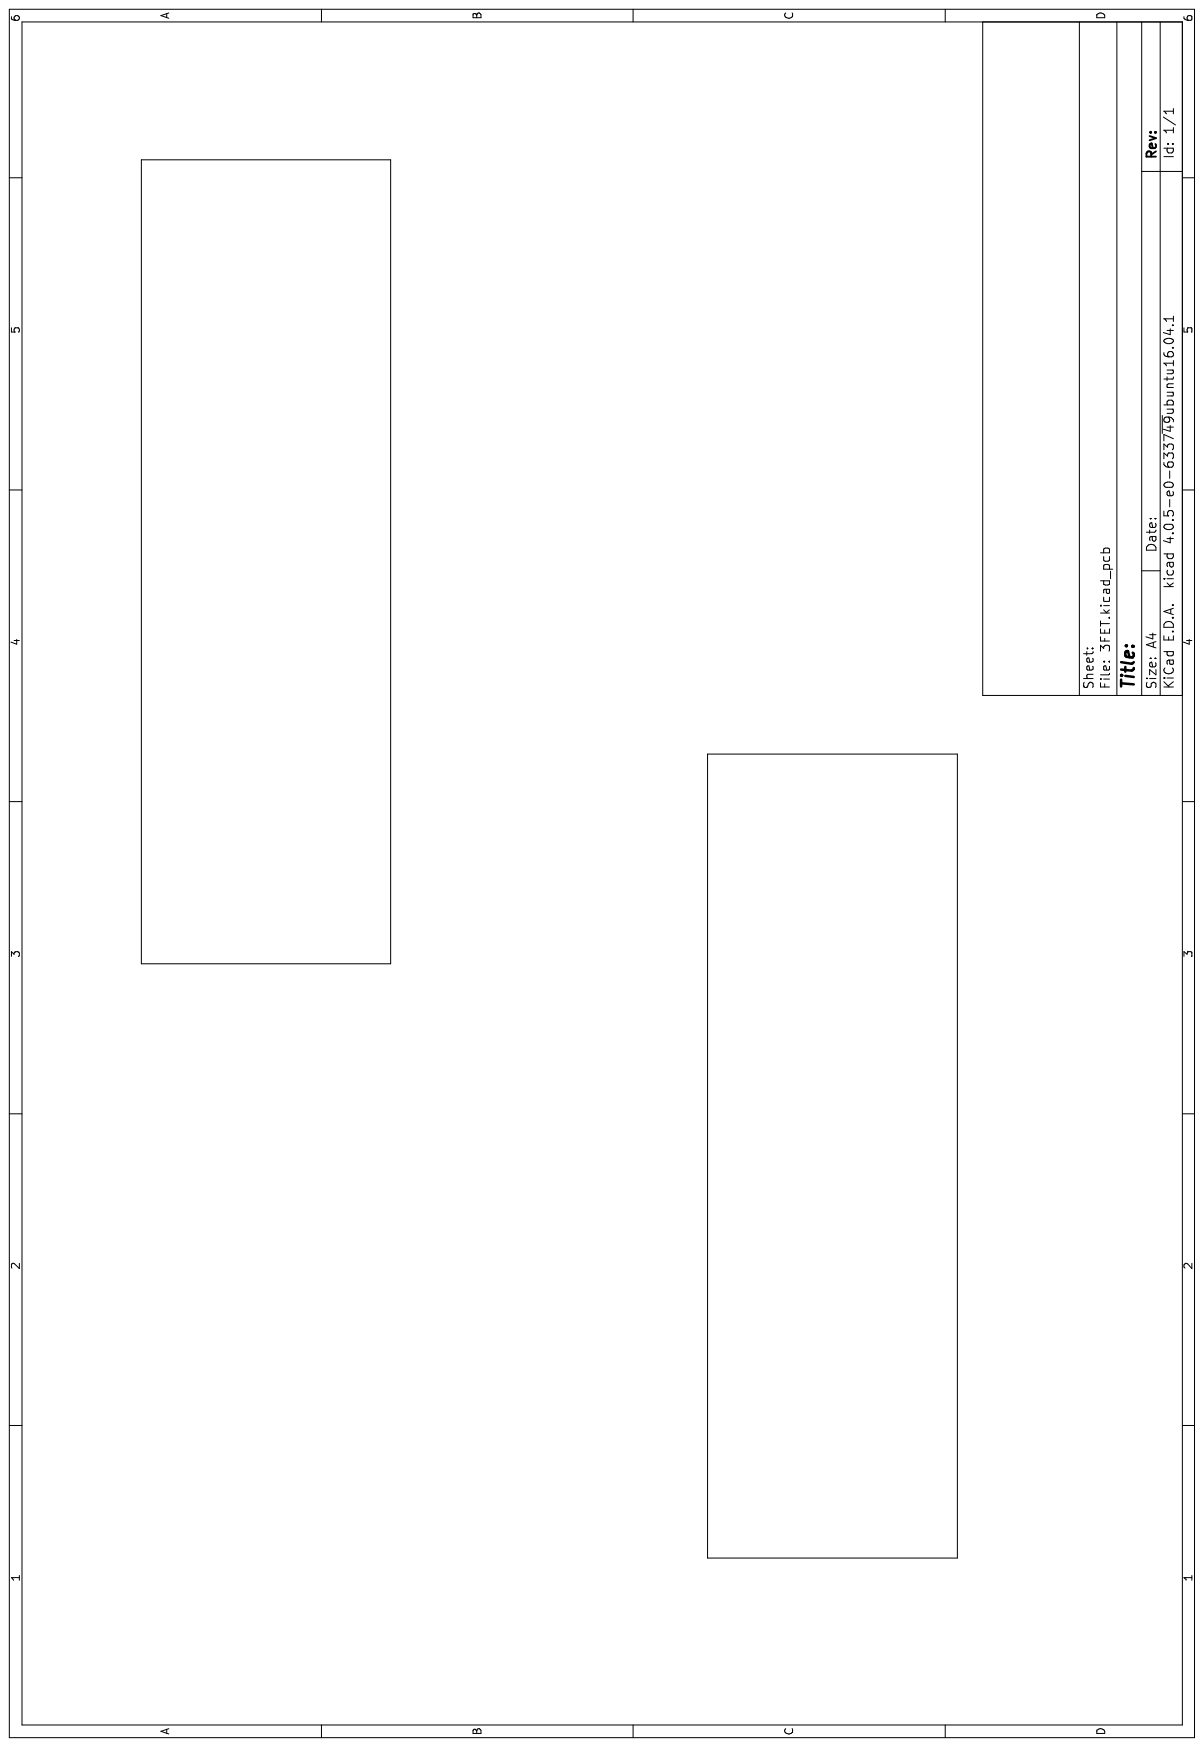
[picture p231: page 2]
