sangseu/kicad/project/3FET/output2.pdf

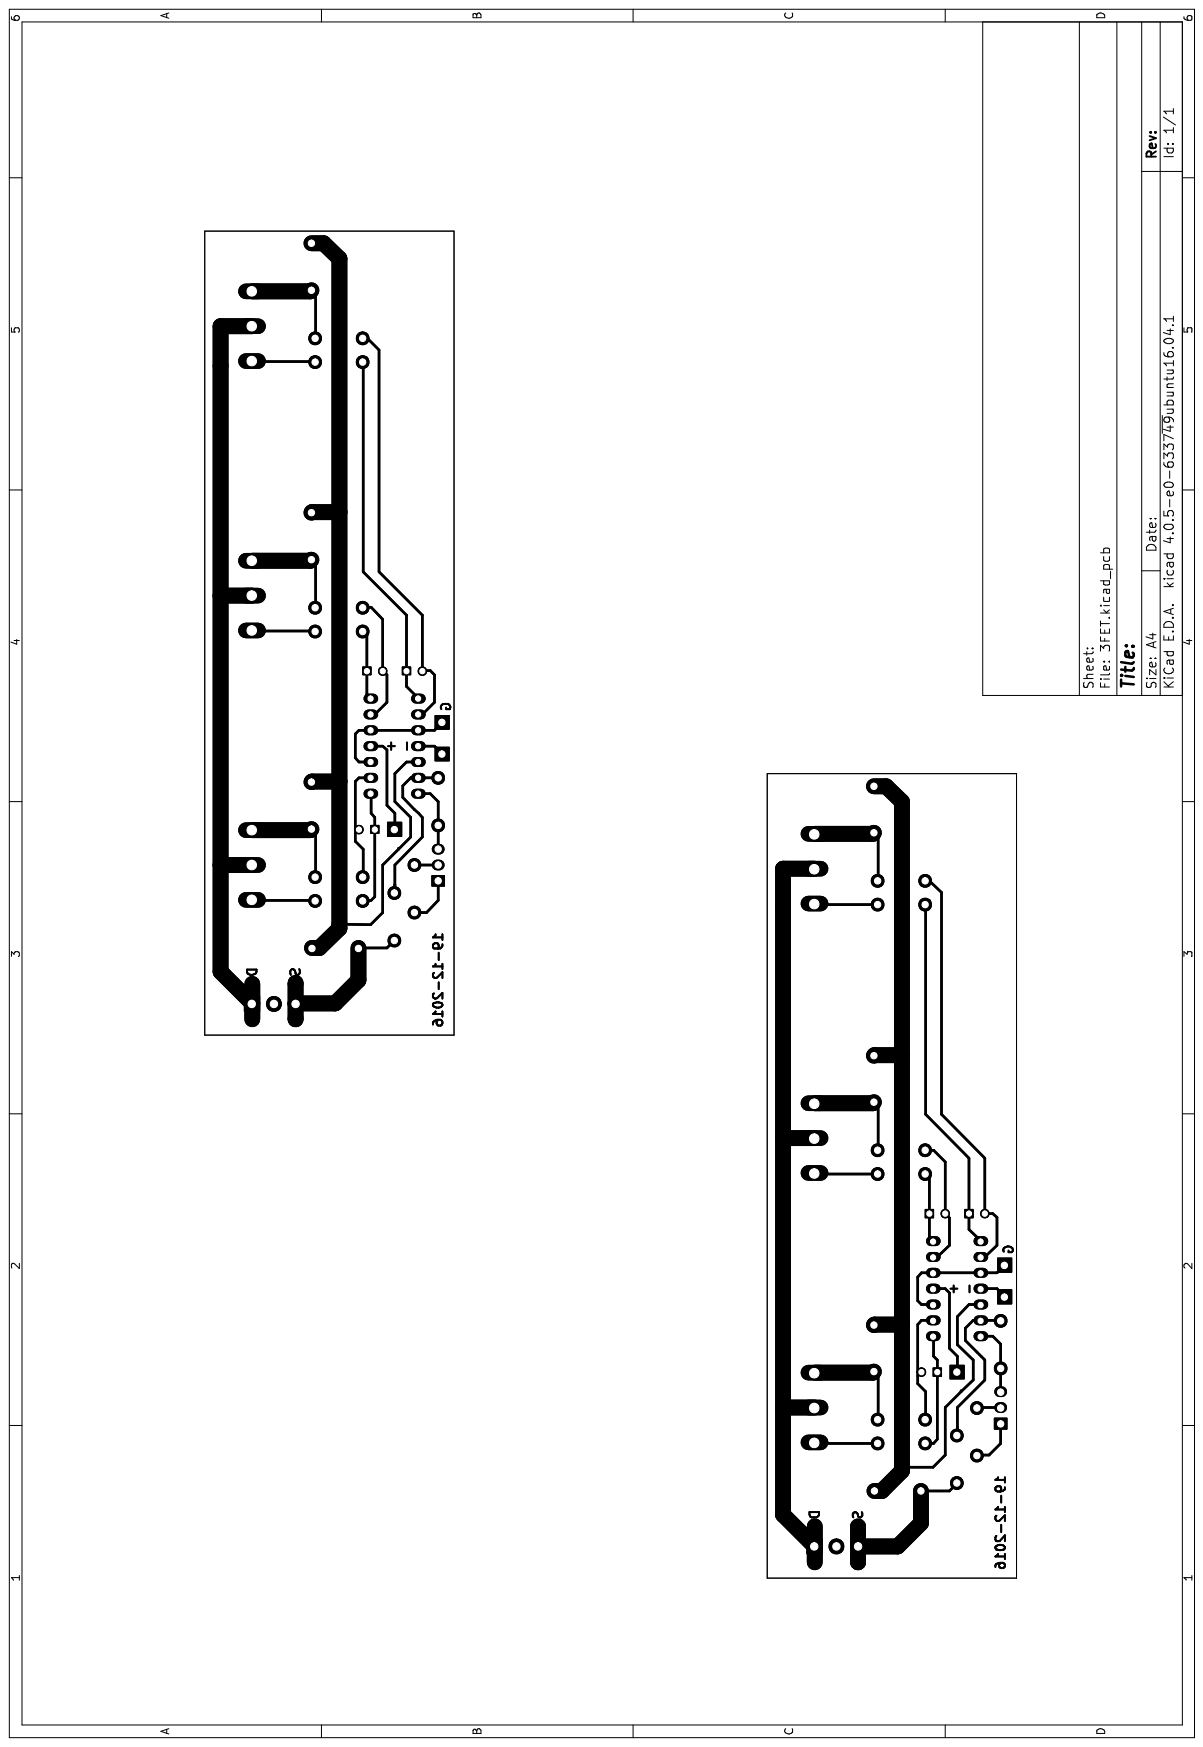
[picture p232: page 1]

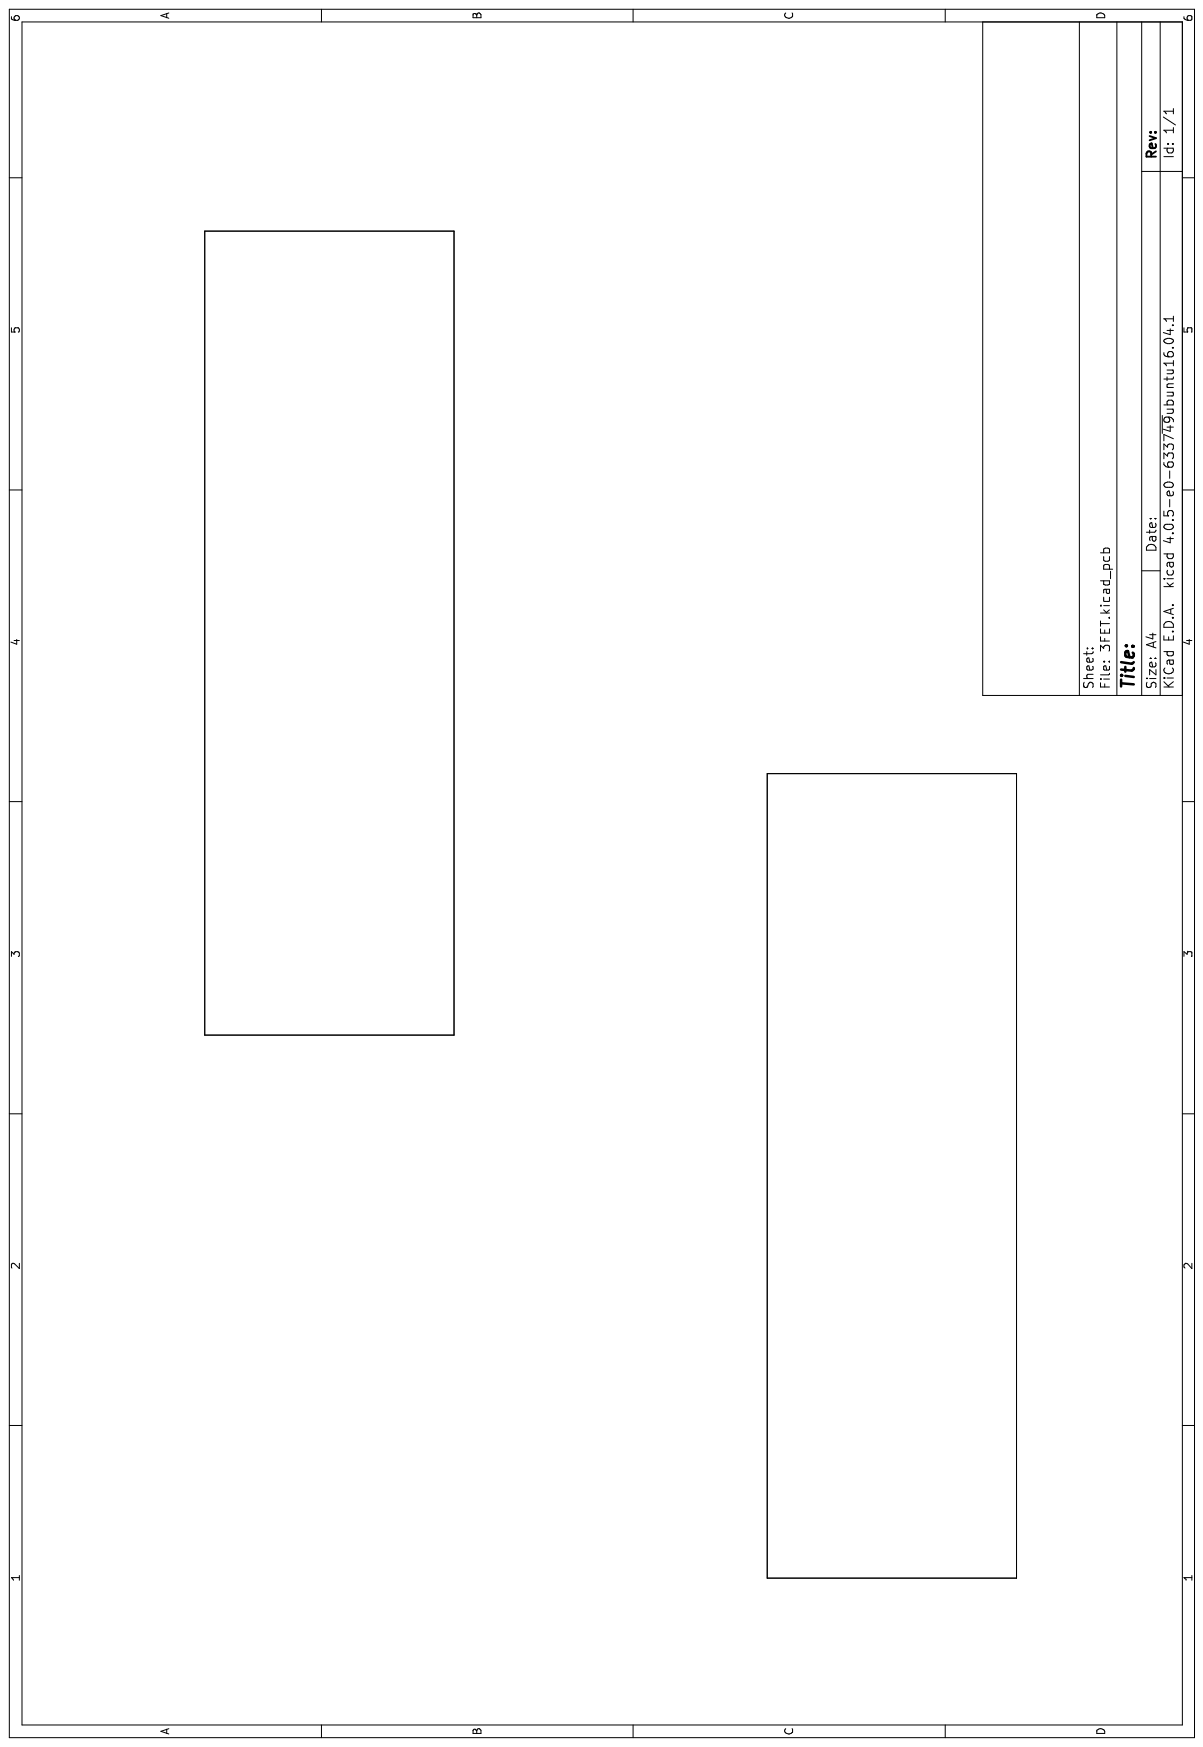
[picture p233: page 2]
