sangseu/kicad/project/charger v2/pics/output2.pdf

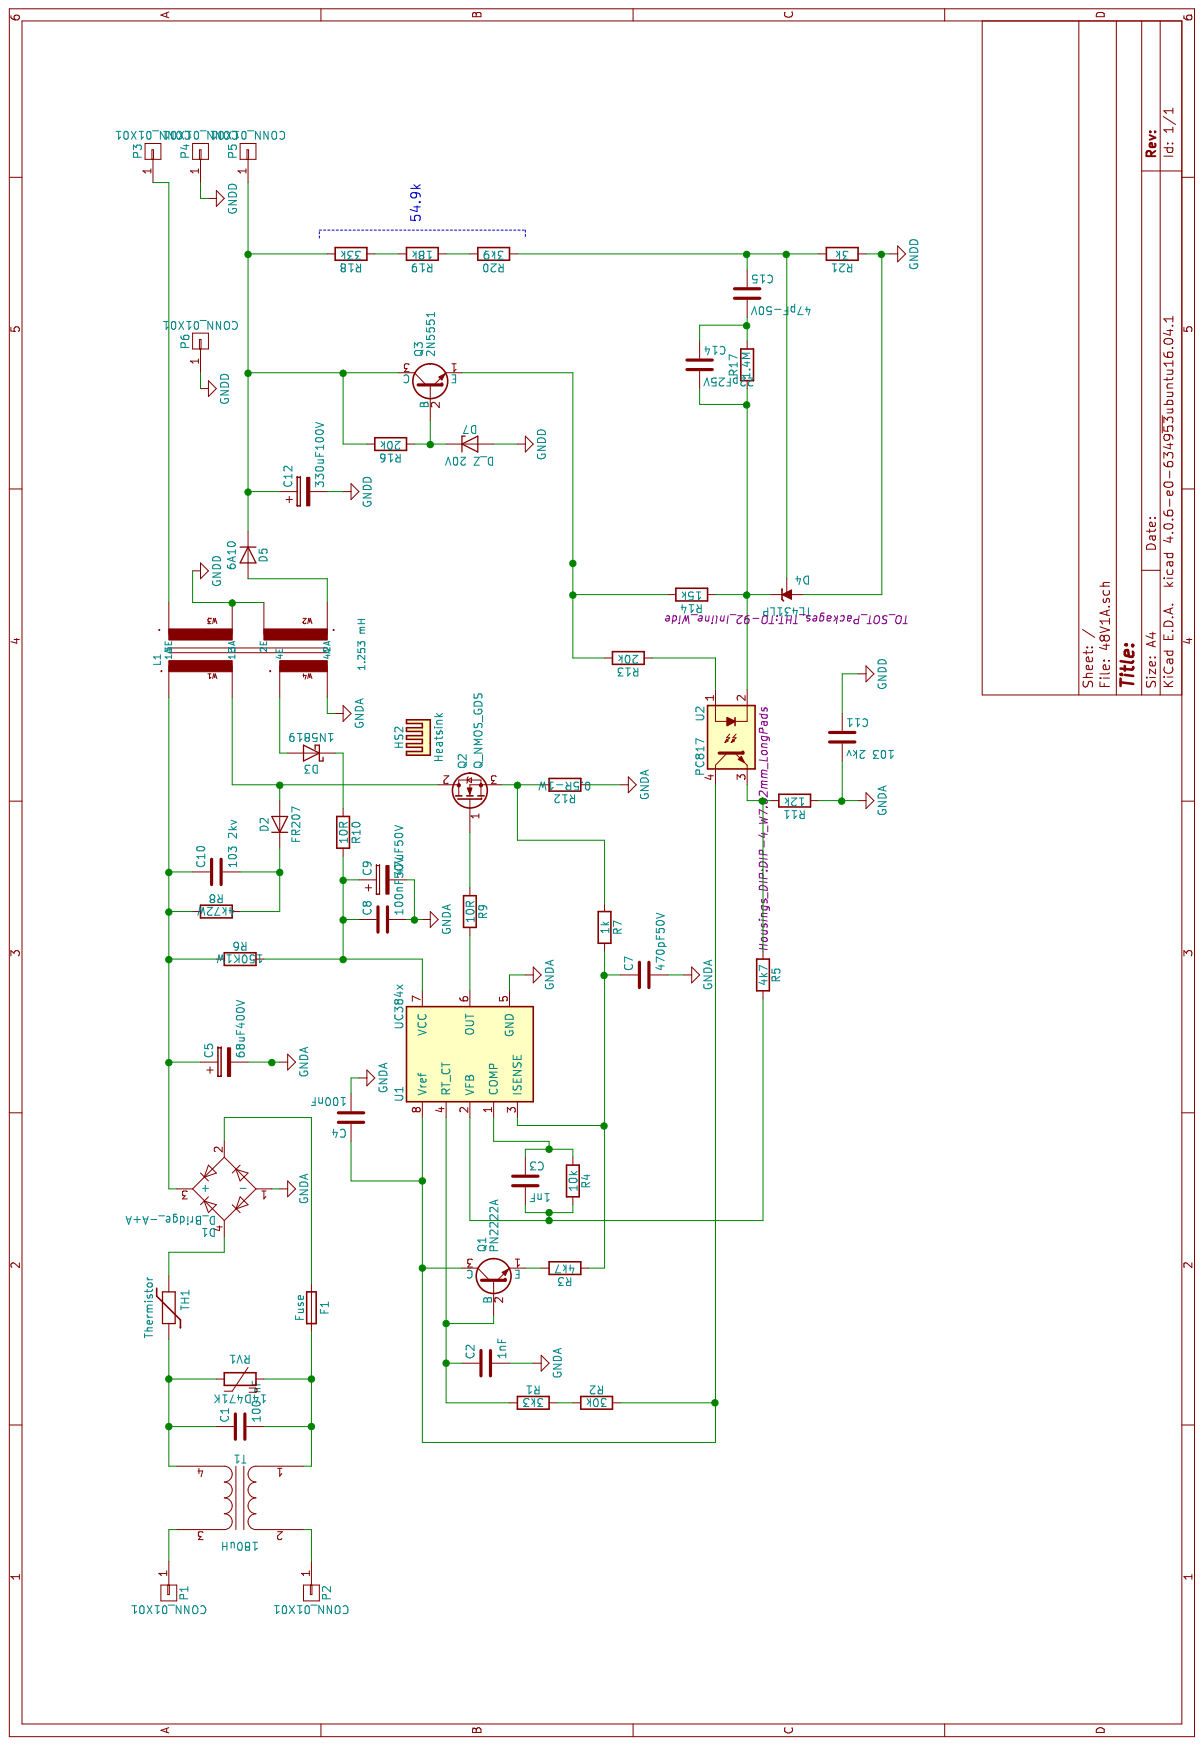
[picture p234: page 1]
