sangseu/kicad/project/load_v2/schema_black.pdf

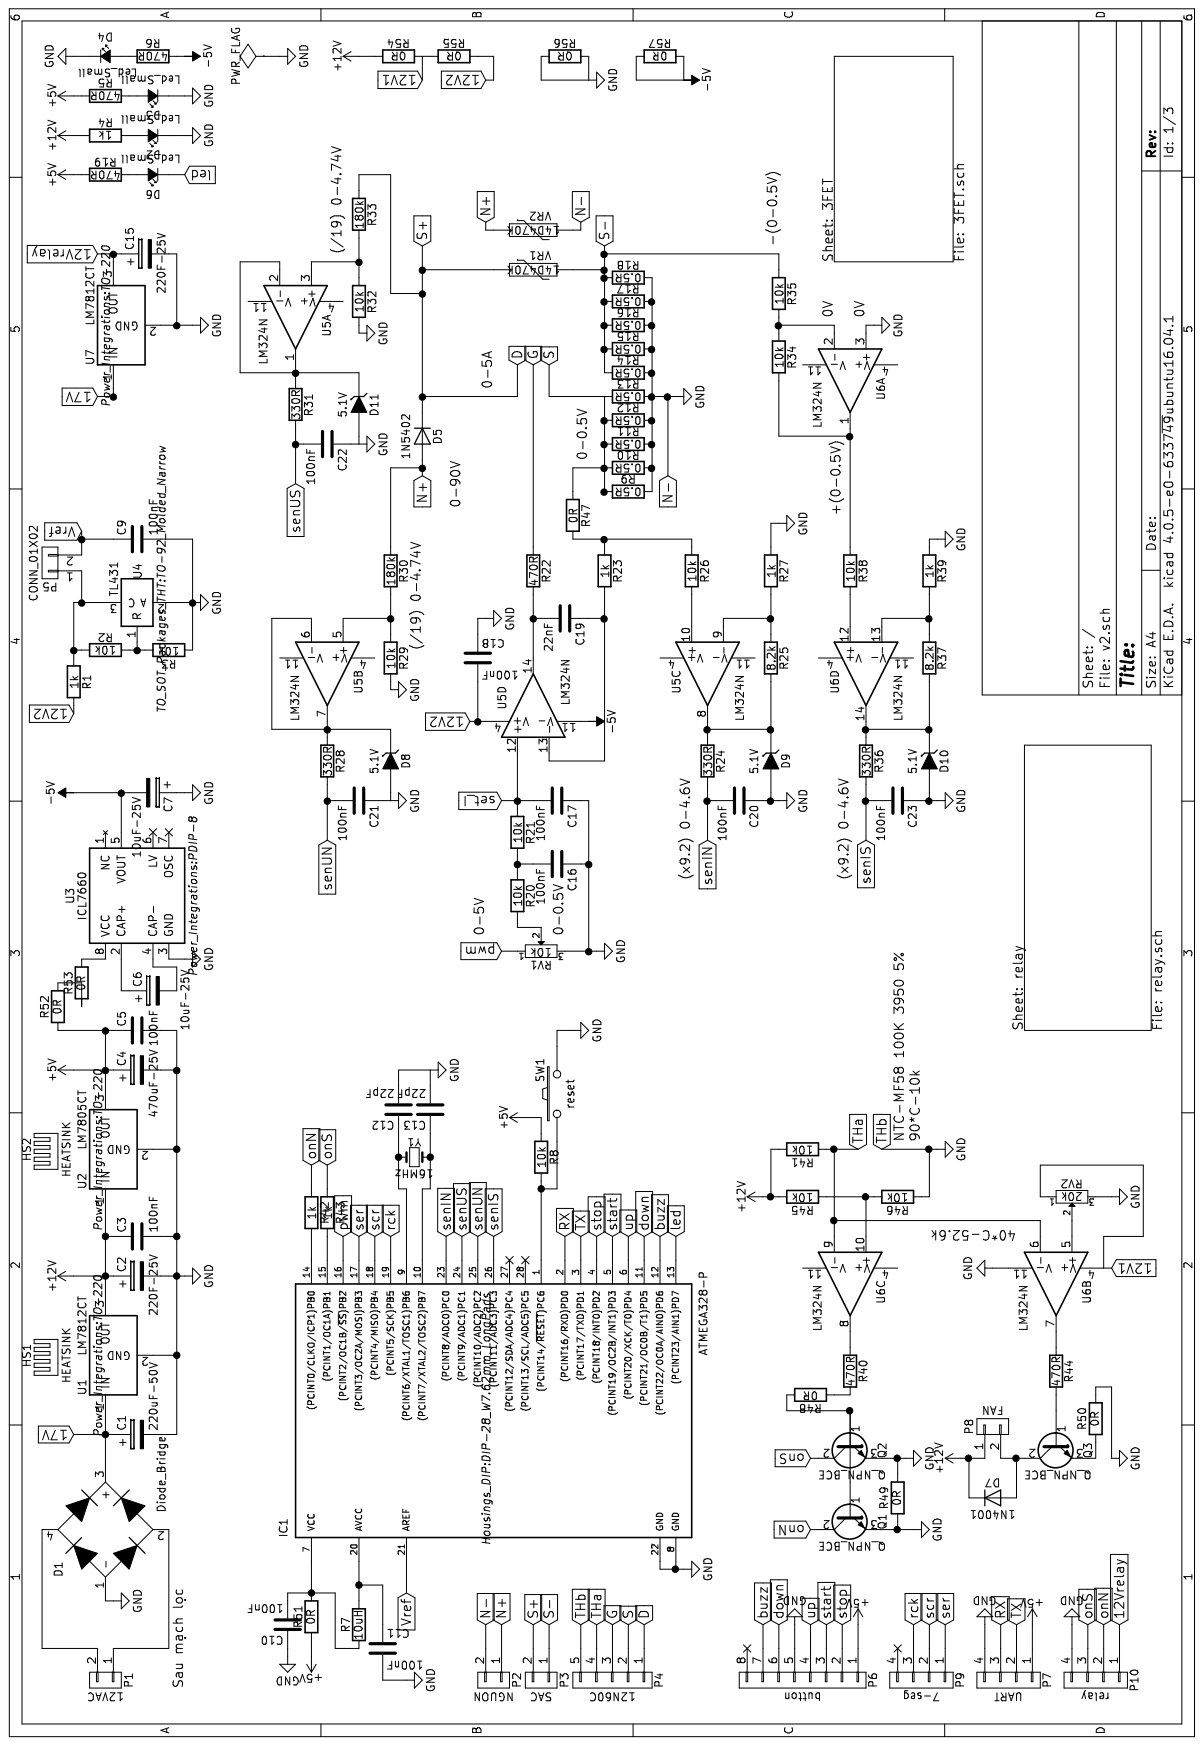
[picture p235: page 1]

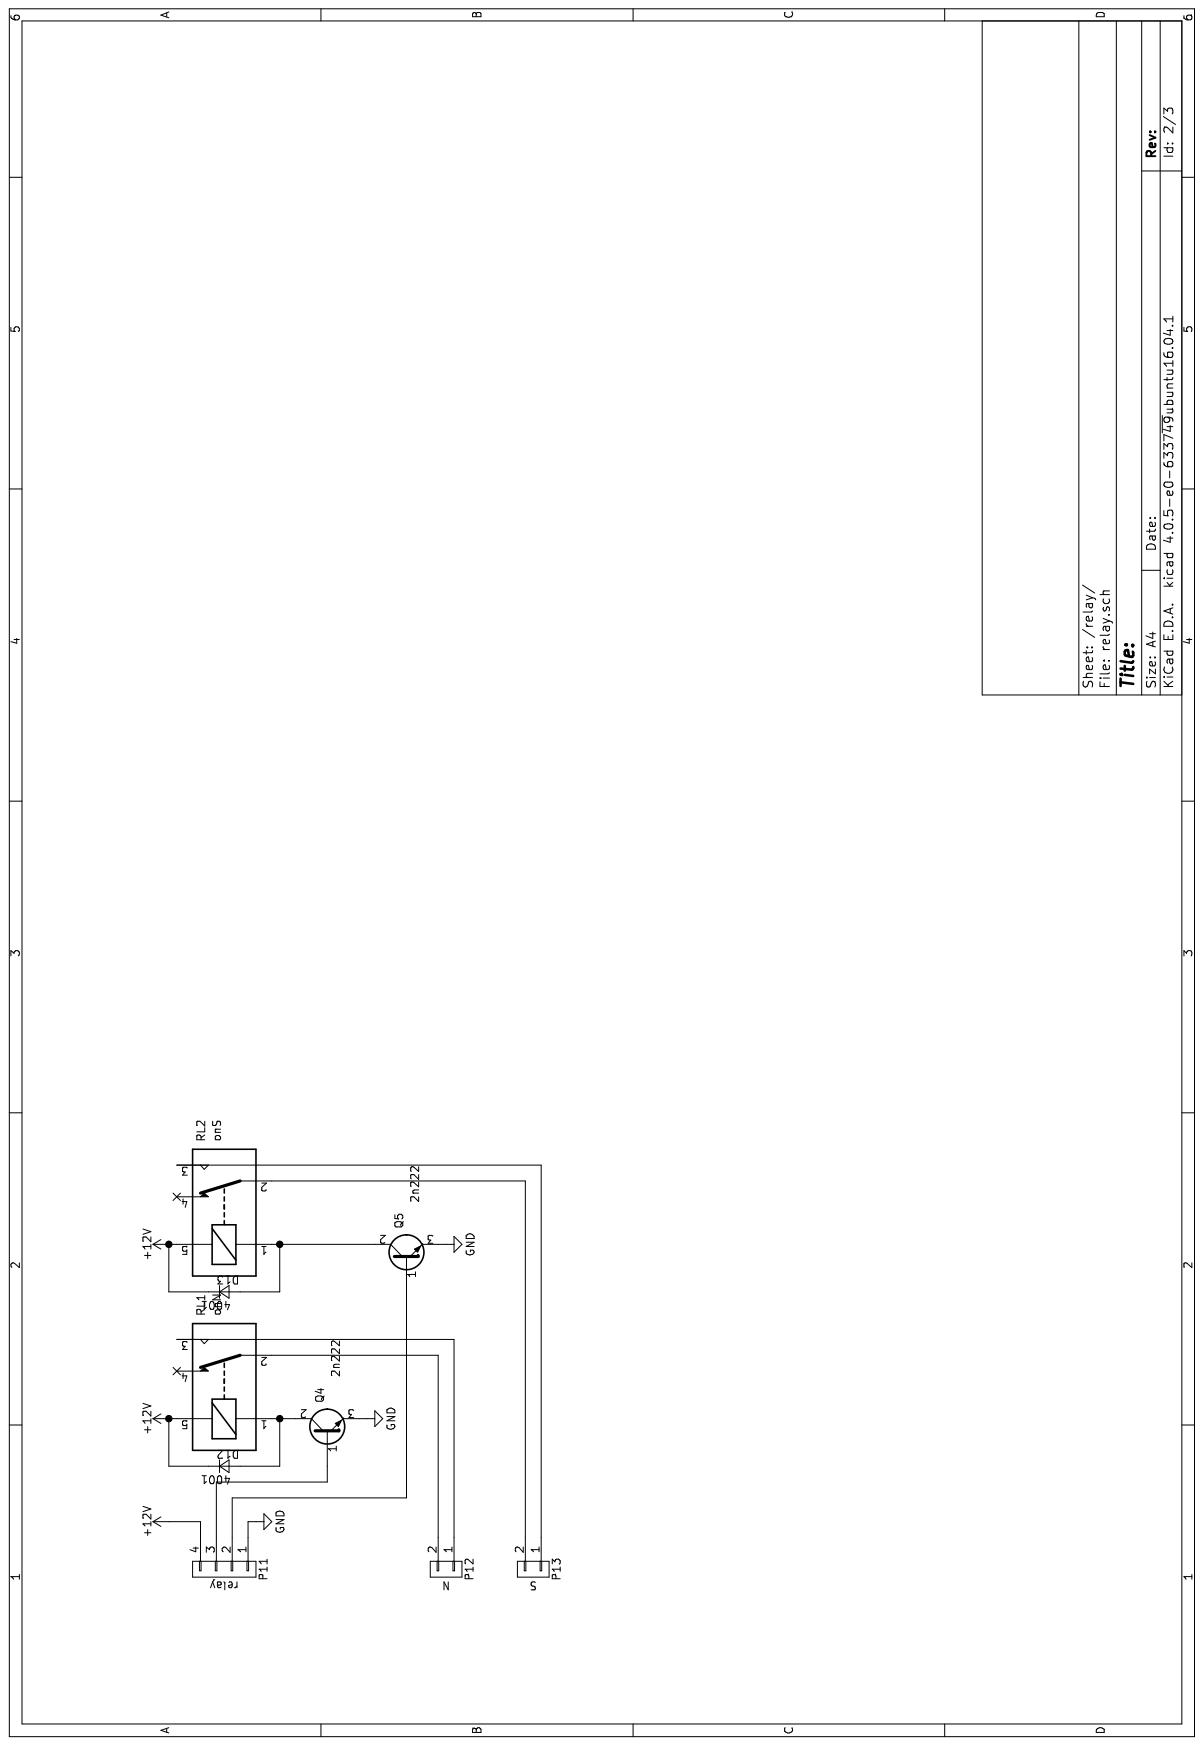
[picture p236: page 2]

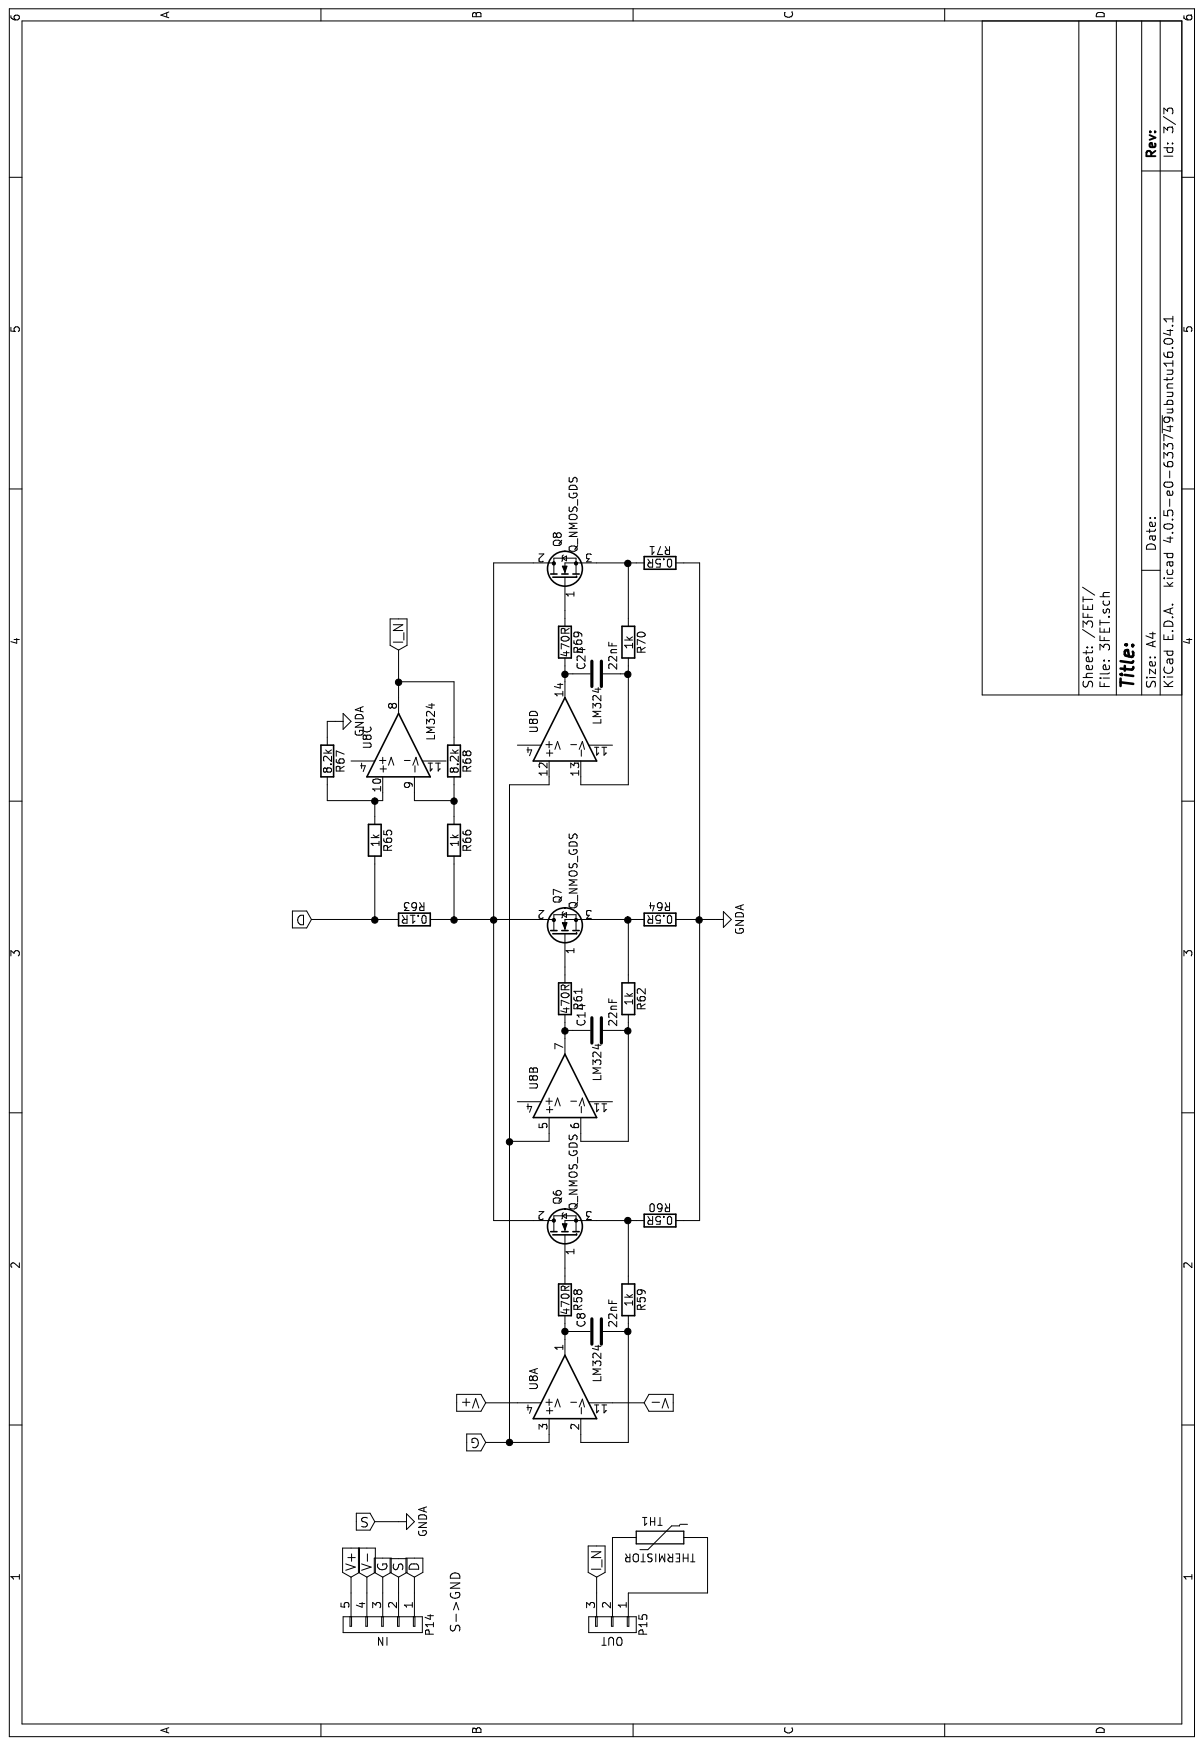
[picture p237: page 3]
