sangseu/kicad/project/load_v2/schema_color.pdf

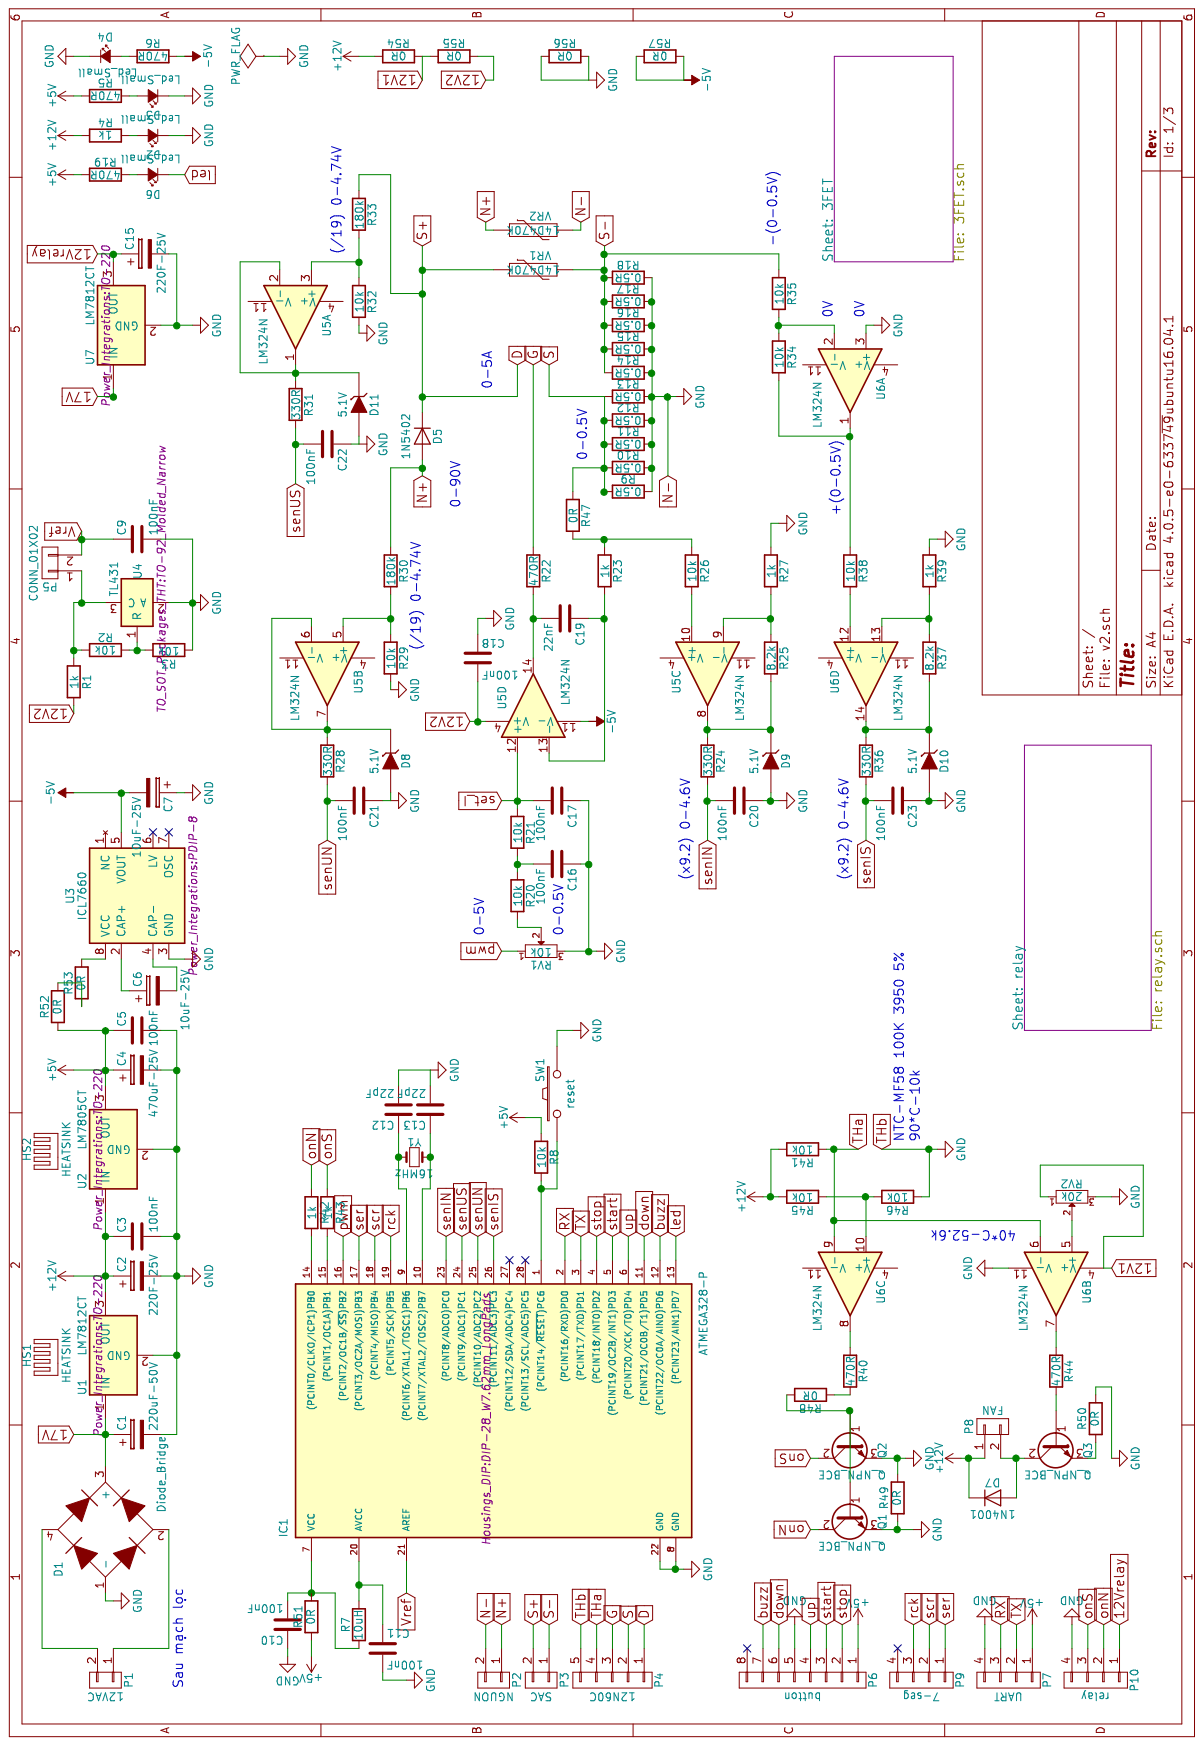
[picture p238: page 1]

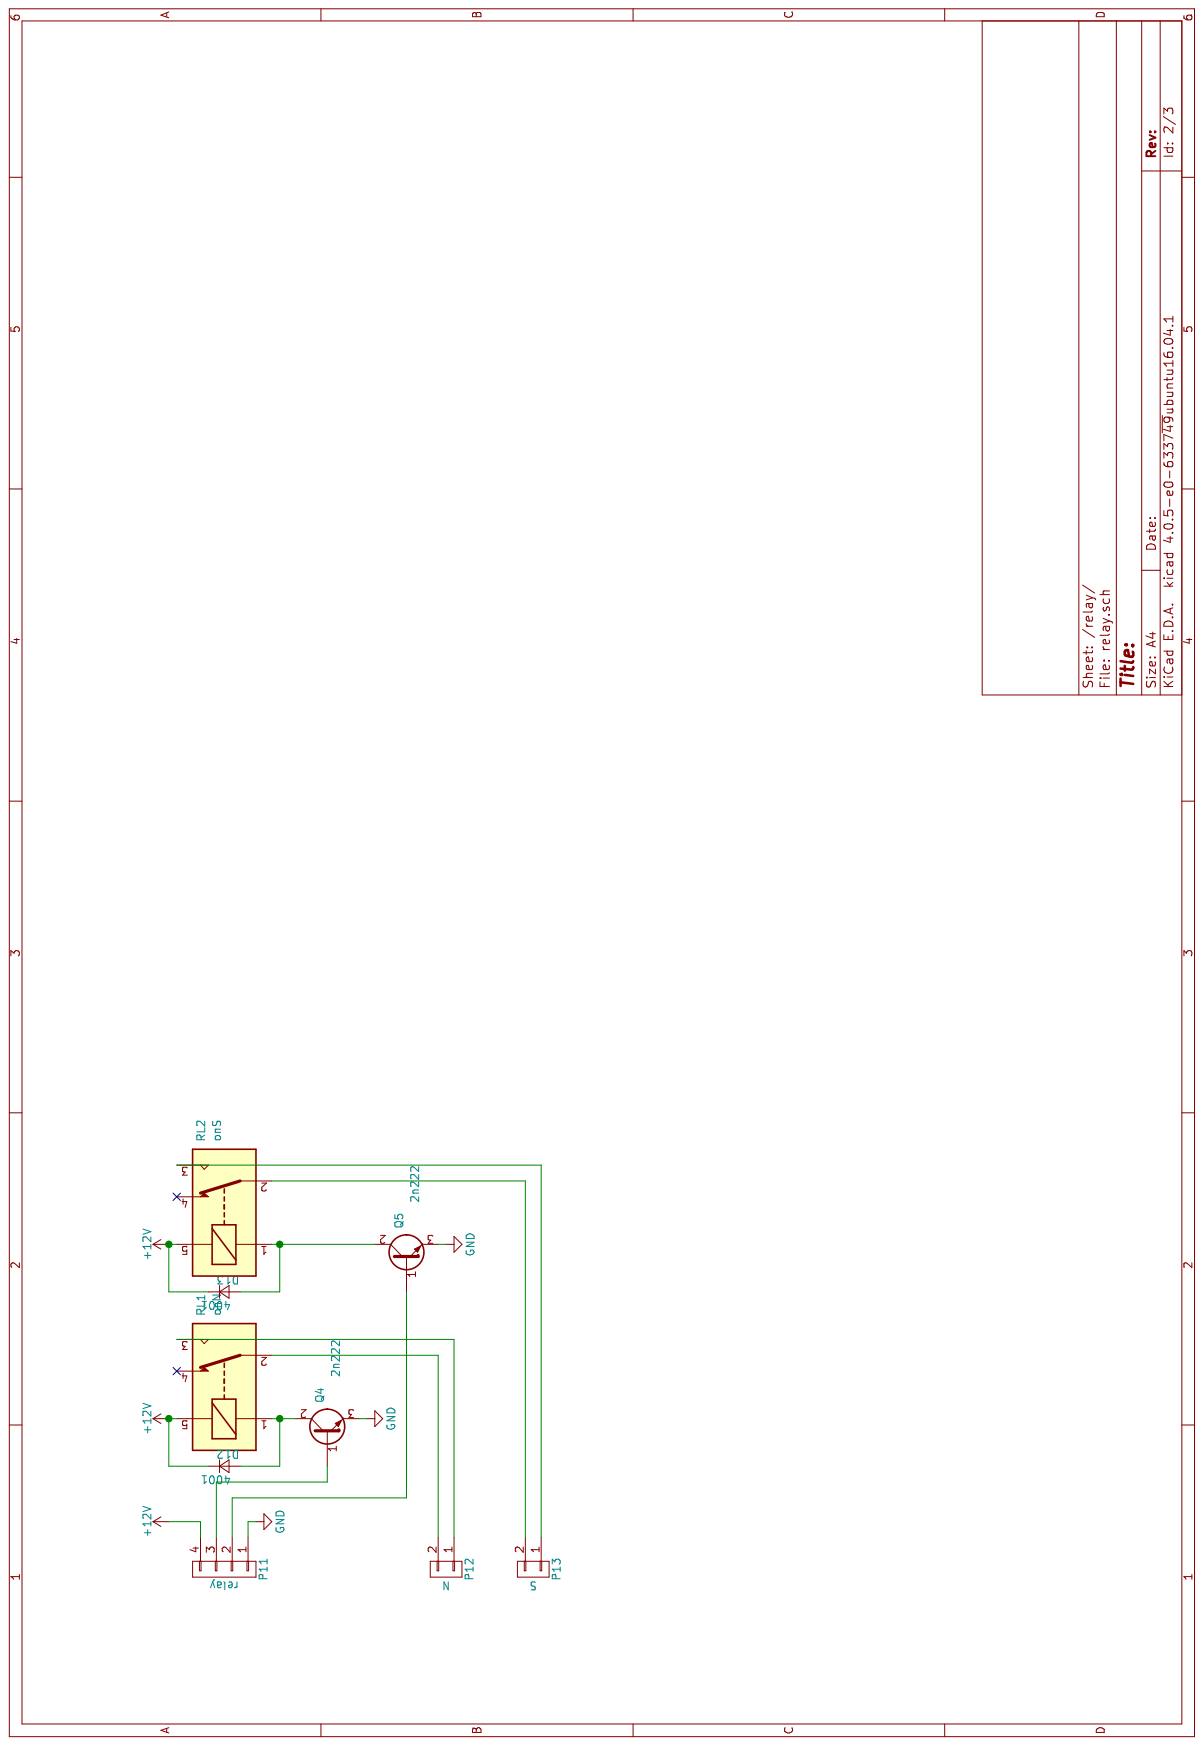
[picture p239: page 2]

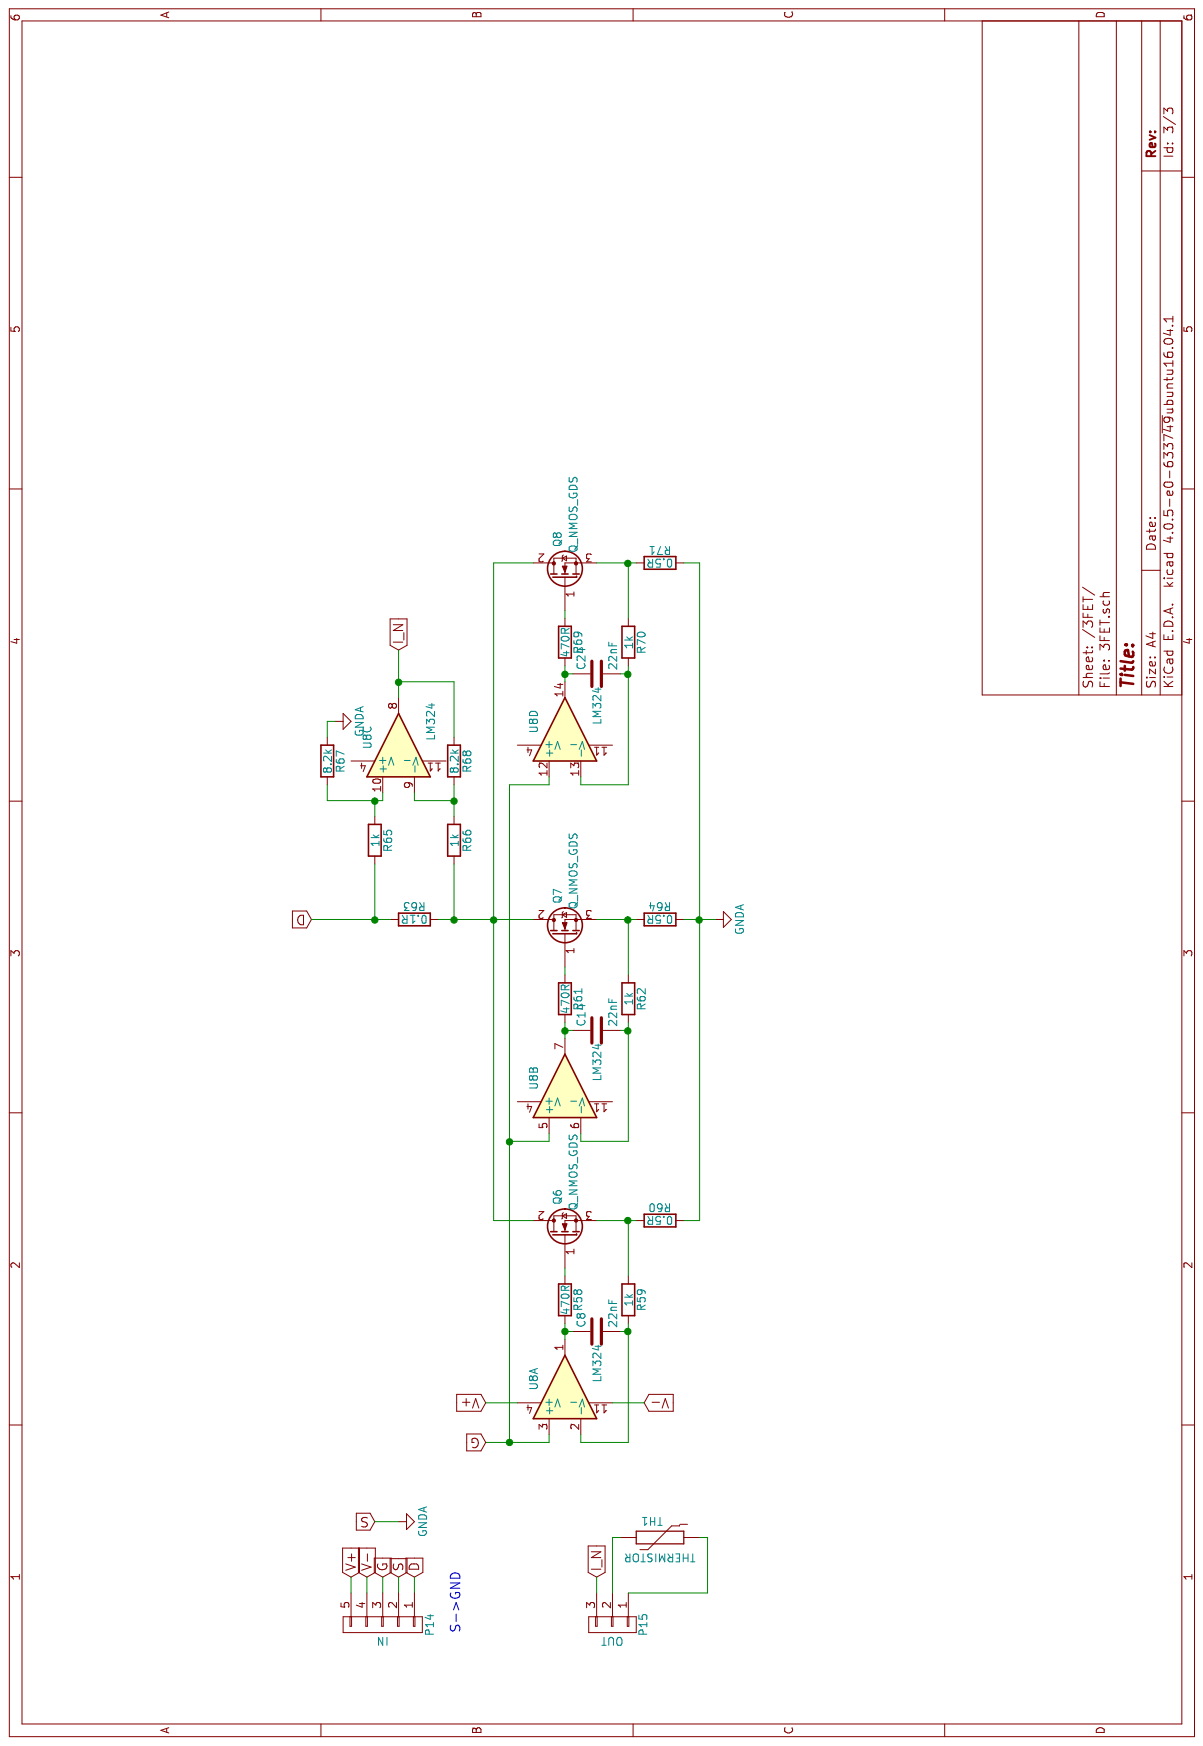
[picture p240: page 3]
