sangseu/kicad/project/load_v2/load.pdf

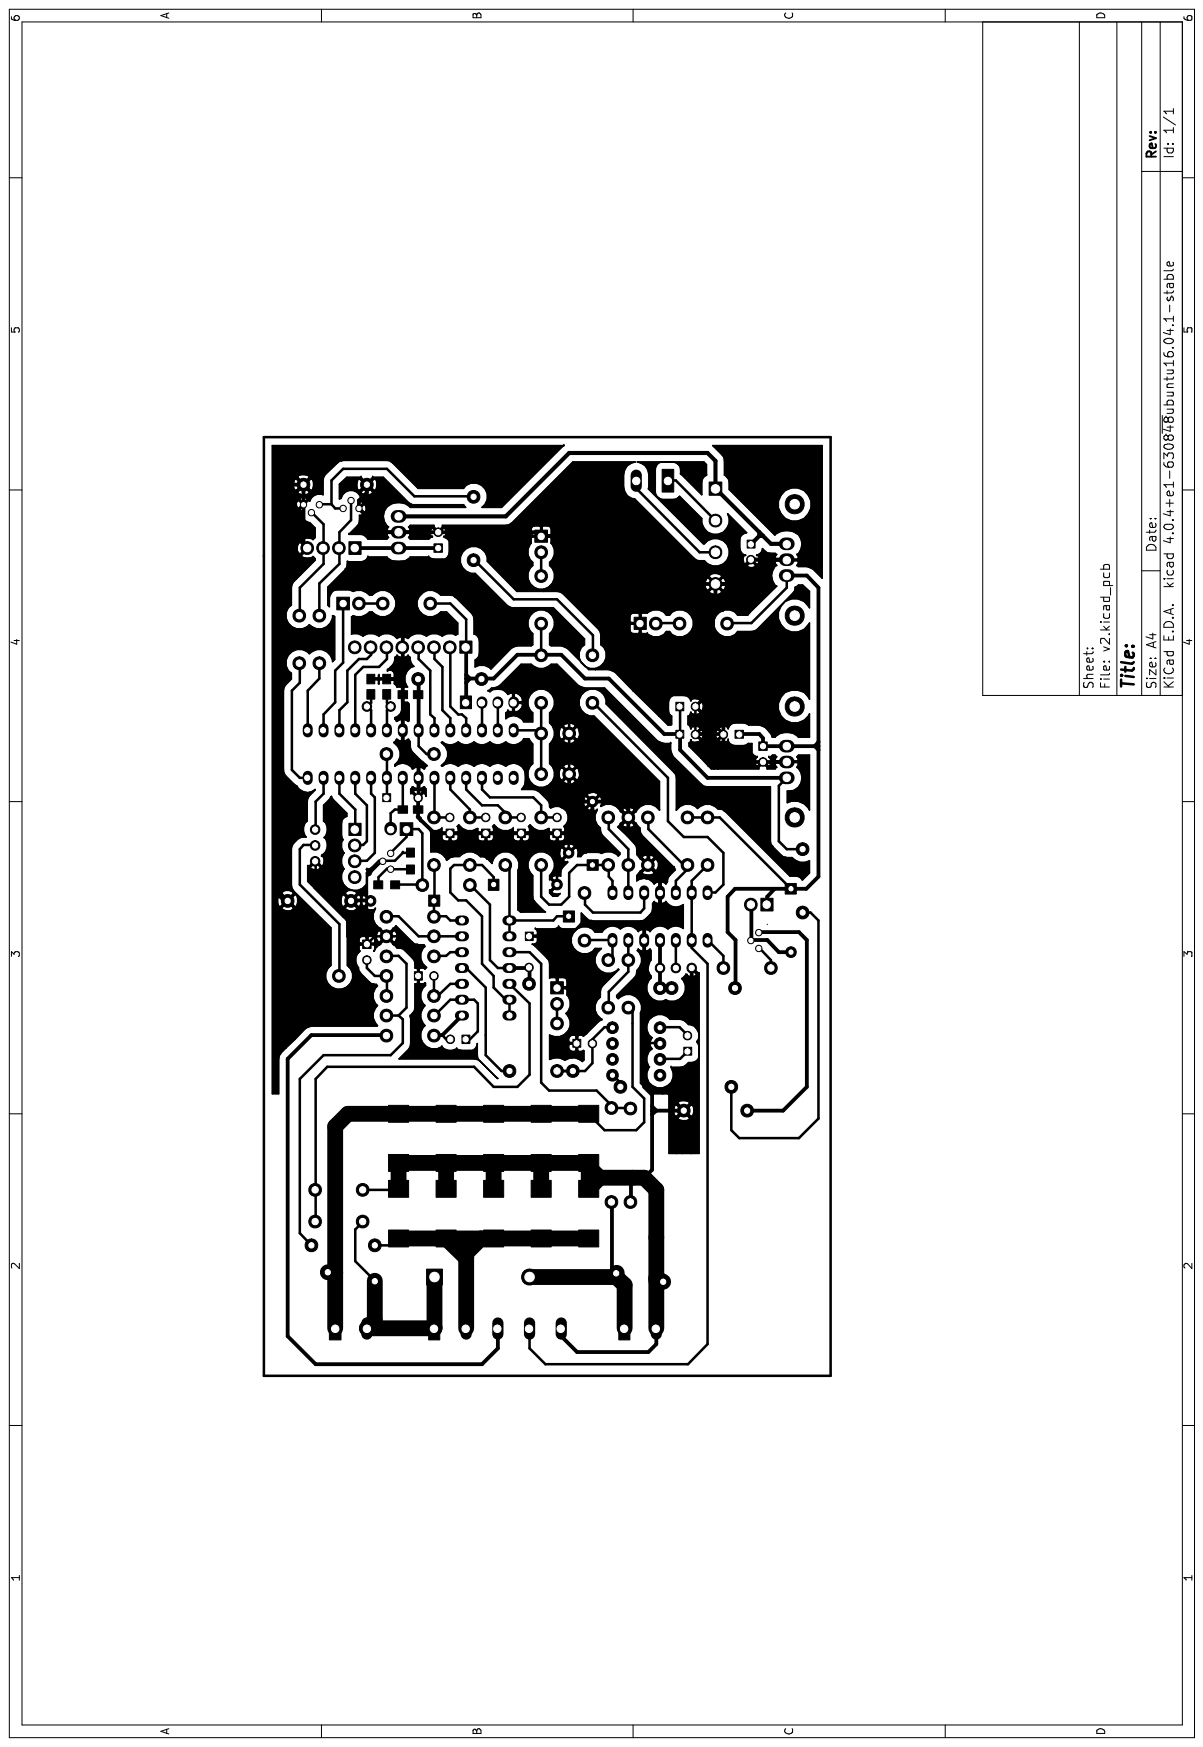
[picture p241: page 1]

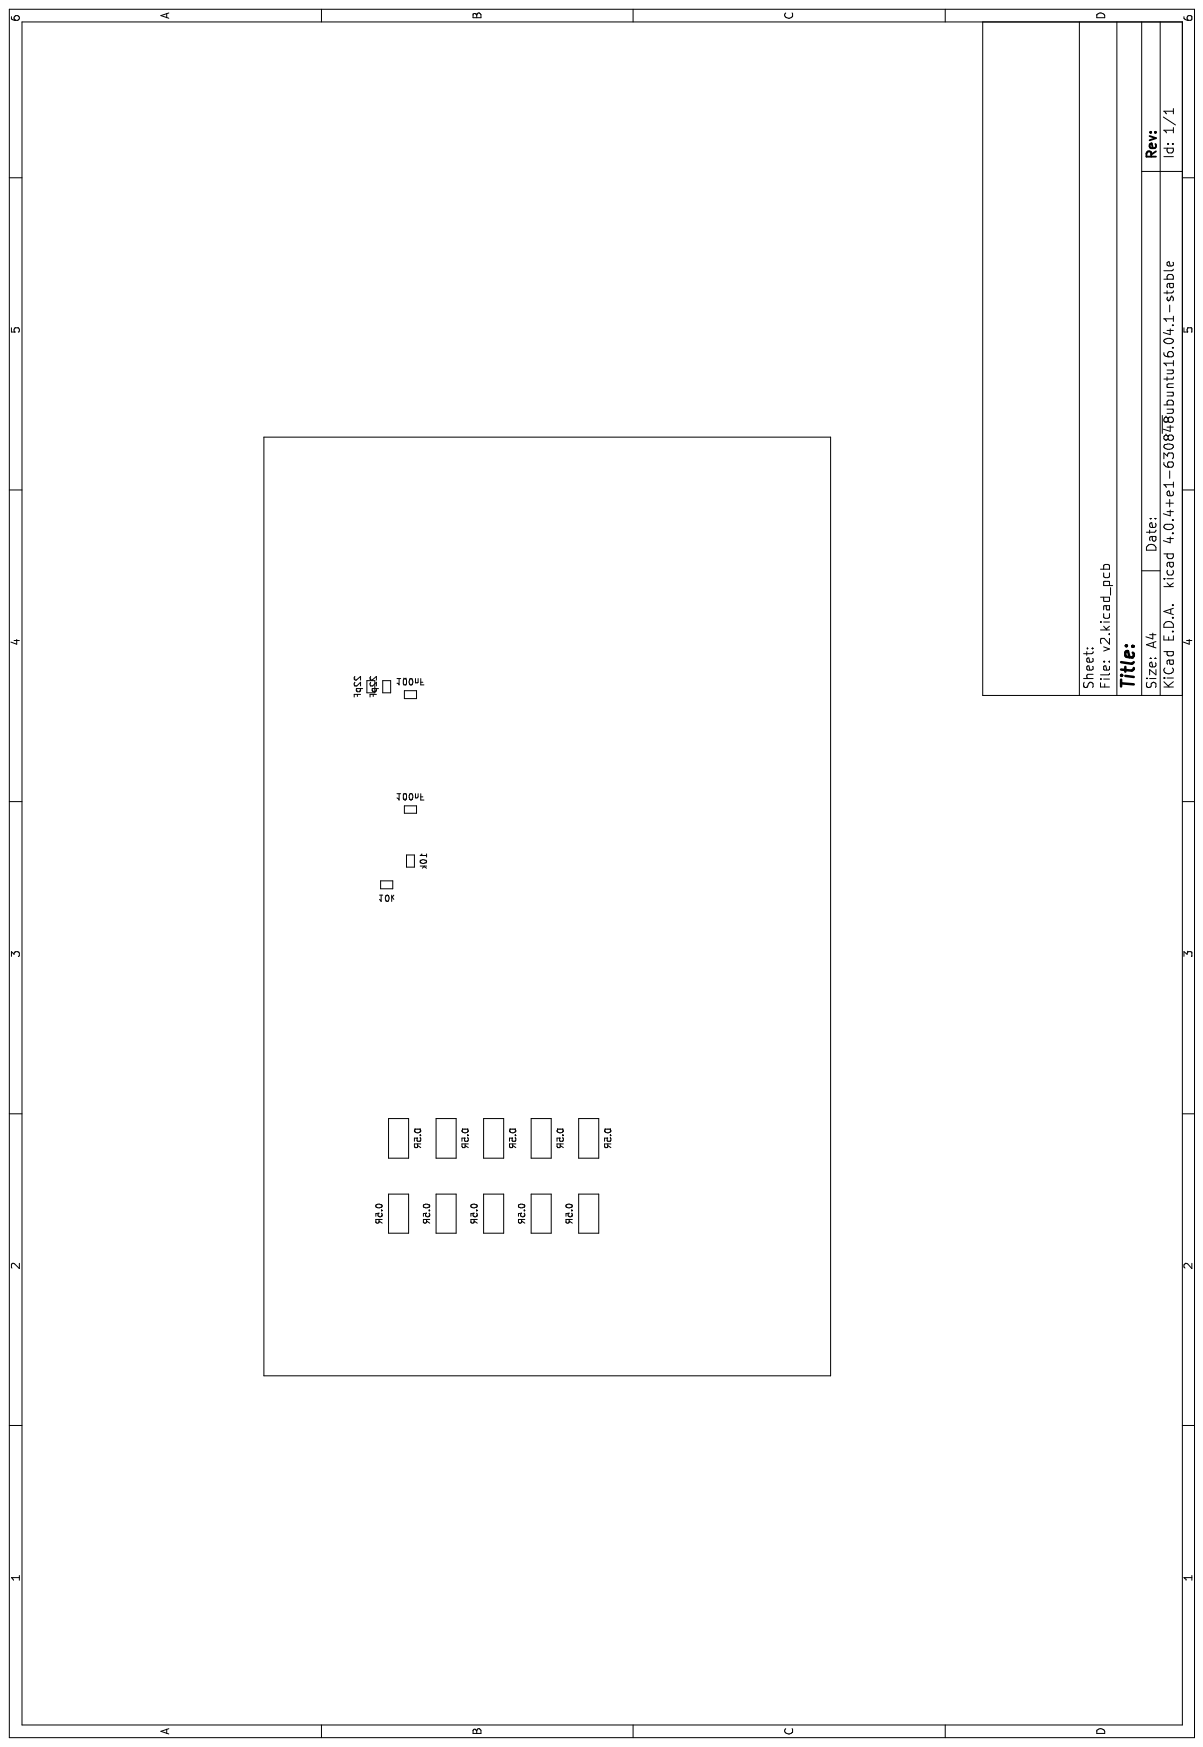
[picture p242: page 2]
