sangseu/kicad/project/charger v2/v1.kicad_pcb

## KiCad design project/charger v2/v1.kicad_pcb (2017-05-30)

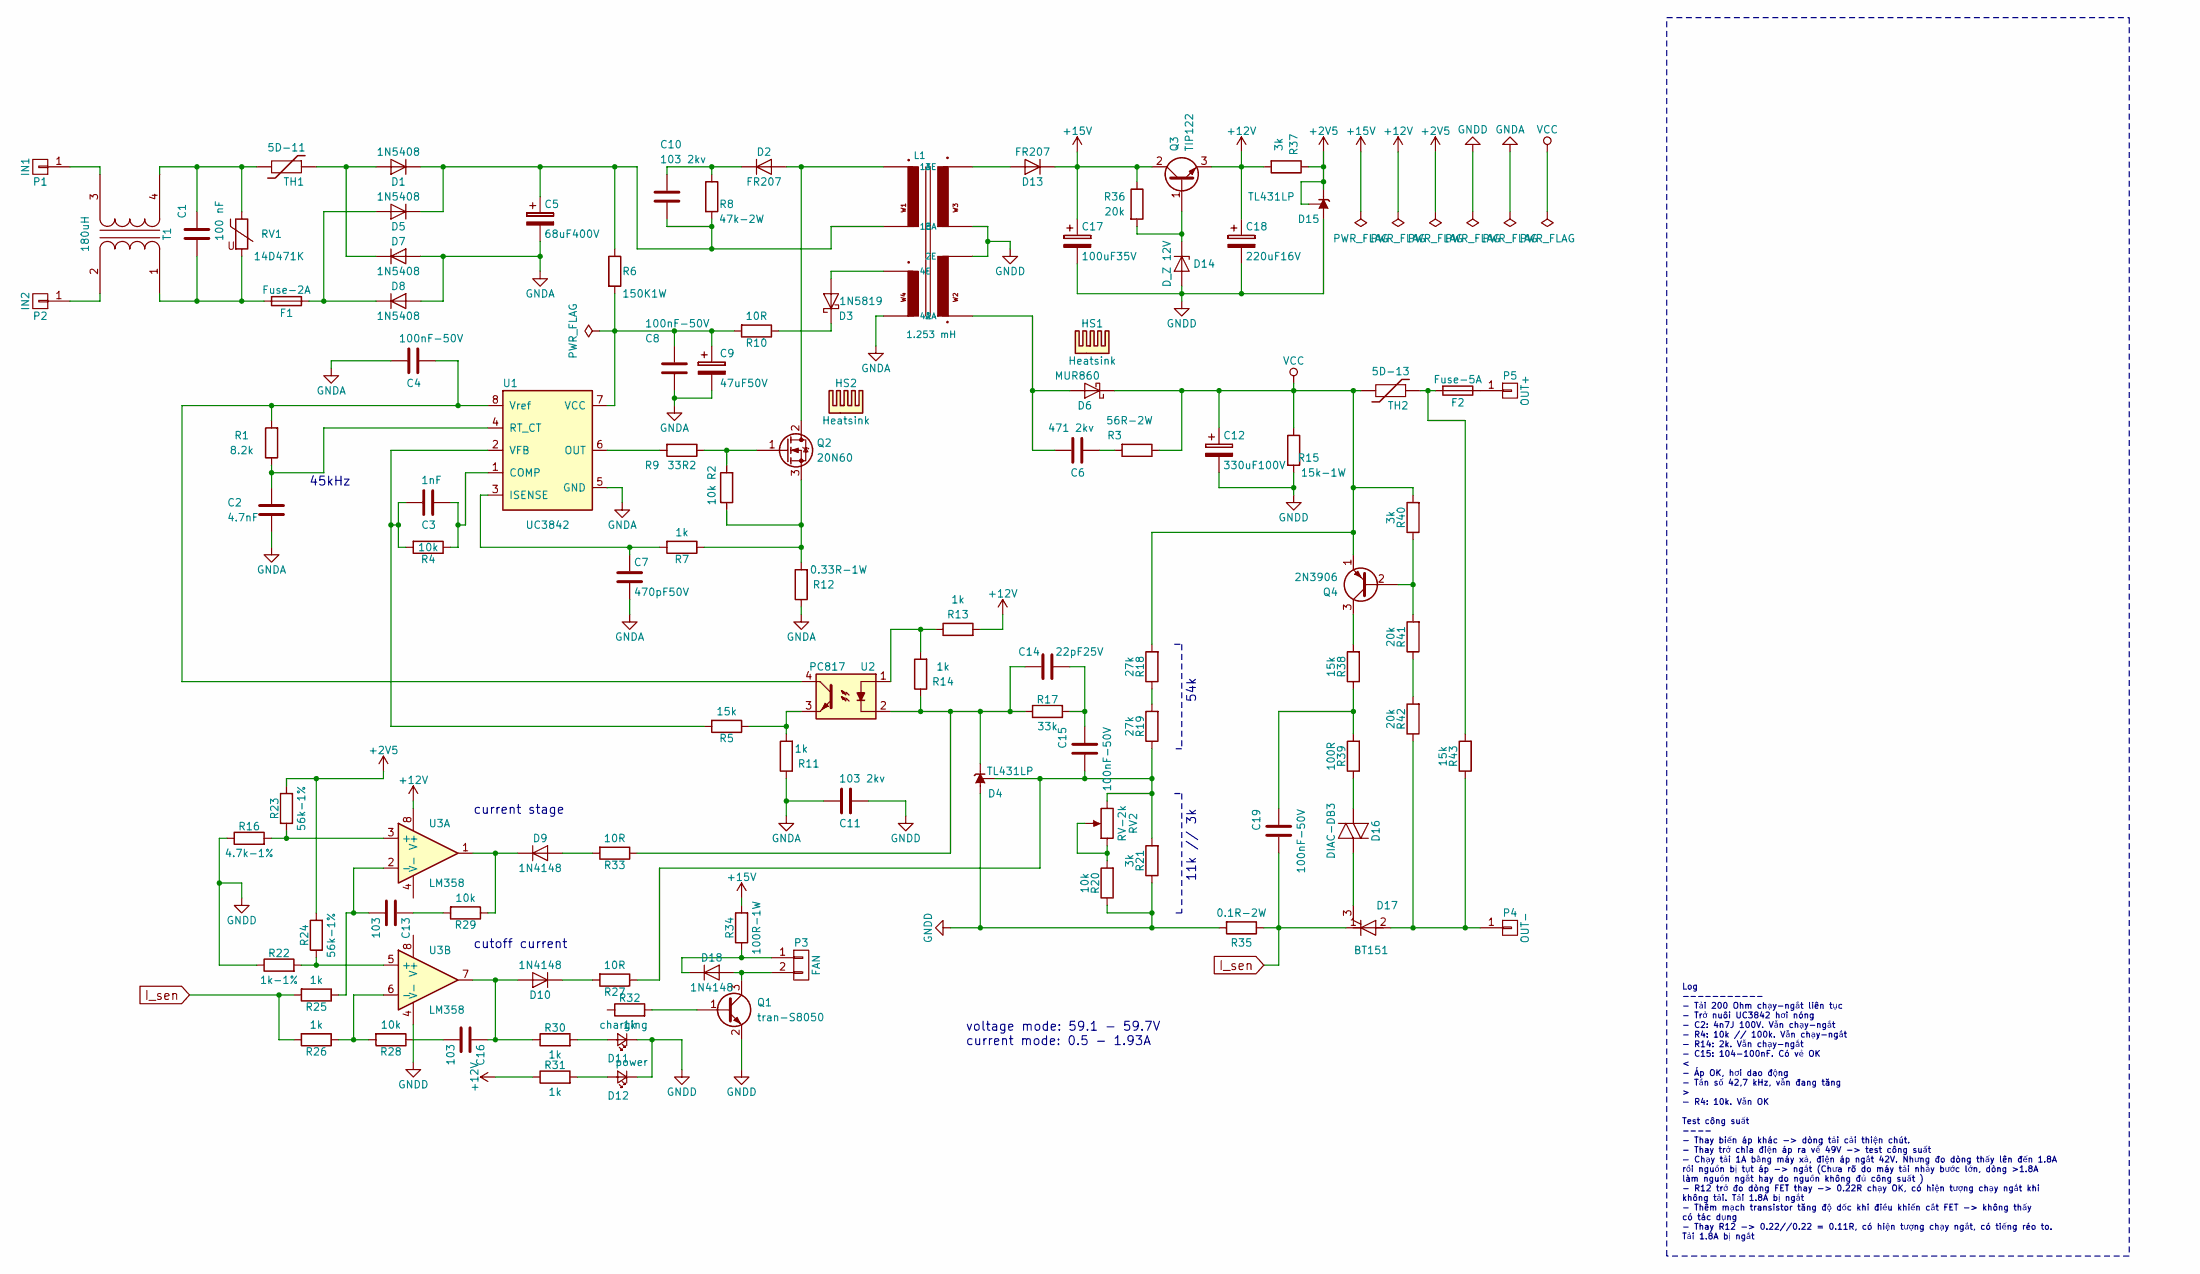
[picture p243: schematic v1.sch, 48V12Ah]

Parts:
C1: 100 nF; RV_Disc_D12_W4_P7.5
C2: 4.7nF; C_Rect_L7_W2.5_P5
C3: 1nF; C_0805_HandSoldering
C4, C8, C15, C19: 100nF-50V; C_Rect_L7_W2.5_P5
C5: 68uF400V; C_Radial_D18_L36_P7.5
C6: 471 2kv; C_Rect_L7_W2.5_P5
C7: 470pF50V; C_Rect_L7_W2.5_P5
C9: 47uF50V; C_Radial_D6.3_L11.2_P2.5
C10, C11: 103 2kv; C_Disc_D12_P7.75
C12: 330uF100V; C_Radial_D10_L21_P5
C13, C16: 103; C_Rect_L7_W2.5_P5
C14: 22pF25V; C_0805_HandSoldering
C17: 100uF35V; C_Radial_D6.3_L11.2_P2.5
C18: 220uF16V; C_Radial_D6.3_L11.2_P2.5
D1, D5, D7, D8: 1N5408; Diode_DO-201AD_Horizontal_RM15
D2, D13: FR207; Diode_DO-41_SOD81_Horizontal_RM10
D3: 1N5819; Diode_DO-41_SOD81_Horizontal_RM10
D4, D15: TL431LP; TO-92_Inline_Wide
D6: MUR860; Diode_TO-220_Vertical
D9, D10: 1N4148; Diode_DO-41_SOD81_Horizontal_RM10
D11: charging; LED-5MM
D12: power; LED-5MM
D14: D_Z 12V; Diode_DO-35_SOD27_Horizontal_RM10
D16: DIAC-DB3; Diode_DO-35_SOD27_Horizontal_RM10
D17: BT151; Diode_TO-220_Dual_CommonCathode_Vertical
D18: 1N4148; Diode_DO-41_SOD81_Vertical_AnodeUp
F1: Fuse-2A; Fuseholder5x20_horiz_open_inline_Type-I
F2: Fuse-5A; Fuseholder5x20_horiz_open_inline_Type-I
HS1, HS2: Heatsink; heatsink-D03PA
L1: 1.253 mH; trafo-siemens-RM8-12A
P1: IN1; MountingHole_2.2mm_M2_DIN965_Pad
P2: IN2; MountingHole_2.2mm_M2_DIN965_Pad
P3: FAN; Molex_KK-6410-02_02x2.54mm_Straight
P4: OUT-; MountingHole_2.2mm_M2_DIN965_Pad
P5: OUT+; MountingHole_2.2mm_M2_DIN965_Pad
Q1: tran-S8050; SOT-23
Q2: 20N60; TO-220_Neutral123_Vertical_LargePads
Q3: TIP122; TO-220_Neutral123_Vertical
Q4: 2N3906; TO-92_Inline_Wide
R1: 8.2k; R_0805_HandSoldering
R2, R4, R20, R28, R29: 10k; R_0805_HandSoldering
R3: 56R-2W; Resistor_Horizontal_RM15mm
R5: 15k; R_0805_HandSoldering
R6: 150K1W; Resistor_Horizontal_RM15mm
R7, R13, R25, R26, R30, R31, R32: 1k; Resistor_Horizontal_RM7mm
R8: 47k-2W; Resistor_Horizontal_RM15mm
R9: 33R2; Resistor_Horizontal_RM7mm
R10, R27, R33: 10R; R_0805_HandSoldering
R11, R14: 1k; R_0805_HandSoldering
R12: 0.33R-1W; Resistor_Horizontal_RM15mm
R15: 15k-1W; Resistor_Horizontal_RM15mm
R16: 4.7k-1%; R_0805_HandSoldering
R17: 33k; R_0805_HandSoldering
R18, R19: 27k; Resistor_Horizontal_RM7mm
R21, R40: 3k; R_0805_HandSoldering
R22: 1k-1%; Resistor_Horizontal_RM7mm
R23, R24: 56k-1%; Resistor_Horizontal_RM7mm
R34: 100R-1W; Resistor_Horizontal_RM10mm
R35: 0.1R-2W; Resistor_Horizontal_RM20mm
R36, R41: 20k; R_0805_HandSoldering
R37: 3k; Resistor_Horizontal_RM7mm
R38, R43: 15k; Resistor_Horizontal_RM7mm
R39: 100R; R_0805_HandSoldering
R42: 20k; Resistor_Horizontal_RM7mm
RV1: 14D471K; RV_Disc_D12_W3.9_P7.5
RV2: RV-2k; Potentiometer_Bourns_3296W_3-8Zoll_Inline_ScrewUp
T1: 180uH; inductors-MFE
TH1: 5D-11; R3
TH2: 5D-13; R3
U1: UC3842; DIP-8_W7.62mm_LongPads
U2: PC817; DIP-4_W7.62mm
U3: LM358; DIP-8_W7.62mm_LongPads

Connections:
+2V5: D15.1 (REF), D15.3 (K), R23.2, R24.2, R37.1
+12V: C18.1, Q3.3 (E), R13.2, R31.1, R37.2, U3.8 (V+)
+15V: C17.1, D13.1 (K), Q3.2 (C), R34.2, R36.1
GNDA: C2.2, C4.2, C5.2, C7.2, C8.2, C9.2, C11.2, D7.2 (A), D8.2 (A), L1.6 (4A), R11.1, R12.1, U1.5 (GND)
GNDD: C11.1, C12.2, C17.2, C18.2, D4.2 (A), D11.1 (K), D12.1 (K), D14.2 (A), D15.2 (A), L1.10 (2E), Q1.2 (E), R15.2, R16.1, R20.1, R21.1, R22.1, R35.2, U3.4 (V-)
I_sen: C19.1, D17.1 (K), R25.2, R26.2, R35.1
unnamed: C1.1, RV1.1, T1.4 (SB), TH1.2
unnamed: C1.2, F1.2, RV1.2, T1.1 (AA)
unnamed: C2.1, R1.1, U1.4 (RT_CT)
unnamed: C3.1, R4.1, U1.1 (COMP)
unnamed: C3.2, R4.2, R5.2, U1.2 (VFB)
unnamed: C4.1, R1.2, U1.8 (Vref), U2.4
unnamed: C6.1, R3.2
unnamed: C6.2, D6.2 (A), L1.8 (2A)
unnamed: C7.1, R7.2, U1.3 (ISENSE)
unnamed: C8.1, C9.1, R6.2, R10.2, U1.7 (VCC)
unnamed: C10.1, D2.1 (K), R8.1
unnamed: C5.1, C10.2, D1.1 (K), D5.1 (K), L1.3 (1E), R6.1, R8.2
unnamed: C13.1, R29.2
unnamed: C13.2, R25.1, U3.2 (-)
unnamed: C14.1, C15.2, R17.2
unnamed: C16.2, R28.1
unnamed: C19.2, R38.1, R39.2
unnamed: D1.2 (A), D7.1 (K), TH1.1
unnamed: D2.2 (A), L1.1 (1A), Q2.2 (D)
unnamed: D3.1 (K), R10.1
unnamed: D3.2 (A), L1.5 (4E)
unnamed: D5.2 (A), D8.1 (K), F1.1
unnamed: D9.1 (K), R29.1, U3.1
unnamed: D9.2 (A), R33.2
unnamed: D11.2 (A), R30.2
unnamed: D12.2 (A), R31.2
unnamed: D13.2 (A), L1.12 (3E)
unnamed: D14.1 (K), Q3.1 (B), R36.2
unnamed: D16.1 (K), R39.1
unnamed: D16.2 (A), D17.3 (G)
unnamed: D17.2 (A), P4.1, R42.1, R43.1
unnamed: D18.1 (K), P3.1, R34.1
unnamed: D18.2 (A), P3.2, Q1.3 (C)
unnamed: F2.1, P5.1
unnamed: F2.2, R43.2, TH2.1
unnamed: P1.1, T1.3 (SA)
unnamed: P2.1, T1.2 (AB)
unnamed: Q1.1 (B), R32.2
unnamed: Q2.1 (G), R2.2, R9.1
unnamed: Q2.3 (S), R2.1, R7.1, R12.2
unnamed: Q4.2 (B), R40.1, R41.2
unnamed: Q4.3 (C), R38.2
unnamed: R9.2, U1.6 (OUT)
unnamed: R5.1, R11.2, U2.3
unnamed: R13.1, R14.2, U2.1
unnamed: R16.2, R23.1, U3.3 (+)
unnamed: R18.1, R19.2
unnamed: R20.2, RV2.1, RV2.2
unnamed: R22.2, R24.1, U3.5 (+)
unnamed: R26.1, R28.2, U3.6 (-)
unnamed: R41.1, R42.2
VCC: C12.1, D6.1 (K), Q4.1 (E), R3.1, R15.1, R18.2, R40.2, TH2.2

Notes on the sheet:
voltage mode: 59.1 - 59.7V current mode: 0.5 - 1.93A
45kHz
current stage
cutoff current
54k
11k // 3k
Log ----------- - Tải 200 Ohm chạy-ngắt liên tục - Trở nuôi UC3842 hơi nóng - C2: 4n7J 100V. Vẫn chạy-ngắt - R4: 10k // 100k. Vẫn chạy-ngắt - R14: 2k. Vẫn chạy-ngắt - C15: 104-100nF. Có vẻ OK < - Áp OK, hơi dao động - Tần số 42,7 kHz, vẫn đang tăng > - R4: 10k. Vẫn OK Test công suất ---- - Thay biế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
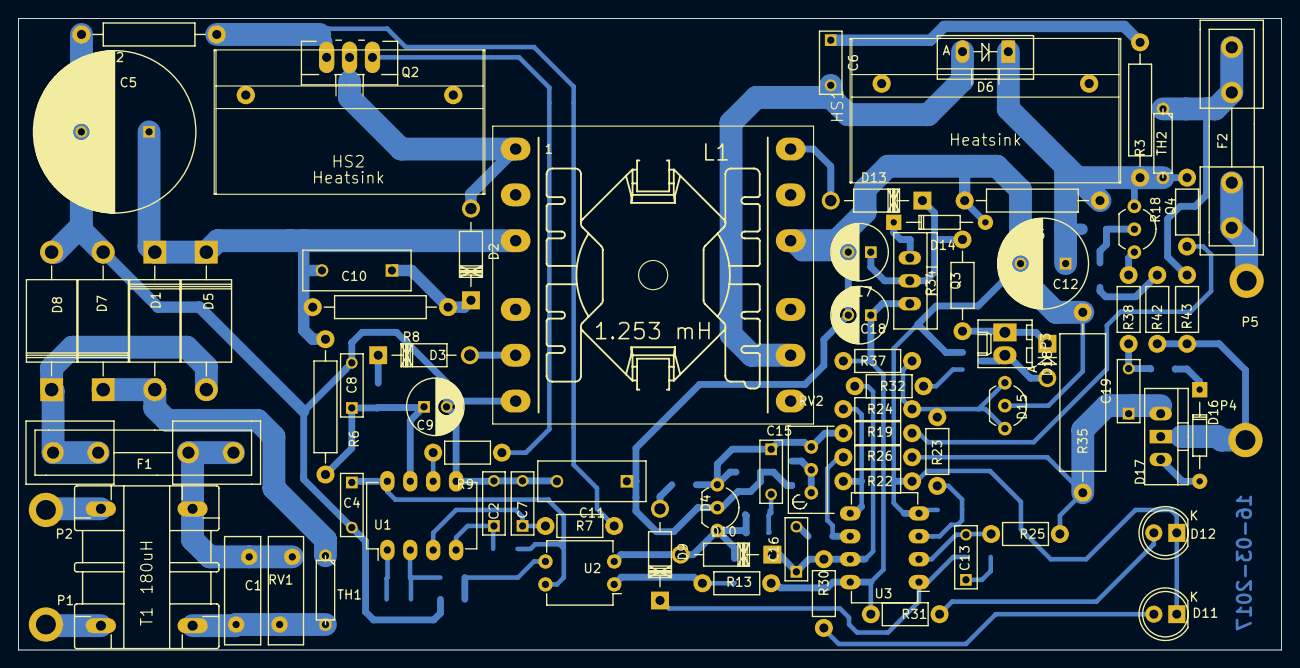
[picture p244: board project/charger v2/v1.kicad_pcb from above]

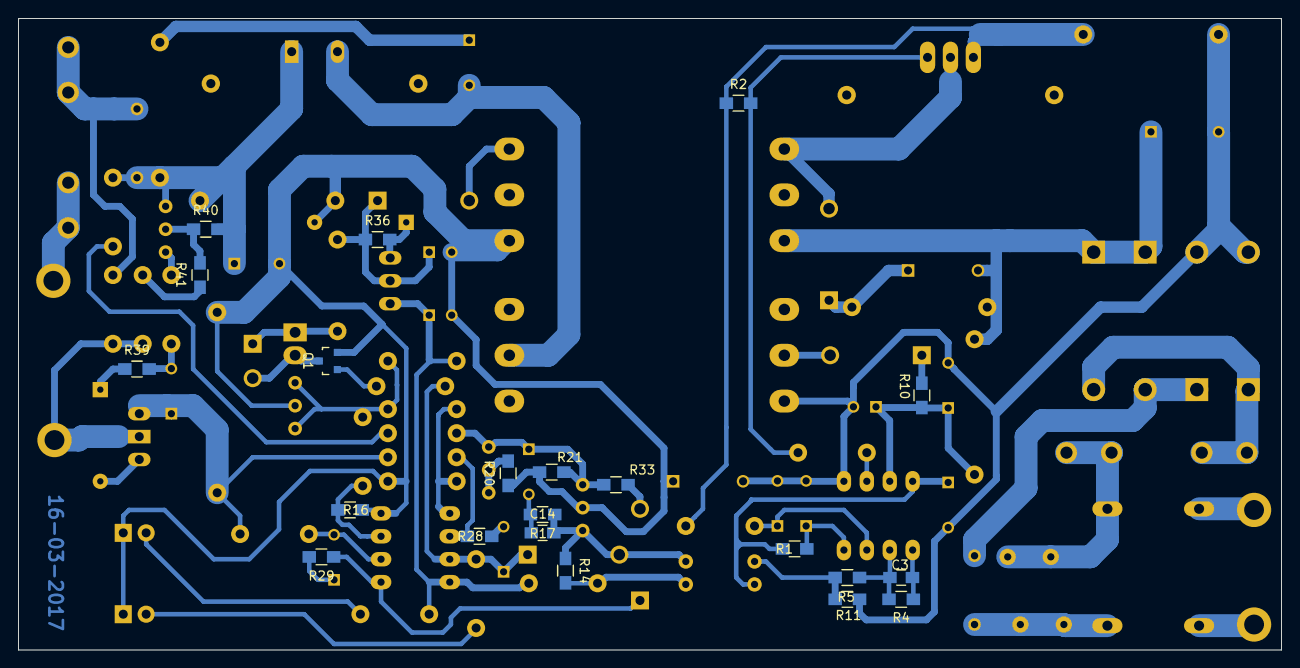
[picture p245: board project/charger v2/v1.kicad_pcb from below]

Board: 2 copper layers, 140.0 x 70.0 mm, 101 parts (21 on the bottom side), 61 nets.
