sangseu/kicad/project/load_v3/v3.kicad_pcb

## KiCad design project/load_v3/v3.kicad_pcb (2017-01-09)

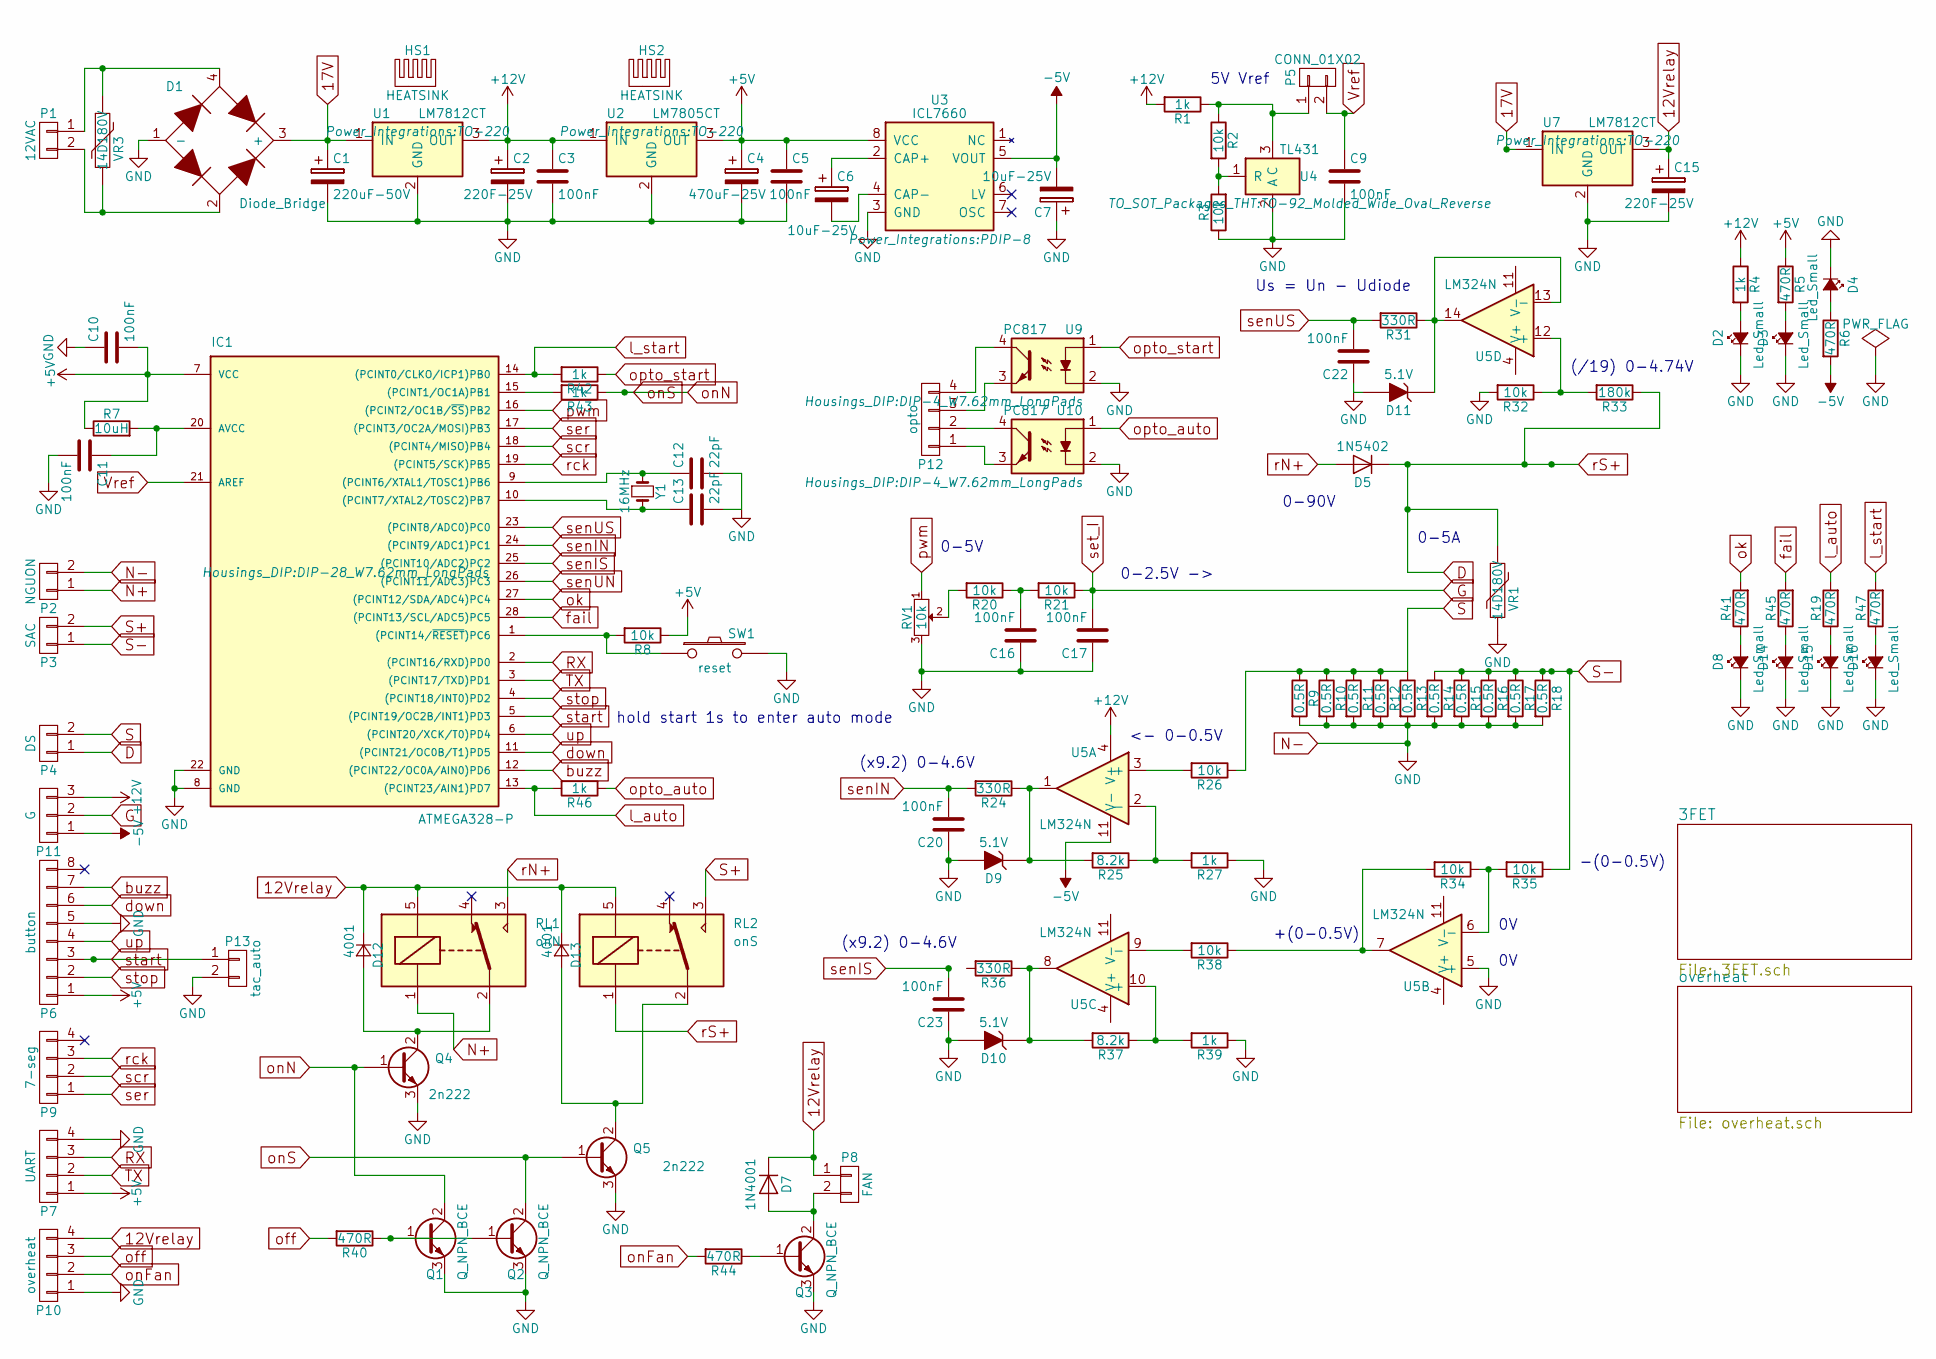
[picture p246: schematic v3.sch]

Parts:
C1: 220uF-50V; C_Radial_D8_L11.5_P3.5
C2, C15: 220F-25V; C_Radial_D5_L6_P2.5
C3, C5, C16, C17, C20, C22, C23: 100nF; C_Disc_D3_P2.5
C4: 470uF-25V; C_Radial_D5_L6_P2.5
C6, C7: 10uF-25V; C_Radial_D5_L6_P2.5
C9, C10: 100nF; C_0805_HandSoldering
C11: 100nF; C_Rect_L7_W2.5_P5
C12, C13: 22pF; C_0805_HandSoldering
D1: Diode_Bridge; Diode_Bridge_KBP206
D2, D3, D4, D8, D14, D15, D16: Led_Small; LED-3MM
D5: 1N5402; Diode_DO-201AD_Horizontal_RM15
D7: 1N4001; Diode_DO-35_SOD27_Horizontal_RM10
D9, D10, D11: 5.1V; Diode_DO-35_SOD27_Horizontal_RM10
D12, D13: 4001; Diode_DO-35_SOD27_Horizontal_RM10
HS1, HS2: HEATSINK; Heatsink_Stonecold_HS-132_32x14mm_2xFixation1.5mm
IC1: ATMEGA328-P; DIP-28_W7.62mm_LongPads
P1: 12VAC; PhoenixContact_MCV-G_02x5.08mm_Vertical
P2: NGUON; PhoenixContact_MCV-G_02x5.08mm_Vertical
P3: SAC; PhoenixContact_MCV-G_02x5.08mm_Vertical
P4: DS; PhoenixContact_MCV-G_02x5.08mm_Vertical
P5: CONN_01X02; Pin_Header_Straight_1x02
P6: button; XH2.54-8P
P7: UART; Pin_Header_Straight_1x04
P8: FAN; XH2.54-2P
P9: 7-seg; XH2.54-4P
P10: overheat; XH2.54-4P
P11: G; XH2.54-3P
P12: opto; XH2.54-4P
P13: tac_auto; XH2.54-2P
Q1, Q2, Q3: Q_NPN_BCE; TO-92_Molded_Wide_Oval_Reverse
Q4, Q5: 2n222; TO-92_Molded_Wide_Oval_Reverse
R1, R27, R39, R42, R43, R46: 1k; Resistor_Horizontal_RM7mm
R2, R3: 10k; R_0805_HandSoldering
R4: 1k; R_0805_HandSoldering
R5, R19, R41, R45, R47: 470R; R_0805_HandSoldering
R6, R40, R44: 470R; Resistor_Horizontal_RM7mm
R7: 10uH; Resistor_Horizontal_RM7mm
R8, R20, R21, R26, R32, R34, R35, R38: 10k; Resistor_Horizontal_RM7mm
R9, R10, R11, R12, R13, R14, R15, R16, R17, R18: 0.5R; R_2512_HandSoldering
R24, R31, R36: 330R; Resistor_Horizontal_RM7mm
R25, R37: 8.2k; Resistor_Horizontal_RM7mm
R33: 180k; Resistor_Horizontal_RM7mm
RL1: onN; Relay_SANYOU_SRD_Series_Form_C
RL2: onS; Relay_SANYOU_SRD_Series_Form_C
RV1: 10k; Potentiometer_Bourns_3296W_3-8Zoll_Inline_ScrewUp
SW1: reset; SW_PUSH_6mm
U1, U7: LM7812CT; TO-220
U2: LM7805CT; TO-220
U3: ICL7660; PDIP-8
U4: TL431; TO-92_Molded_Wide_Oval_Reverse
U5: LM324N; DIP-14_W7.62mm_LongPads
U9, U10: PC817; DIP-4_W7.62mm_LongPads
VR1, VR3: 14D180V; RV_Disc_D15.5_W3.9_P7.5
Y1: 16MHz; Crystal_HC50-U_Vertical

Connections:
12Vrelay: C15.1, D7.1 (K), D12.1 (K), D13.1 (K), P8.1, P10.4, RL1.5, RL2.5, U7.3 (OUT); also elsewhere on the board
17V: C1.1, D1.3 (+), U1.1 (IN), U7.1 (IN)
+5V: C4.1, C5.1, C10.2, IC1.7 (VCC), P6.1, P7.1, R5.1, R7.1, R8.1, U2.3 (OUT), U3.8 (VCC)
+12V: C2.1, C3.1, P11.3, R1.2, R4.1, U1.3 (OUT), U2.1 (IN), U5.4 (V+); also elsewhere on the board
-5V: C7.2, P11.1, R6.2, U3.5 (VOUT), U5.11 (V-); also elsewhere on the board
D: D5.1 (K), P4.1, R33.1, RL2.1, VR1.1; also elsewhere on the board
G: C17.2, P11.2, R21.1; also elsewhere on the board
N+: P2.1, RL1.1
N-: C1.2, C2.2, C3.2, C4.2, C5.2, C7.1, C9.2, C10.1, C11.2, C12.2, C13.2, C15.2, C16.1, C17.1, C20.1, C22.1, C23.1, D1.1 (-), D2.1 (K), D3.1 (K), D4.1 (K), D8.1 (K), D9.2 (A), D10.2 (A), D11.2 (A), D14.1 (K), D15.1 (K), D16.1 (K), IC1.8 (GND), IC1.22 (GND), P2.2, P6.5, P7.4, P10.1, P13.2, Q1.3 (E), Q2.3 (E), Q3.3 (E), Q4.3 (E), Q5.3 (E), R3.1, R9.2, R10.2, R11.2, R12.2, R13.2, R14.2, R15.2, R16.2, R17.2, R18.2, R27.1, R32.2, R39.1, RV1.3, SW1.2, U1.2 (GND), U2.2 (GND), U3.3 (GND), U4.2 (A), U5.5 (+), U7.2 (GND), U9.2, U10.2, VR1.2; also elsewhere on the board
unnamed: C6.1, U3.2 (CAP+)
unnamed: C6.2, U3.4 (CAP-)
unnamed: C11.1, IC1.20 (AVCC), R7.2
unnamed: C12.1, IC1.9 ((PCINT6/XTAL1/TOSC1)PB6), Y1.1
unnamed: C13.1, IC1.10 ((PCINT7/XTAL2/TOSC2)PB7), Y1.2
unnamed: C16.2, R20.1, R21.2
unnamed: D1.2, P1.2, VR3.2
unnamed: D1.4, P1.1, VR3.1
unnamed: D2.2 (A), R4.2
unnamed: D3.2 (A), R5.2
unnamed: D4.2 (A), R6.1
unnamed: D7.2 (A), P8.2, Q3.2 (C)
unnamed: D8.2 (A), R41.1
unnamed: D9.1 (K), R24.1, R25.2, U5.1
unnamed: D10.1 (K), R36.1, R37.2, U5.8
unnamed: D11.1 (K), R31.1, U5.13 (-), U5.14
unnamed: D12.2 (A), Q4.2 (C), RL1.2
unnamed: D13.2 (A), Q5.2 (C), RL2.2
unnamed: D14.2 (A), R45.1
unnamed: D15.2 (A), R19.1
unnamed: D16.2 (A), R47.1
unnamed: IC1.1 ((PCINT14/~RESET~)PC6), R8.2, SW1.1
unnamed: IC1.15 ((PCINT1/OC1A)PB1), R43.2
unnamed: P5.1, R1.1, R2.1, U4.3 (C)
unnamed: P12.1, U10.3
unnamed: P12.2, U10.4
unnamed: P12.3, U9.3
unnamed: P12.4, U9.4
unnamed: Q1.1 (B), Q2.1 (B), R40.1
unnamed: Q3.1 (B), R44.1
unnamed: R2.2, R3.2, U4.1 (R)
unnamed: R20.2, RV1.2
unnamed: R25.1, R27.2, U5.2 (-)
unnamed: R26.2, U5.3 (+)
unnamed: R32.1, R33.2, U5.12 (+)
unnamed: R34.1, R35.2, U5.6 (-)
unnamed: R34.2, R38.1, U5.7
unnamed: R37.1, R39.2, U5.10 (+)
unnamed: R38.2, U5.9 (-)
RX: IC1.2 ((PCINT16/RXD)PD0), P7.3
S: P4.2, R9.1, R10.1, R11.1, R12.1, R13.1, R26.1; also elsewhere on the board
S+: P3.2, RL2.3
S-: P3.1, R14.1, R15.1, R16.1, R17.1, R18.1, R35.1
TX: IC1.3 ((PCINT17/TXD)PD1), P7.2
Vref: C9.1, IC1.21 (AREF), P5.2
buzz: IC1.12 ((PCINT22/OC0A/AIN0)PD6), P6.7
down: IC1.11 ((PCINT21/OC0B/T1)PD5), P6.6
fail: IC1.28 ((PCINT13/SCL/ADC5)PC5), R45.2
l_auto: IC1.13 ((PCINT23/AIN1)PD7), R19.2, R46.2
l_start: IC1.14 ((PCINT0/CLKO/ICP1)PB0), R42.2, R47.2
off: P10.3, R40.2; also elsewhere on the board
ok: IC1.27 ((PCINT12/SDA/ADC4)PC4), R41.2
onFan: P10.2, R44.2; also elsewhere on the board
onN: Q1.2 (C), Q2.2 (C), Q4.1 (B), Q5.1 (B), R43.1
opto_auto: R46.1, U10.1
opto_start: R42.1, U9.1
pwm: IC1.16 ((PCINT2/OC1B/~SS~)PB2), RV1.1
rN+: D5.2 (A), RL1.3
rck: IC1.19 ((PCINT5/SCK)PB5), P9.3
scr: IC1.18 ((PCINT4/MISO)PB4), P9.2
senIN: C20.2, IC1.24 ((PCINT9/ADC1)PC1), R24.2
senIS: C23.2, IC1.25 ((PCINT10/ADC2)PC2)
senUS: C22.2, IC1.23 ((PCINT8/ADC0)PC0), R31.2
ser: IC1.17 ((PCINT3/OC2A/MOSI)PB3), P9.1
start: IC1.5 ((PCINT19/OC2B/INT1)PD3), P6.3, P13.1
stop: IC1.4 ((PCINT18/INT0)PD2), P6.2
up: IC1.6 ((PCINT20/XCK/T0)PD4), P6.4

Notes on the sheet:
0-90V
0-5A
<- 0-0.5V
0-5V
0-2.5V ->
(x9.2) 0-4.6V
(/19) 0-4.74V
-(0-0.5V)
+(0-0.5V)
5V Vref
hold start 1s to enter auto mode
Us = Un - Udiode

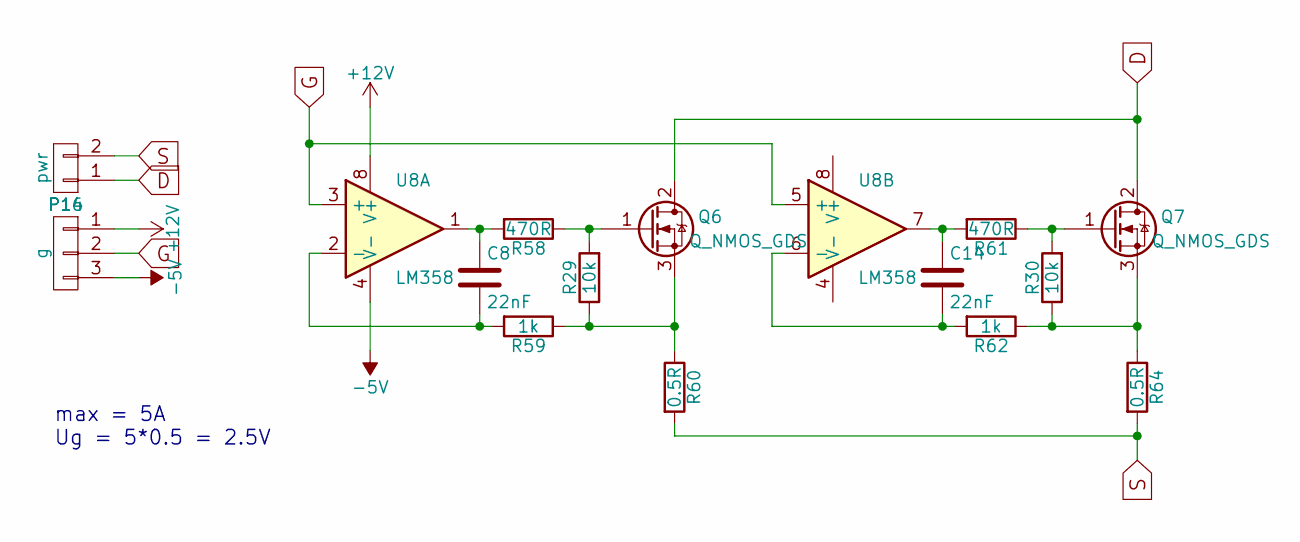
[picture p247: schematic 3FET.sch]

Parts:
C8, C14: 22nF; C_Disc_D3_P2.5
P14: pwr; PhoenixContact_MCV-G_02x5.08mm_Vertical
P16: g; XH2.54-3P
Q6, Q7: Q_NMOS_GDS; TO-247_Vertical_Neutral123
R29, R30: 10k; Resistor_Horizontal_RM7mm
R58, R61: 470R; Resistor_Horizontal_RM7mm
R59, R62: 1k; Resistor_Horizontal_RM7mm
R60, R64: 0.5R; Resistor_Vertical_RM7.5mm
U8: LM358; DIP-8_W7.62mm_LongPads

Connections:
+12V: P16.1, U8.8 (V+); also elsewhere on the board
-5V: P16.3, U8.4 (V-); also elsewhere on the board
D: P14.1, Q6.2 (D), Q7.2 (D); also elsewhere on the board
G: P16.2, U8.3 (+), U8.5 (+); also elsewhere on the board
unnamed: C8.1, R58.2, U8.1
unnamed: C8.2, R59.2, U8.2 (-)
unnamed: C14.1, R61.2, U8.7
unnamed: C14.2, R62.2, U8.6 (-)
unnamed: Q6.1 (G), R29.2, R58.1
unnamed: Q6.3 (S), R29.1, R59.1, R60.1
unnamed: Q7.1 (G), R30.2, R61.1
unnamed: Q7.3 (S), R30.1, R62.1, R64.1
S: P14.2, R60.2, R64.2; also elsewhere on the board

Notes on the sheet:
max = 5A Ug = 5*0.5 = 2.5V

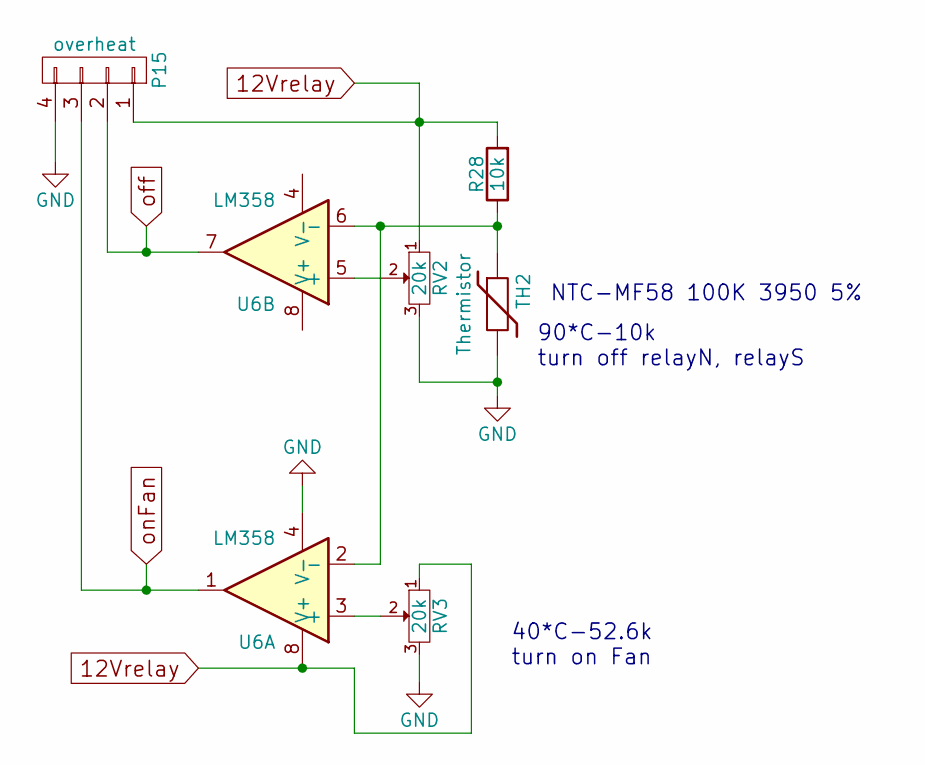
[picture p248: schematic overheat.sch]

Parts:
P15: overheat; XH2.54-4P
R28: 10k; R_0805_HandSoldering
RV2, RV3: 20k; Potentiometer_Triwood_RM-065
TH2: Thermistor; R3
U6: LM358; DIP-8_W7.62mm_LongPads

Connections:
12Vrelay: P15.1, R28.2, RV2.1, RV3.1, U6.8 (V+); also elsewhere on the board
N-: P15.4, RV2.3, RV3.3, TH2.2, U6.4 (V-); also elsewhere on the board
unnamed: R28.1, TH2.1, U6.2 (-), U6.6 (-)
unnamed: RV2.2, U6.5 (+)
unnamed: RV3.2, U6.3 (+)
off: P15.2, U6.7; also elsewhere on the board
onFan: P15.3, U6.1; also elsewhere on the board

Notes on the sheet:
NTC-MF58 100K 3950 5%
90*C-10k turn off relayN, relayS
40*C-52.6k turn on Fan

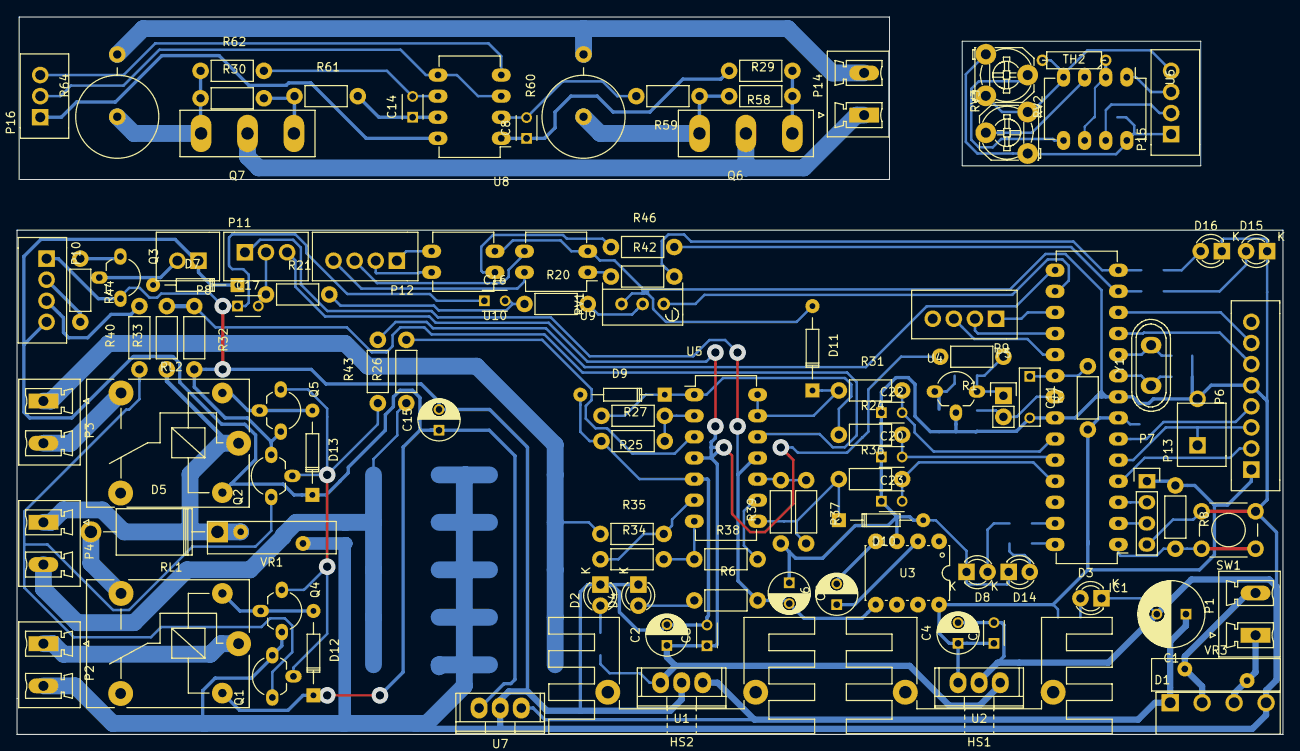
[picture p249: board v3.kicad_pcb from above]

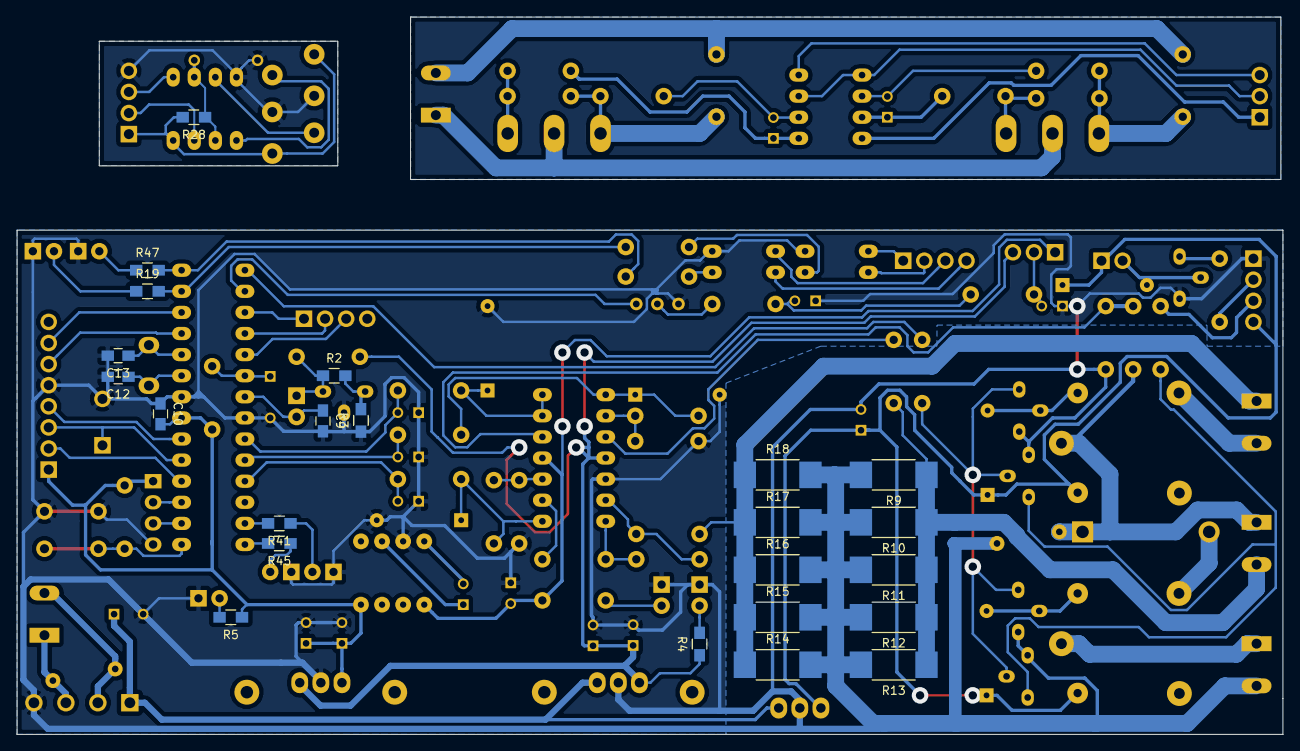
[picture p250: board v3.kicad_pcb from below]

Board: 2 copper layers, 152.4 x 60.7 mm, 132 parts (23 on the bottom side), 87 nets.
