sangseu/kicad/project/48V-3A/v1.kicad_pcb

## KiCad design project/48V-3A/v1.kicad_pcb (2016-11-28)

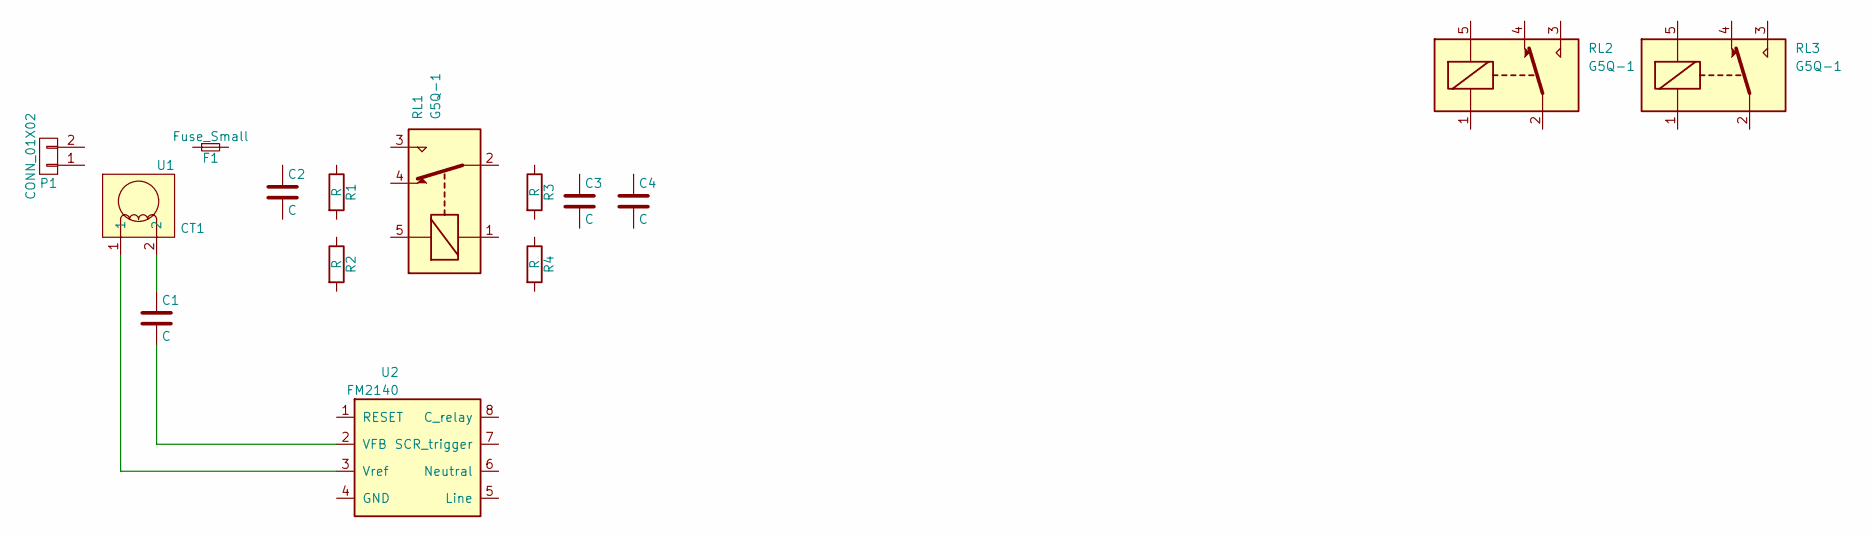
[picture p251: schematic v1.sch]

Parts:
C1: C; C_0805_HandSoldering
C2: C; C_Rect_L13_W6_H12_P10
C3, C4: C; C_Rect_L18_W5_P15
F1: Fuse_Small; CP4
P1: CONN_01X02; bornier2
R1, R2, R3, R4: R; R_0805_HandSoldering
RL1, RL2, RL3: G5Q-1; Relay_SANYOU_SRD_Series_Form_C
U1: CT1
U2: FM2140; SOIC-8_3.9x4.9mm_Pitch1.27mm

Connections:
unnamed: C1.1, U1.2
unnamed: C1.2, U2.2 (VFB)
unnamed: U1.1, U2.3 (Vref)

Board: 2 copper layers, 15 parts (0 on the bottom side), 3 nets, no tracks yet.
