sangseu/kicad/project/begin/begin.kicad_pcb

## KiCad design project/begin/begin.kicad_pcb (2016-11-28)

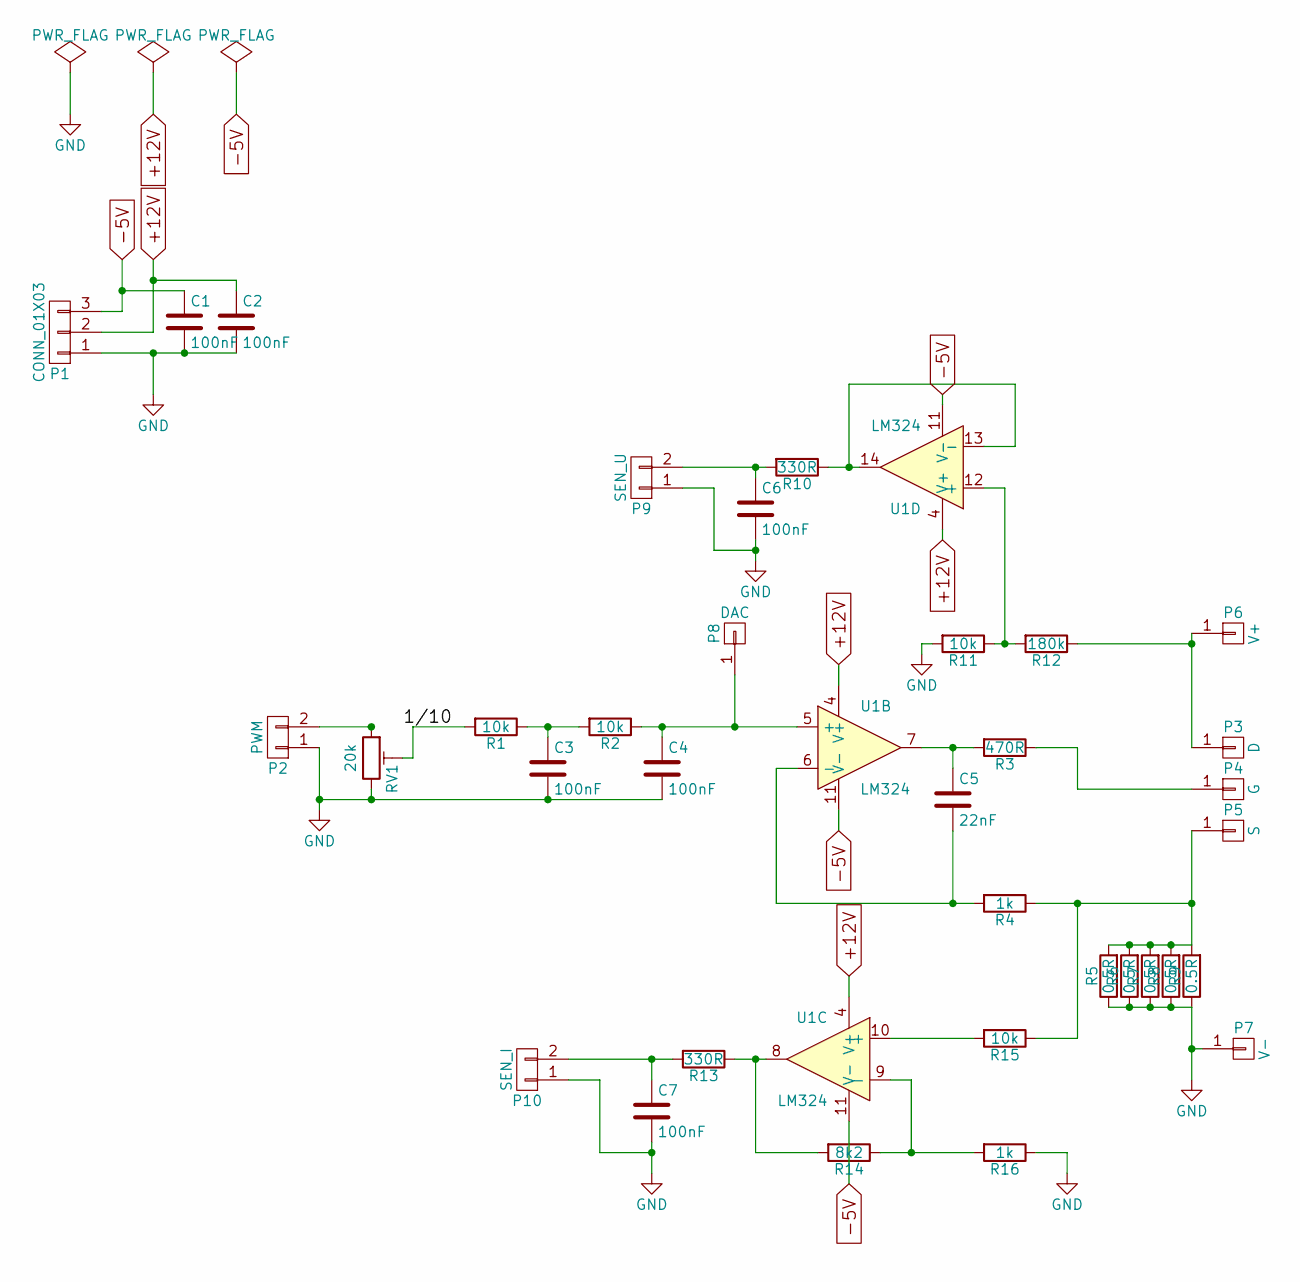
[picture p252: schematic begin.sch]

Parts:
C1: 100nF; C_Rect_L7_W2.5_P5
C2, C3, C4, C6, C7: 100nF; C_Disc_D3_P2.5
C5: 22nF; C_Disc_D3_P2.5
P1: CONN_01X03; Socket_Strip_Straight_1x03
P2: PWM; Socket_Strip_Straight_1x02
P3: D; SolderWirePad_single_2mmDrill
P4: G; SolderWirePad_single_2mmDrill
P5: S; SolderWirePad_single_2mmDrill
P6: V+; SolderWirePad_single_2mmDrill
P7: V-; SolderWirePad_single_2mmDrill
P8: DAC; Pin_Header_Straight_1x01
P9: SEN_U; Socket_Strip_Straight_1x02
P10: SEN_I; Socket_Strip_Straight_1x02
R1, R2, R11, R15: 10k; Resistor_Horizontal_RM7mm
R3: 470R; Resistor_Horizontal_RM7mm
R4, R16: 1k; Resistor_Horizontal_RM7mm
R5, R6, R7, R8, R9: 0.5R; R_2512_HandSoldering
R10, R13: 330R; Resistor_Horizontal_RM7mm
R12: 180k; Resistor_Horizontal_RM7mm
R14: 8k2; Resistor_Horizontal_RM7mm
RV1: 20k; PINHEAD1-3
U1: LM324; DIP-14_W7.62mm_LongPads

Connections:
+12V: C2.1, P1.2, U1.4 (V+)
-5V: C1.1, P1.3, U1.11 (V-)
GND: C1.2, C2.2, C3.2, C4.2, C6.2, C7.2, P1.1, P2.1, P7.1, P9.1, P10.1, R5.1, R6.1, R7.1, R8.1, R9.1, R11.2, R16.1, RV1.3
unnamed: C3.1, R1.1, R2.2
unnamed: C4.1, P8.1, R2.1, U1.5 (+)
unnamed: C5.1, R3.2, U1.7
unnamed: C5.2, R4.2, U1.6 (-)
unnamed: C6.1, P9.2, R10.2
unnamed: C7.1, P10.2, R13.2
unnamed: P2.2, RV1.1
unnamed: P3.1, P6.1, R12.1
unnamed: P4.1, R3.1
unnamed: P5.1, R4.1, R5.2, R6.2, R7.2, R8.2, R9.2, R15.1
unnamed: R1.2, RV1.2
unnamed: R10.1, U1.13 (-), U1.14
unnamed: R11.1, R12.2, U1.12 (+)
unnamed: R13.1, R14.2, U1.8
unnamed: R14.1, R16.2, U1.9 (-)
unnamed: R15.2, U1.10 (+)
