sangseu/kicad/project/begin/begin.kicad_pcb

## KiCad design project/begin/begin.kicad_pcb (continued)

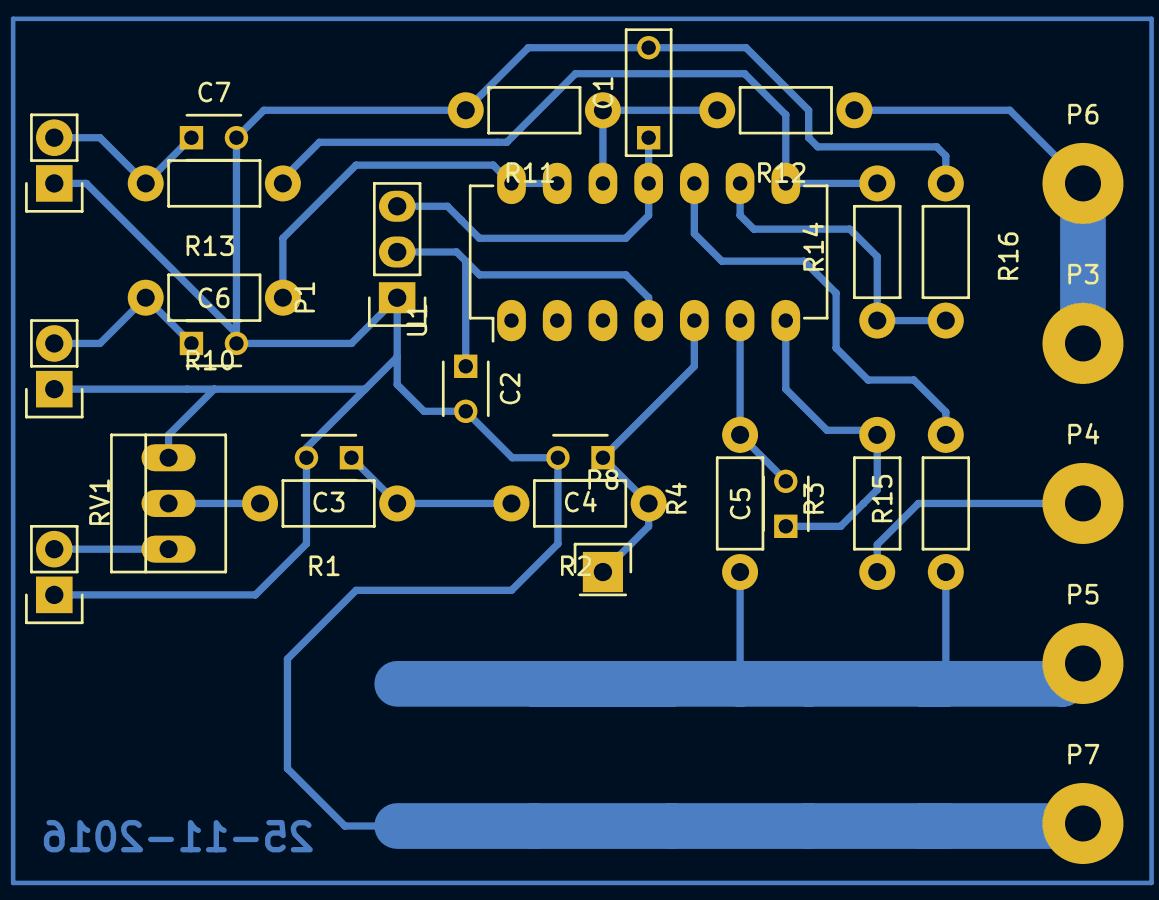
[picture p253: board begin.kicad_pcb from above]

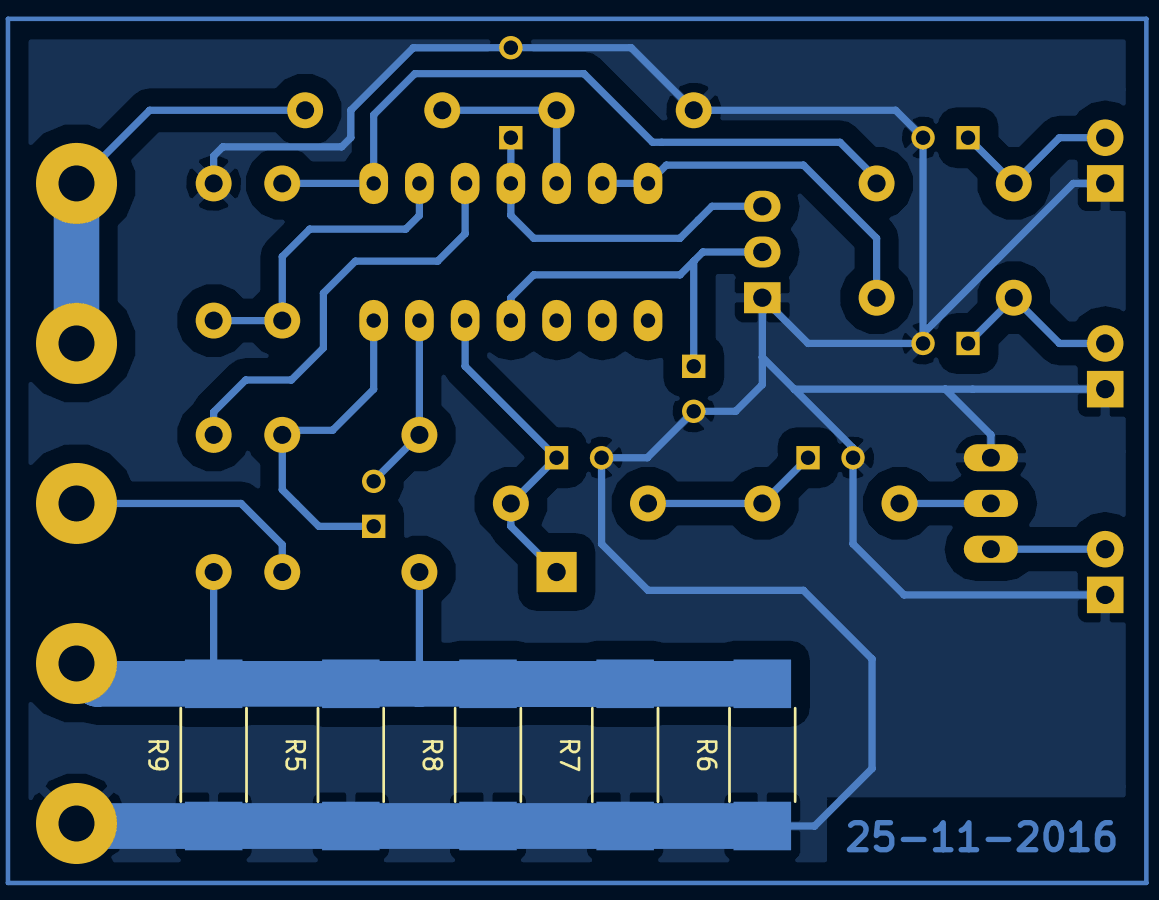
[picture p254: board begin.kicad_pcb from below]

Board: 2 copper layers, 35 parts (5 on the bottom side), 19 nets.
