sangseu/kicad/project/chaser_led/chaser_led.kicad_pcb

## KiCad design project/chaser_led/chaser_led.kicad_pcb (2017-01-03)

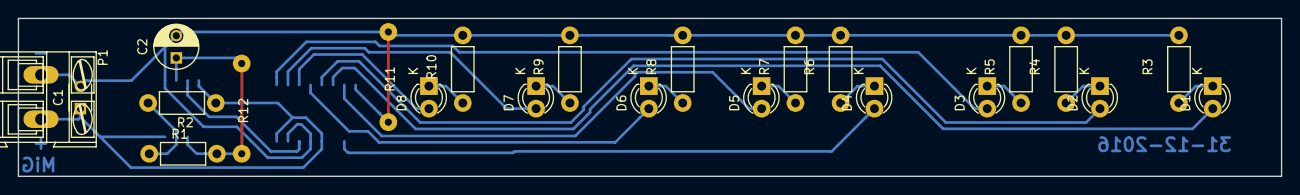
[picture p255: board chaser_led.kicad_pcb from above]

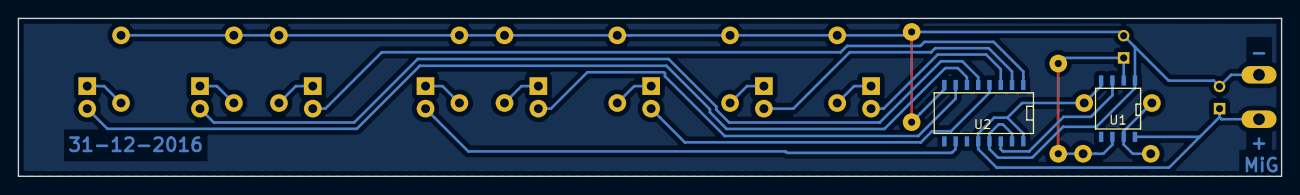
[picture p256: board chaser_led.kicad_pcb from below]

Board: 2 copper layers, 142.2 x 17.8 mm, 25 parts (2 on the bottom side), 21 nets.

Parts:
C1: 100nF; C_Disc_D3_P2.5
C2: 2.2uF; C_Radial_D5_L6_P2.5
D1, D2, D3, D4, D5, D6, D7, D8: LED_Small; LED-3MM
P1: pwr; AK300-2
R1: 33k; Resistor_Horizontal_RM7mm
R2: 47k; Resistor_Horizontal_RM7mm
R3, R4, R5, R6, R7, R8, R9, R10: 1k; Resistor_Horizontal_RM7mm
R11, R12: 0R; WireConnection_0.80mmDrill
U1: NE555; SOIC-8-N
U2: 4017; SO-16-N

Connections:
+12V: C1.1, P1.2, R1.1, U1.4, U1.8, U2.12, U2.16
GND: C1.2, C2.2, P1.1, R3.2, R4.2, R5.2, R6.2, R7.2, R8.2, R9.2, R10.2, R11.1, R11.2, U1.1, U2.8, U2.13, U2.15
unnamed: C2.1, R2.2, R12.1, R12.2, U1.2, U1.6
unnamed: D1.1, R3.1
unnamed: D1.2, U2.6
unnamed: D2.1, R4.1
unnamed: D2.2, U2.5
unnamed: D3.1, R5.1
unnamed: D3.2, U2.1
unnamed: D4.1, R6.1
unnamed: D4.2, U2.10
unnamed: D5.1, R7.1
unnamed: D5.2, U2.7
unnamed: D6.1, R8.1
unnamed: D6.2, U2.4
unnamed: D7.1, R9.1
unnamed: D7.2, U2.2
unnamed: D8.1, R10.1
unnamed: D8.2, U2.3
unnamed: R1.2, R2.1, U1.7
unnamed: U1.3, U2.14
